infernotracter/NXP_2025/src_参考/RT1021-MENU-master1/README.en.md

# RT1021的CCD代码  +++  标志位菜单支持NXP，STC，英飞凌

#### Description
1.原创标志位菜单[支持NXP，STC，英飞凌]
2.NXP 的 ccd 图像处理 代码， 提供思路
3.无控制代码

#### Software Architecture
Software architecture description

#### Installation

1.  xxxx
2.  xxxx
3.  xxxx

#### Instructions

1.  xxxx
2.  xxxx
3.  xxxx

#### Contribution

1.  Fork the repository
2.  Create Feat_xxx branch
3.  Commit your code
4.  Create Pull Request

#### Gitee Feature

1.  You can use Readme\_XXX.md to support different languages, such as Readme\_en.md, Readme\_zh.md
2.  Gitee blog [blog.gitee.com](https://blog.gitee.com)
3.  Explore open source project [https://gitee.com/explore](https://gitee.com/explore)
4.  The most valuable open source project [GVP](https://gitee.com/gvp)
5.  The manual of Gitee [https://gitee.com/help](https://gitee.com/help)
6.  The most popular members  [https://gitee.com/gitee-stars/](https://gitee.com/gitee-stars/)
