infernotracter/NXP_2025/src_主要/NXP-master/README.md

# 第十九届智能车NXP组可达鸭开源

#### 介绍
第十九届智能车竞赛，国二NXP镜头组开源资料。包含车模、技术报告、代码、硬件电路。

#### 安装教程

1.  车模检测报告
2.  技术报告
3.  鼠鼠车机械结构
4.  历史软件

#### 参与贡献

在此特别感谢（排名不分先后）：
宿迁学院自由之翼佬、湘潭大学篮球佬、赣南科技学院菜狗佬、安徽理工大学搬砖佬、重庆交通大学马戏团佬、潍坊学院王佬、安徽师范大学Ca佬、山东师范大学青山佬、北方民族大学小明佬等等，还有其他没提到但是同样给予我偌大帮助的佬们。
从刚入学对电子产生浓厚的兴趣到取得国二成绩的这段路，没有TWU群里大佬的交流与帮助，就没有今天的可达鸭！
再次感谢所有帮助我的佬们！
