infernotracter/NXP_2025/src_参考/RT1021_Library-master#3/Example/例程使用说明.txt

例程的主要作用只是告诉大家如何使用各种库函数
因此例程内的库文件不一定是最新的，当通过库例程学习完之后
请使用Seekfree_RT1021_Opensource_Library开源库进行开发。
