infernotracter/NXP_2025/src_参考/RT1021_Library-master#3/【文档】说明书 芯片手册等/RT1021入门指南/入门指南中需要的其他文档/JLINK转接板教程.pdf

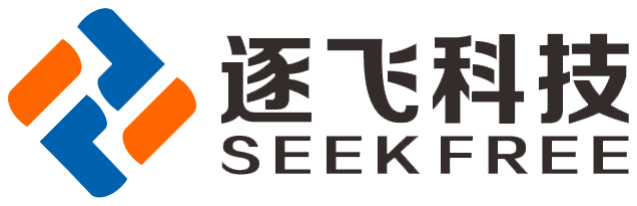
[picture p57: figure]

2019

# JLINK 转接板使用说明


JLINK 转接板使用说明 | 逐飞科技

目录

# 转接板与下载器如何连接

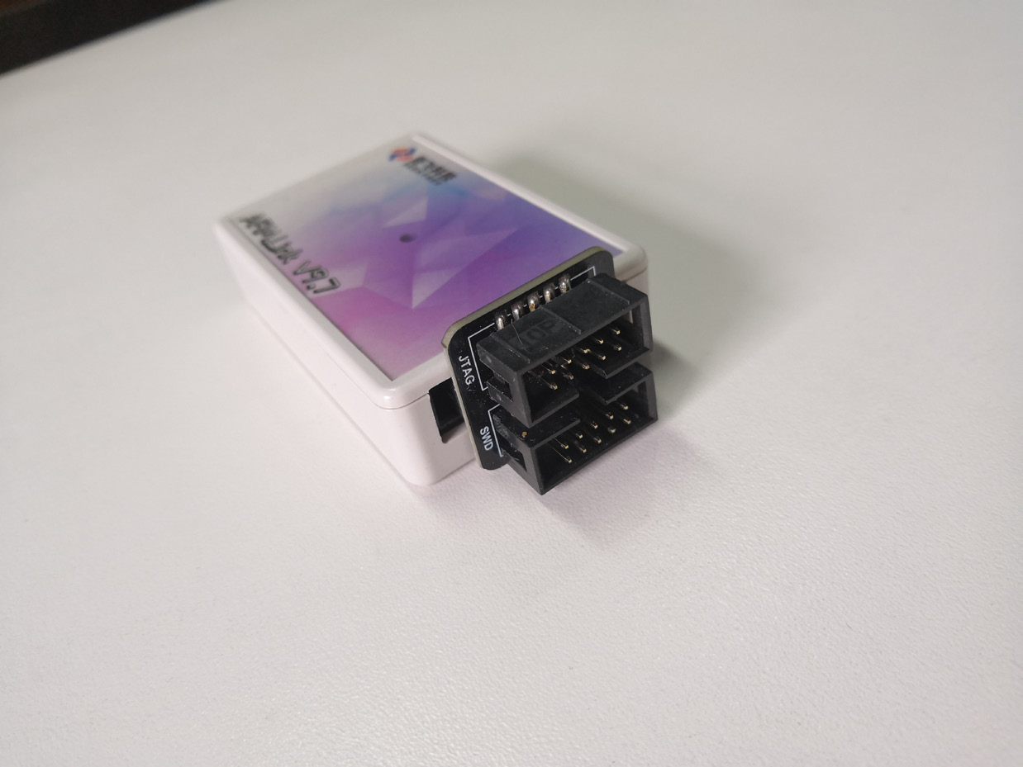
[picture p58: figure]

# 转接板与单片机如何连接

RT1021 核心板与转接板的链接如下图

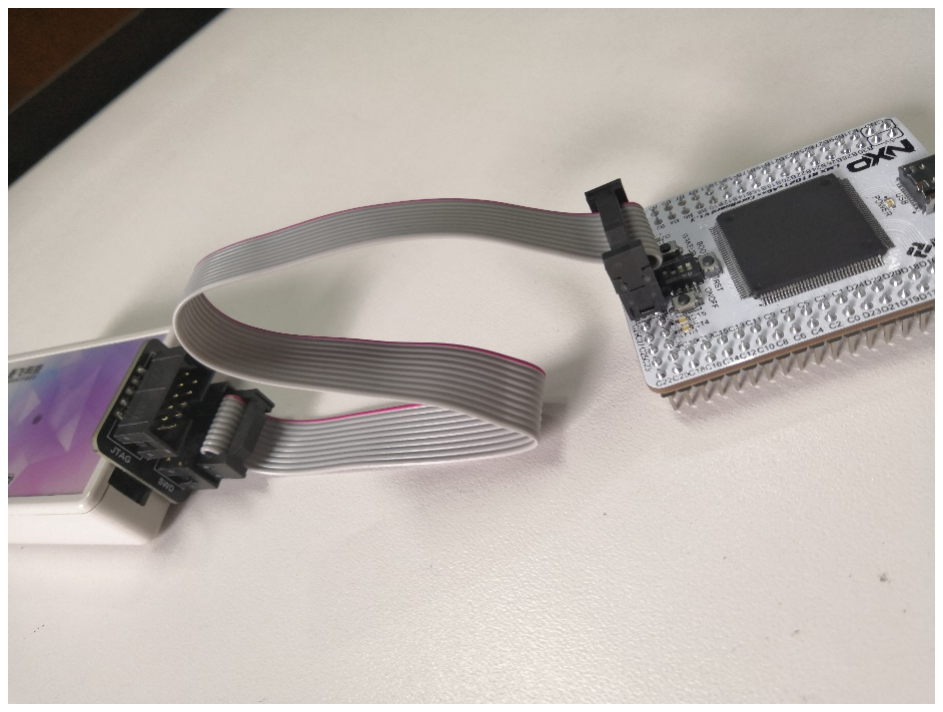
[picture p59: figure]

LPC54606 核心板与转接板的链接如下图

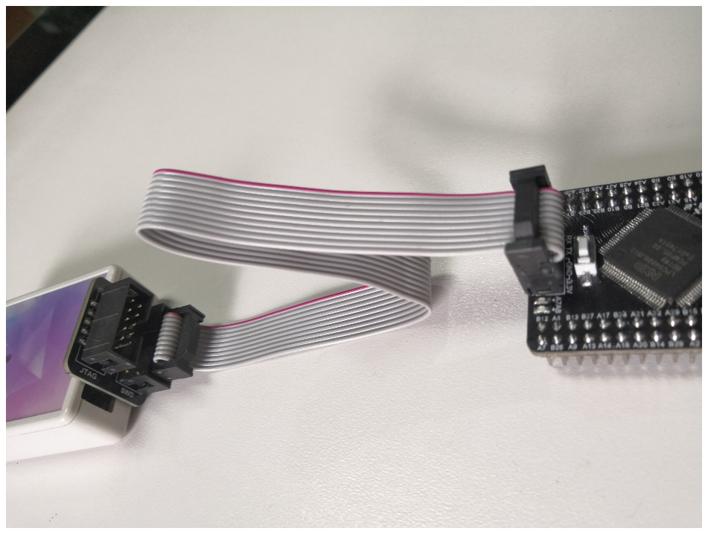
[picture p60: figure]

KEA 核心板与转接板的链接如下图

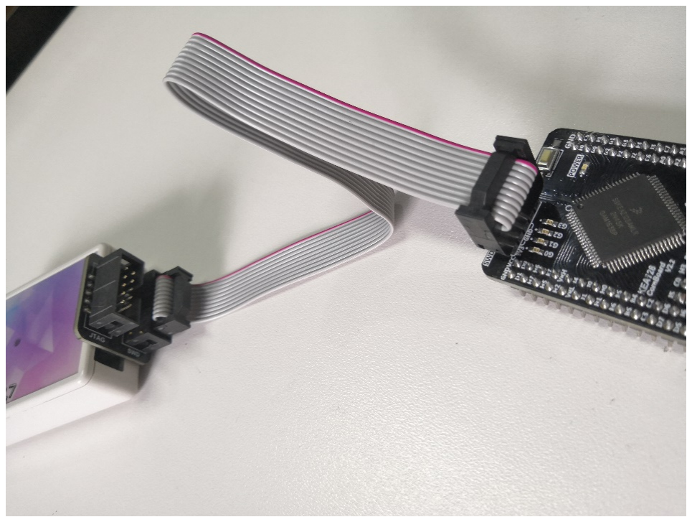
[picture p61: figure]

K60 144 引脚核心板与转接板的链接如下图

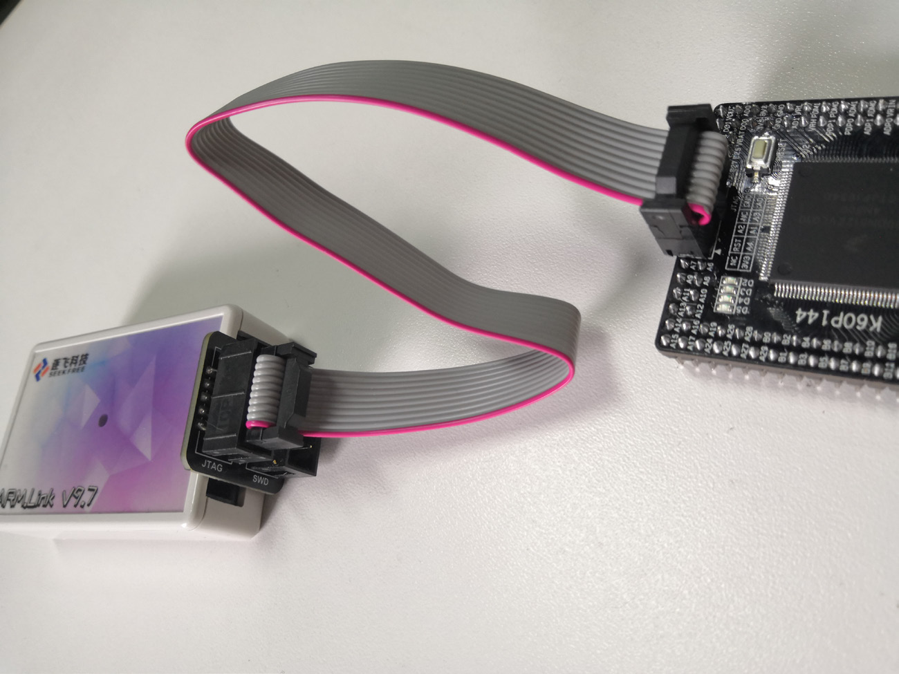
[picture p62: figure]

K60 100 引脚核心板与转接板的链接如下图

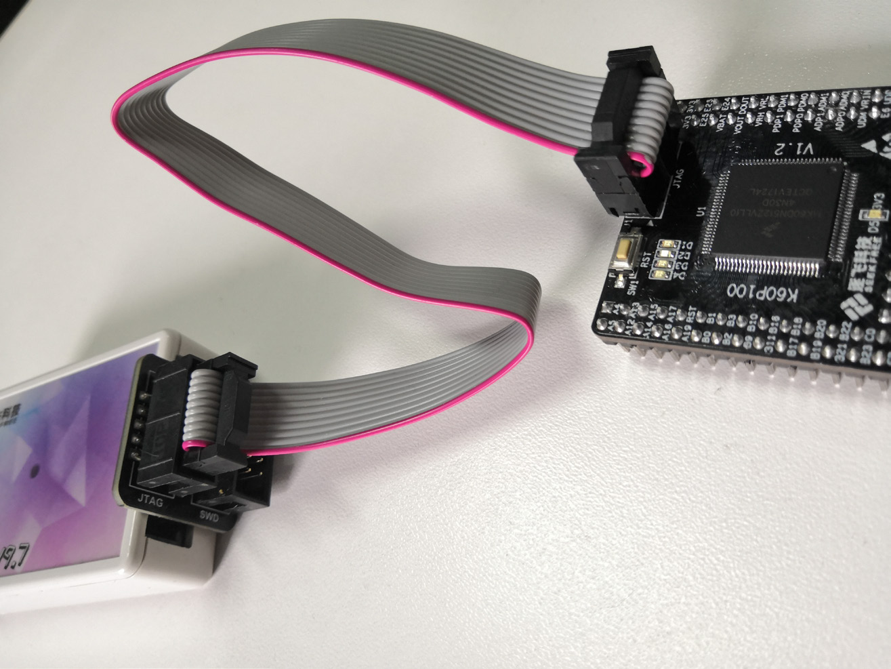
[picture p63: figure]

# 文档版本

版本号 | 日期 | 内容变更
V1.0 | 2019-03-15 | 初始版本。
