infernotracter/NXP_2025/src_主要/NXP-master/车模检测报告/前视图.jpg

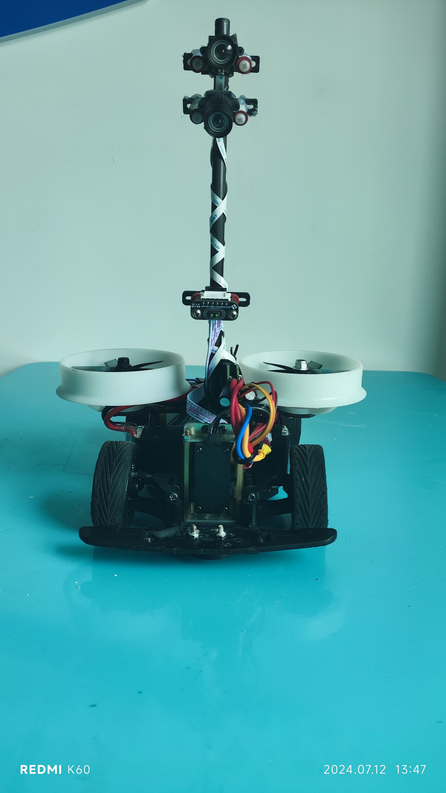
src_主要/NXP-master/车模检测报告/前视图.jpg
