infernotracter/NXP_2025/src_主要/RT1021 MicroPython核心板/【原理图】核心板原理图/【原理图】核心板原理图/RT1021 MicroPython 100P 引脚分配推荐表.png

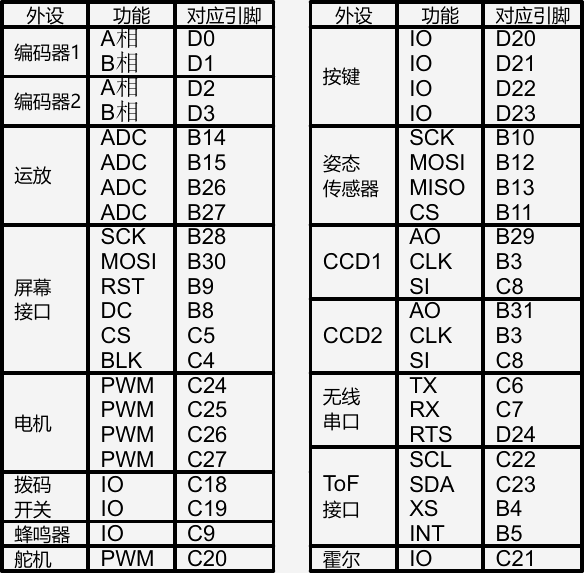
src_主要/RT1021 MicroPython核心板/【原理图】核心板原理图/【原理图】核心板原理图/RT1021 MicroPython 100P 引脚分配推荐表.png
