infernotracter/NXP_2025/src_主要/RT1021 MicroPython核心板/【文档】说明书 芯片手册等/1021MicroPython摄像头采集测试.png

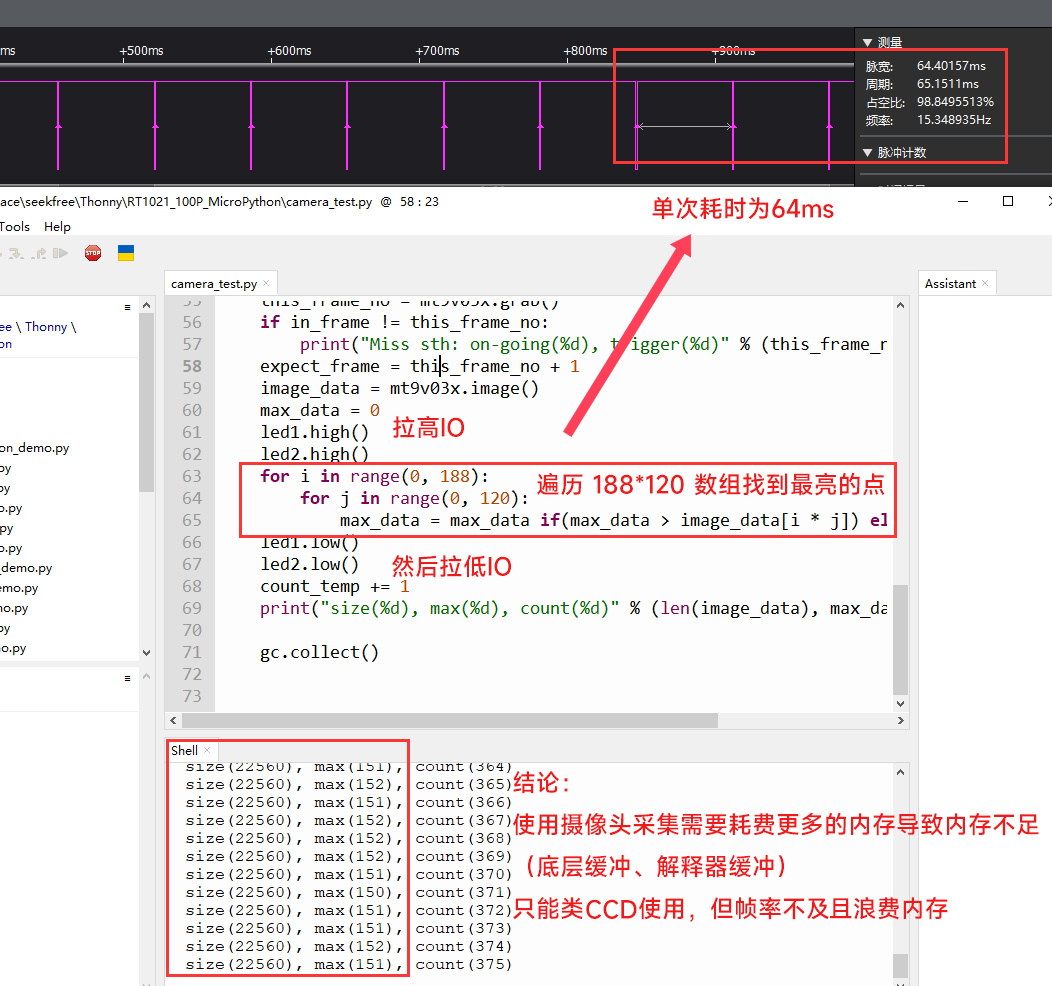
src_主要/RT1021 MicroPython核心板/【文档】说明书 芯片手册等/1021MicroPython摄像头采集测试.png
