infernotracter/NXP_2025/src_参考/2019-nxp-intelligent-car-master#3/matlab/1.bmp

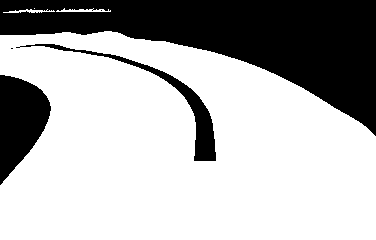
src_参考/2019-nxp-intelligent-car-master#3/matlab/1.bmp
