infernotracter/NXP_2025/src_参考/2019-nxp-intelligent-car-master#3/matlab/7.12赛道元素采集/出大环4.jpg

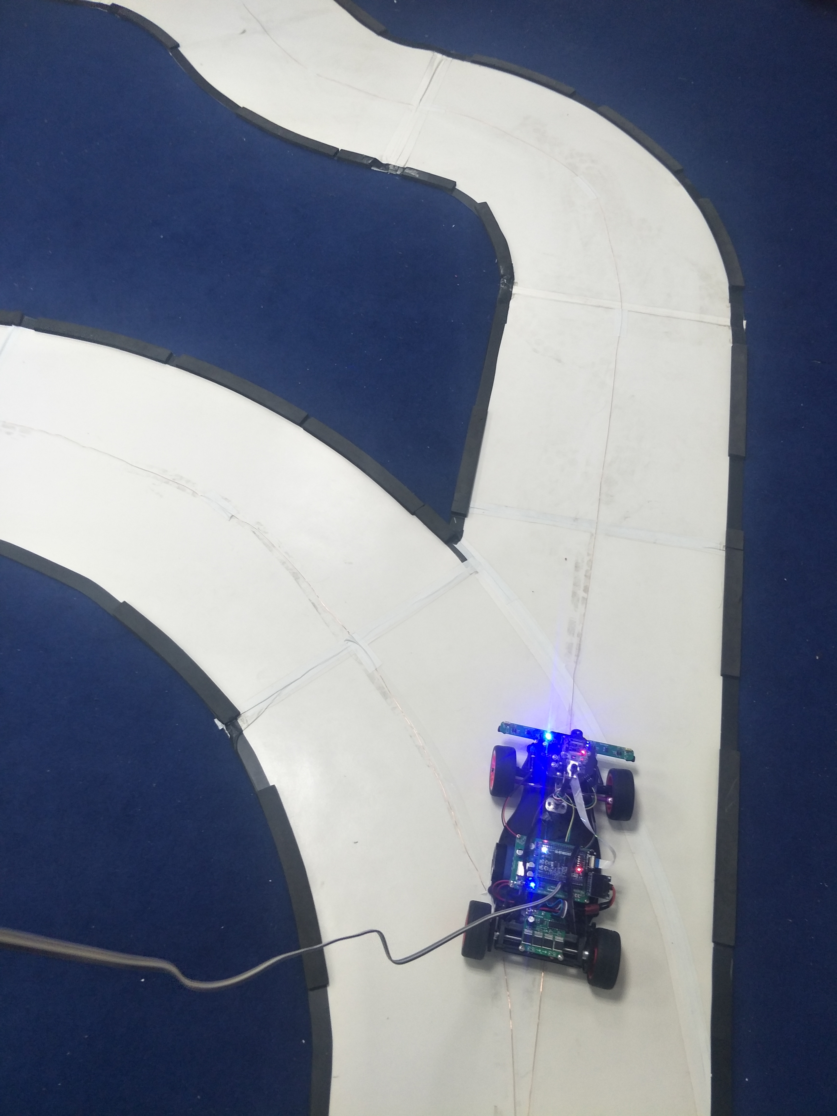
src_参考/2019-nxp-intelligent-car-master#3/matlab/7.12赛道元素采集/出大环4.jpg
