infernotracter/NXP_2025/src_参考/2019-nxp-intelligent-car-master#3/matlab/IMGtest.bmp

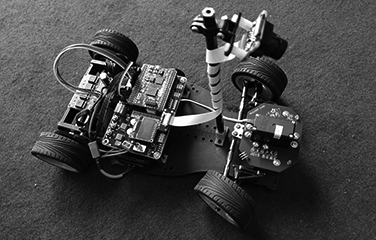
src_参考/2019-nxp-intelligent-car-master#3/matlab/IMGtest.bmp
