infernotracter/NXP_2025/src_参考/2019-nxp-intelligent-car-master#3/matlab/图像特征/十字.jpg

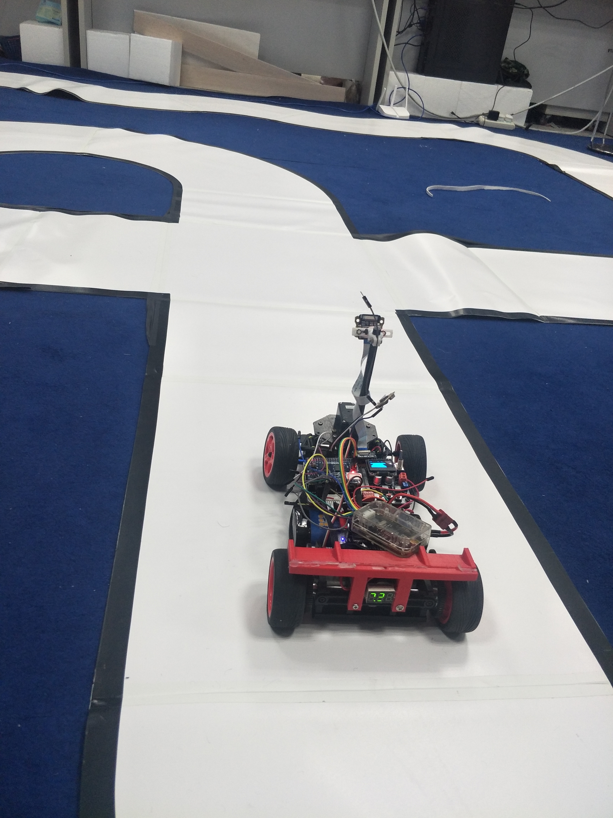
src_参考/2019-nxp-intelligent-car-master#3/matlab/图像特征/十字.jpg
