infernotracter/NXP_2025/src_参考/2019-nxp-intelligent-car-master#3/matlab/电机测试/0.2-0.1（肉眼可见不错）.txt.jpg

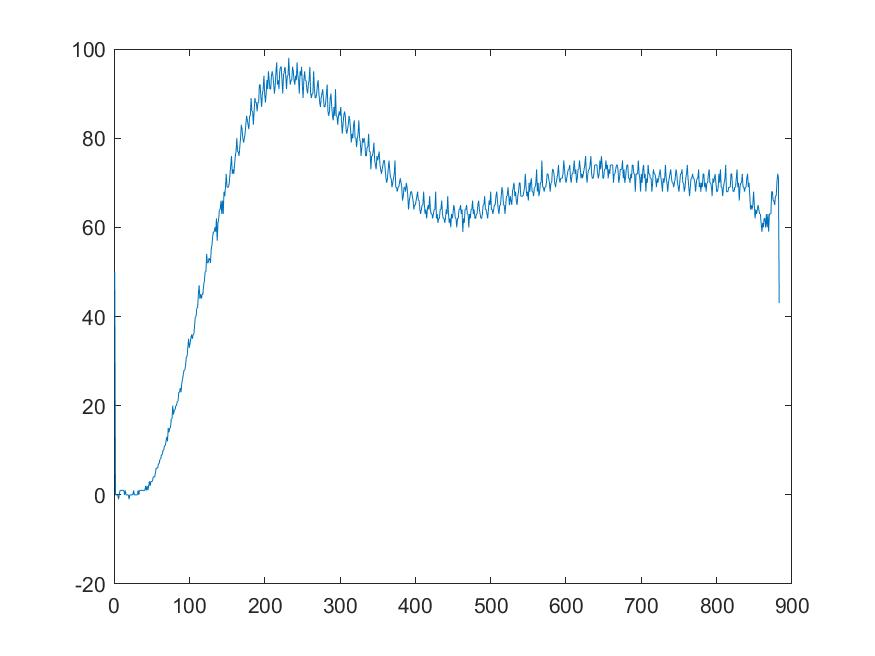
src_参考/2019-nxp-intelligent-car-master#3/matlab/电机测试/0.2-0.1（肉眼可见不错）.txt.jpg
