infernotracter/NXP_2025/src_参考/2019-nxp-intelligent-car-master#3/matlab/电机测试/0.5-0.1.txt.jpg

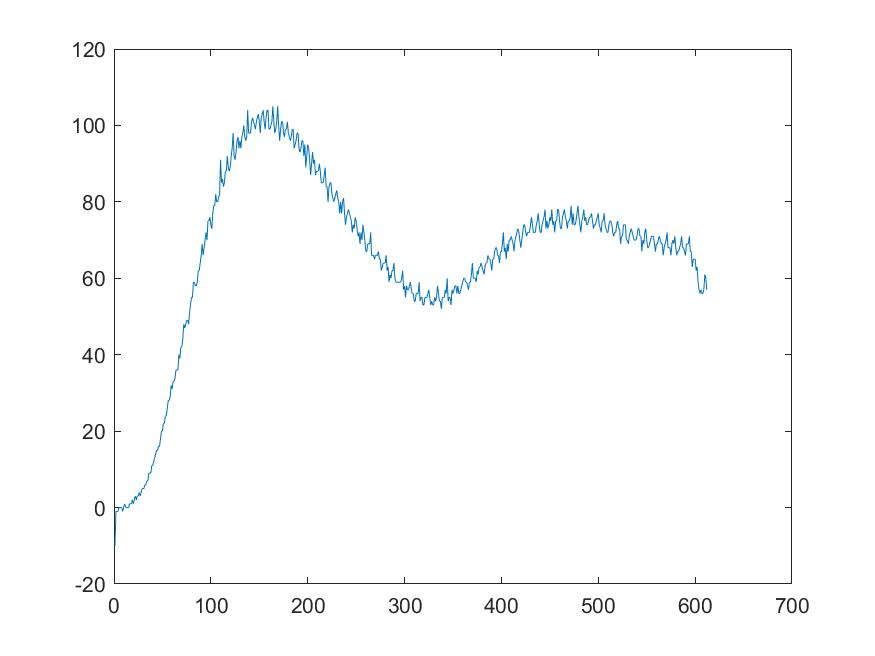
src_参考/2019-nxp-intelligent-car-master#3/matlab/电机测试/0.5-0.1.txt.jpg
