infernotracter/NXP_2025/src_参考/2019-nxp-intelligent-car-master#3/matlab/电机测试/1.0-0.2.txt.jpg

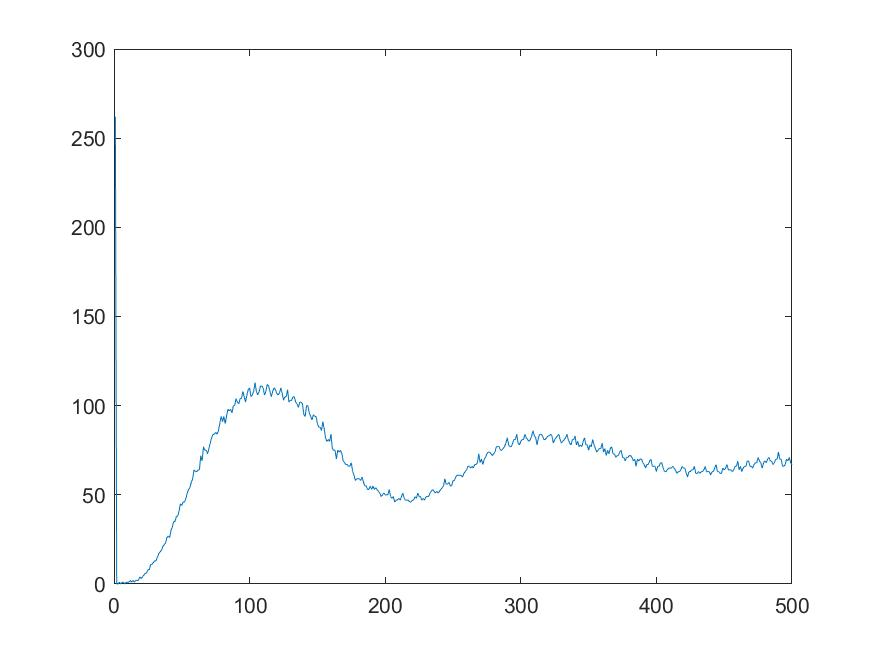
src_参考/2019-nxp-intelligent-car-master#3/matlab/电机测试/1.0-0.2.txt.jpg
