infernotracter/NXP_2025/src_参考/2019-nxp-intelligent-car-master#3/matlab/道路类型判断/2.bmp

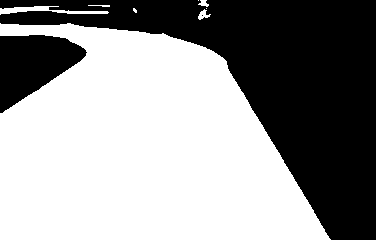
src_参考/2019-nxp-intelligent-car-master#3/matlab/道路类型判断/2.bmp
