infernotracter/NXP_2025/src_参考/2019-nxp-intelligent-car-master#3/matlab/道路类型判断/7.12.BMP

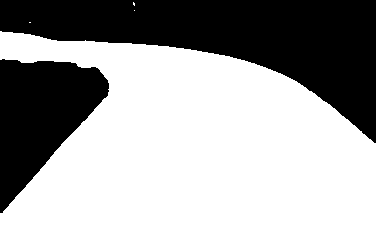
src_参考/2019-nxp-intelligent-car-master#3/matlab/道路类型判断/7.12.BMP
