infernotracter/NXP_2025/src_参考/CCD_Smart_Car-main/FullCircle.gif

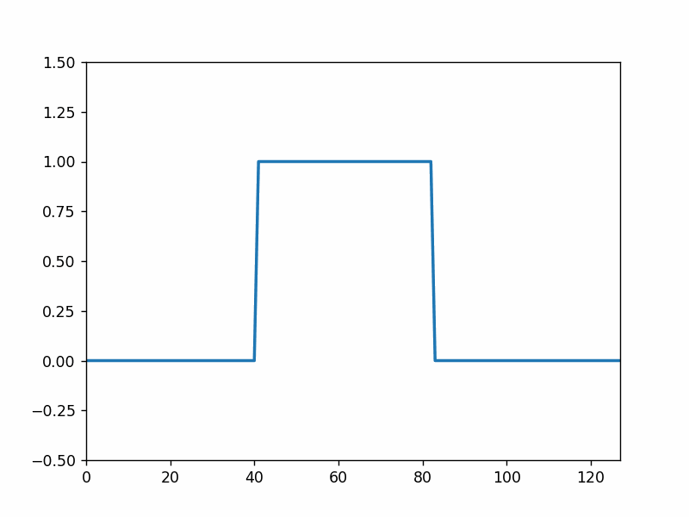
src_参考/CCD_Smart_Car-main/FullCircle.gif
