infernotracter/NXP_2025/src_参考/RT1021-MENU-master1/菜单形式.png

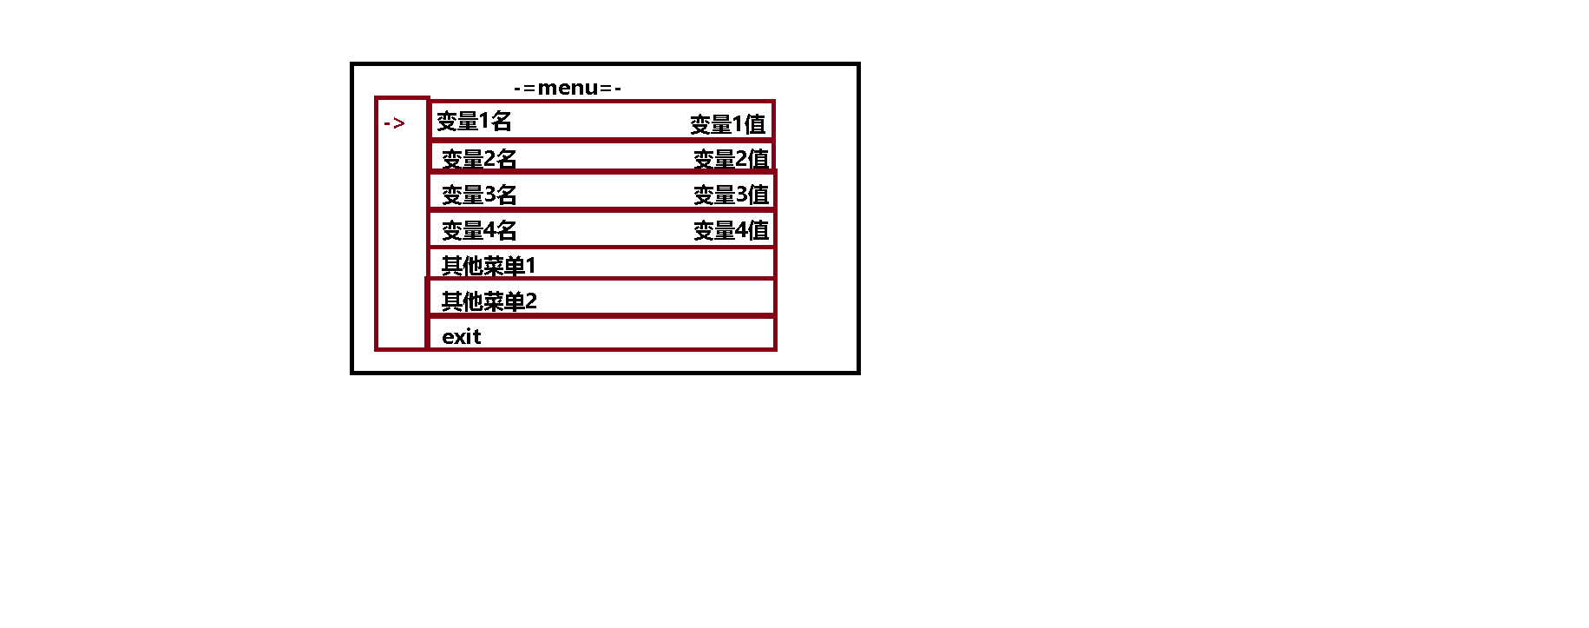
src_参考/RT1021-MENU-master1/菜单形式.png
