infernotracter/NXP_2025/src_参考/smart-car-main1/PCB/SCH_openart显示屏转接板_1-Sheet_1_2023-07-10.png

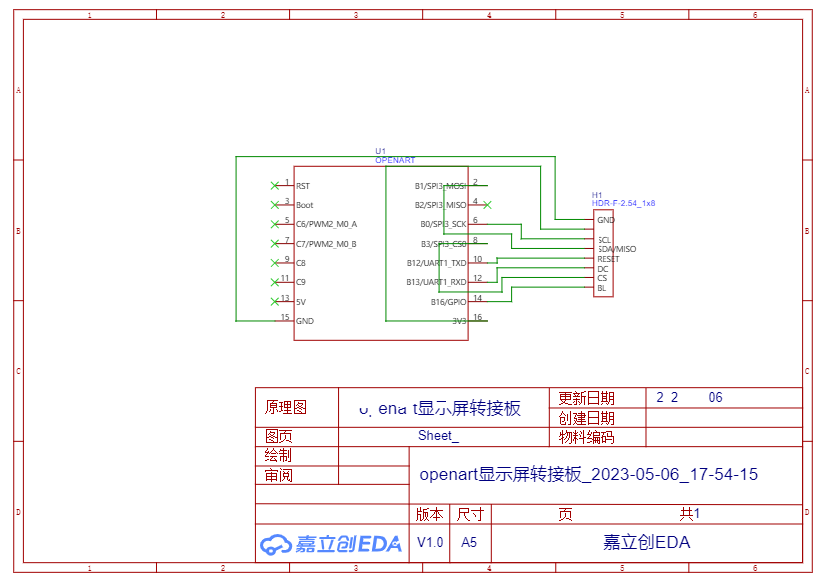
src_参考/smart-car-main1/PCB/SCH_openart显示屏转接板_1-Sheet_1_2023-07-10.png
