infernotracter/NXP_2025/src_参考/smart-car-main1/PCB/SCH_主板_1_1-rt0164主板原理图_2023-07-10.png

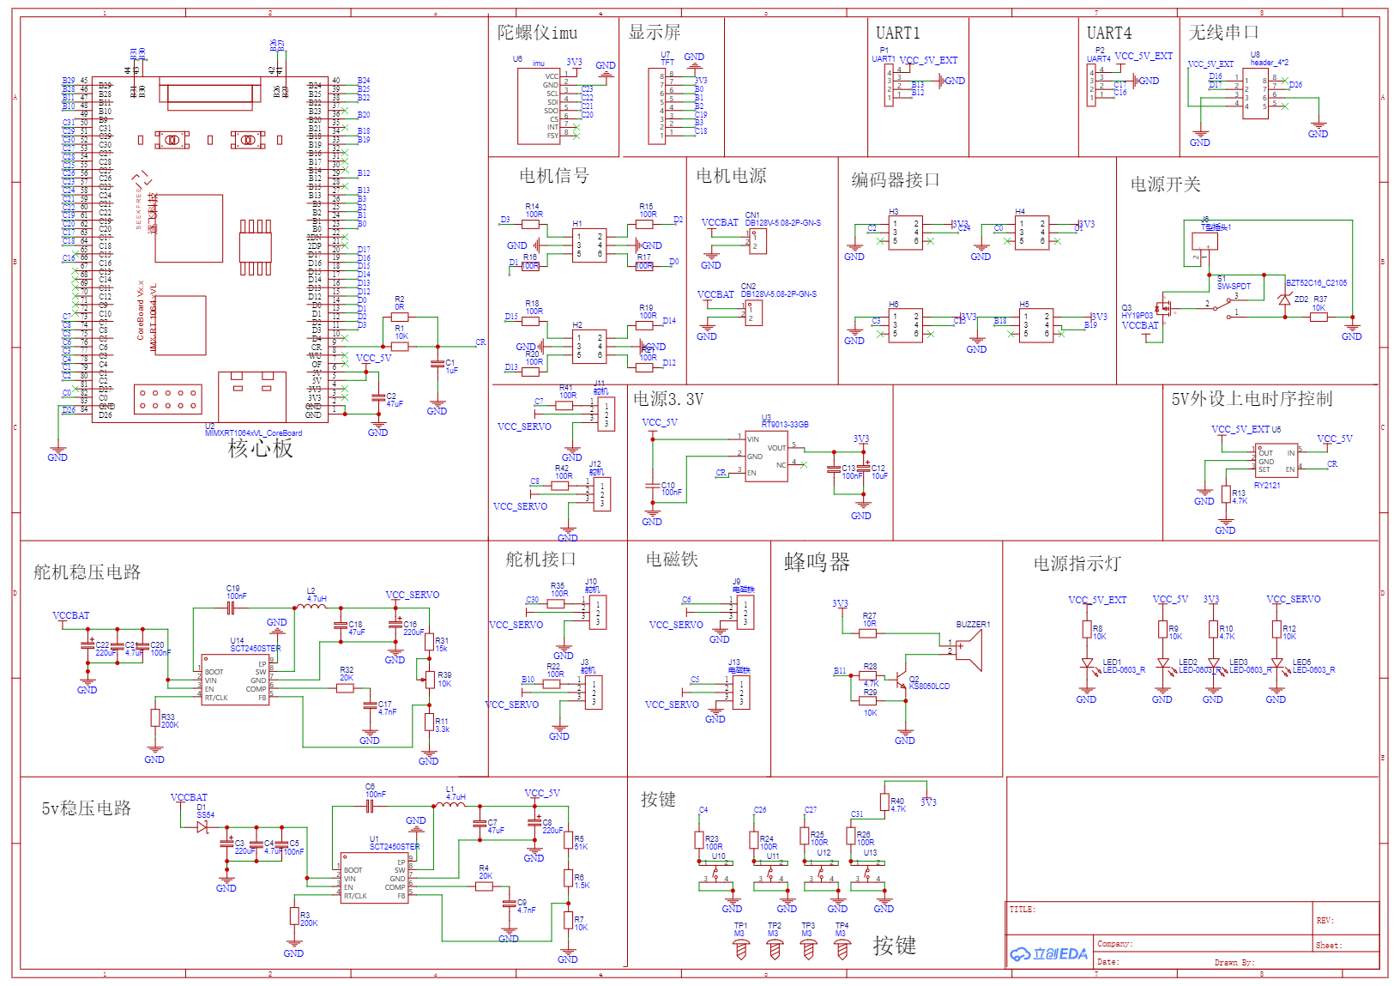
src_参考/smart-car-main1/PCB/SCH_主板_1_1-rt0164主板原理图_2023-07-10.png
