infernotracter/NXP_2025/src_参考/smart-car-main1/PCB/SCH_主板_2_2-rt0164主板原理图_2023-08-16.png

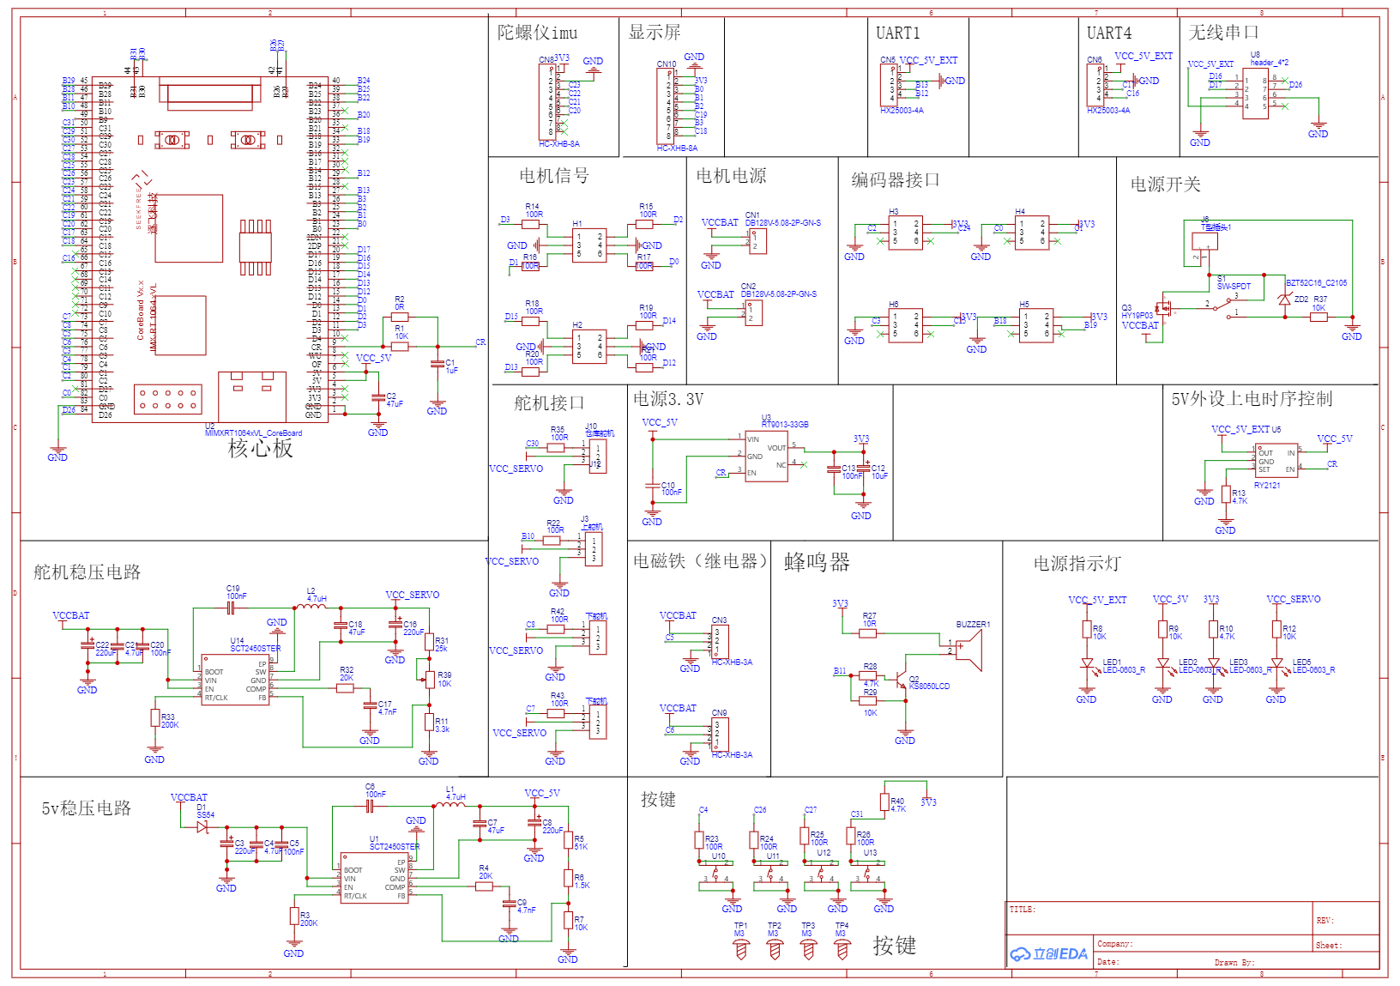
src_参考/smart-car-main1/PCB/SCH_主板_2_2-rt0164主板原理图_2023-08-16.png
