infernotracter/NXP_2025/src_参考/smart-car-main1/PCB/SCH_驱动板_1-DRV8701_2023-07-10.png

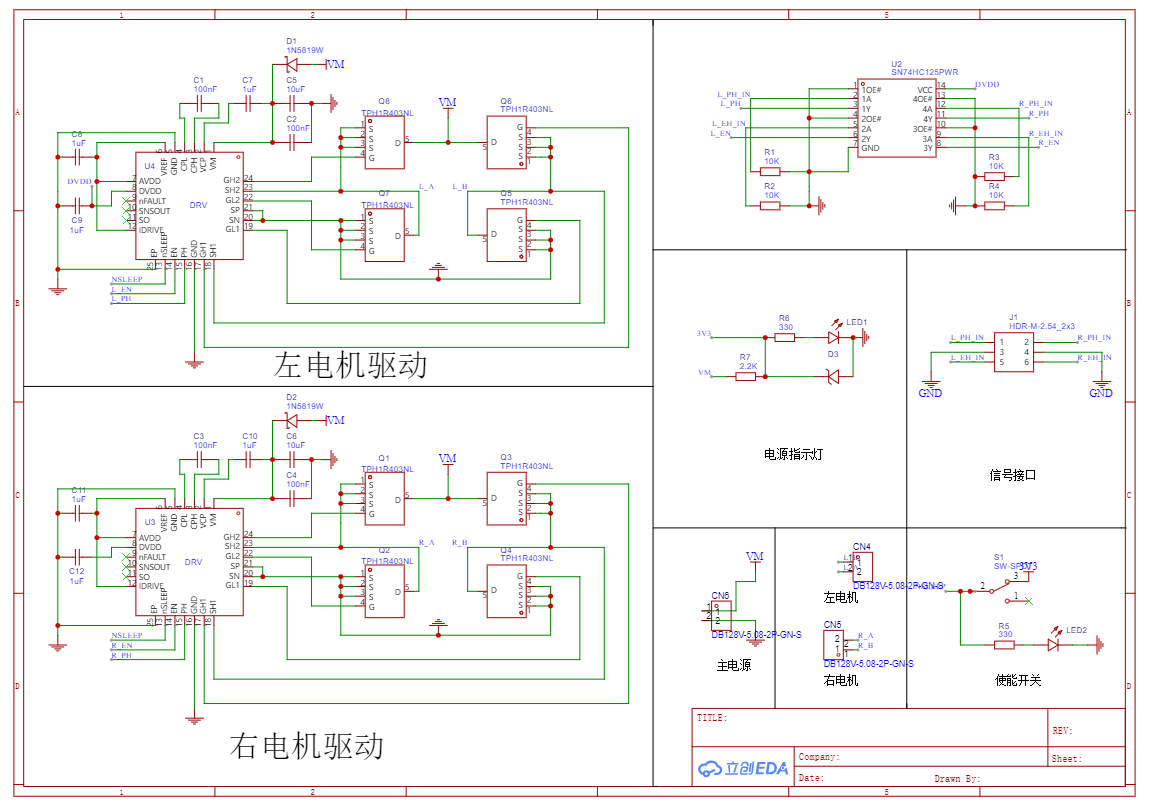
src_参考/smart-car-main1/PCB/SCH_驱动板_1-DRV8701_2023-07-10.png
