infernotracter/NXP_2025/src_参考/smart-car-main1/PCB/继电器原理图.png

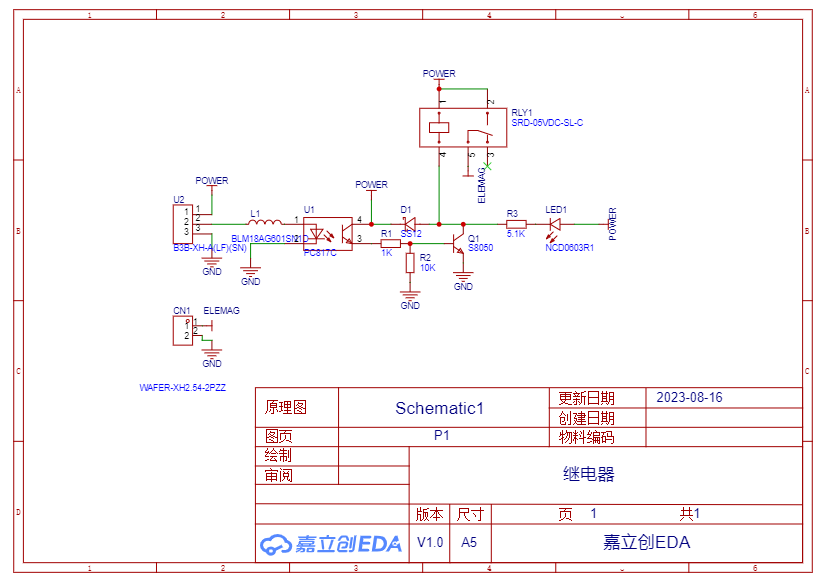
src_参考/smart-car-main1/PCB/继电器原理图.png
