infernotracter/NXP_2025/src_参考/RT1021_Library-master#3/Example/12-Specify Variable Position Demo/RT1021端口对应表格.xlsx

GPIO编号 | PAD名称
RT1021 没有端口A 端口E
B0 | GPIO_AD_B0_00
B1 | GPIO_AD_B0_01
B2 | GPIO_AD_B0_02
B3 | GPIO_AD_B0_03
B4 | GPIO_AD_B0_04
B5 | GPIO_AD_B0_05
B6 | GPIO_AD_B0_06
B7 | GPIO_AD_B0_07
B8 | GPIO_AD_B0_08
B9 | GPIO_AD_B0_09
B10 | GPIO_AD_B0_10
B11 | GPIO_AD_B0_11
B12 | GPIO_AD_B0_12
B13 | GPIO_AD_B0_13
B14 | GPIO_AD_B0_14
B15 | GPIO_AD_B0_15
B16 | GPIO_AD_B1_00
B17 | GPIO_AD_B1_01
B18 | GPIO_AD_B1_02
B19 | GPIO_AD_B1_03
B20 | GPIO_AD_B1_04
B21 | GPIO_AD_B1_05
B22 | GPIO_AD_B1_06
B23 | GPIO_AD_B1_07
B24 | GPIO_AD_B1_08
B25 | GPIO_AD_B1_09
B26 | GPIO_AD_B1_10
B27 | GPIO_AD_B1_11
B28 | GPIO_AD_B1_12
B29 | GPIO_AD_B1_13
B30 | GPIO_AD_B1_14
B31 | GPIO_AD_B1_15
C0 | GPIO_EMC_00
C1 | GPIO_EMC_01
C2 | GPIO_EMC_02
C3 | GPIO_EMC_03
C4 | GPIO_EMC_04
C5 | GPIO_EMC_05
C6 | GPIO_EMC_06
C7 | GPIO_EMC_07
C8 | GPIO_EMC_08
C9 | GPIO_EMC_09
C10 | GPIO_EMC_10
C11 | GPIO_EMC_11
C12 | GPIO_EMC_12
C13 | GPIO_EMC_13
C14 | GPIO_EMC_14
C15 | GPIO_EMC_15
C16 | GPIO_EMC_16
C17 | GPIO_EMC_17
C18 | GPIO_EMC_18
C19 | GPIO_EMC_19
C20 | GPIO_EMC_20
C21 | GPIO_EMC_21
C22 | GPIO_EMC_22
C23 | GPIO_EMC_23
C24 | GPIO_EMC_24
C25 | GPIO_EMC_25
C26 | GPIO_EMC_26
C27 | GPIO_EMC_27
C28 | GPIO_EMC_28
C29 | GPIO_EMC_29
C30 | GPIO_EMC_30
C31 | GPIO_EMC_31
D0 | GPIO_EMC_32
D1 | GPIO_EMC_33
D2 | GPIO_EMC_34
D3 | GPIO_EMC_35
D4 | GPIO_EMC_36
D5 | GPIO_EMC_37
D6 | GPIO_EMC_38
D7 | GPIO_EMC_39
D8 | GPIO_EMC_40
D9 | GPIO_EMC_41
D10 | 没有此引脚
D11 | 没有此引脚
D12 | 没有此引脚
D13 | GPIO_SD_B0_00
D14 | GPIO_SD_B0_01
D15 | GPIO_SD_B0_02
D16 | GPIO_SD_B0_03
D17 | GPIO_SD_B0_04
D18 | GPIO_SD_B0_05
D19 | GPIO_SD_B0_06
D20 | GPIO_SD_B1_00
D21 | GPIO_SD_B1_01
D22 | GPIO_SD_B1_02
D23 | GPIO_SD_B1_03
D24 | GPIO_SD_B1_04
D25 | GPIO_SD_B1_05
D26 | GPIO_SD_B1_06
D27 | GPIO_SD_B1_07
D28 | GPIO_SD_B1_08
D29 | GPIO_SD_B1_09
D30 | GPIO_SD_B1_10
D31 | GPIO_SD_B1_11
