infernotracter/NXP_2025/src_主要/NXP-master/鼠鼠车机械结构/轮胎/一体模具.SLDASM

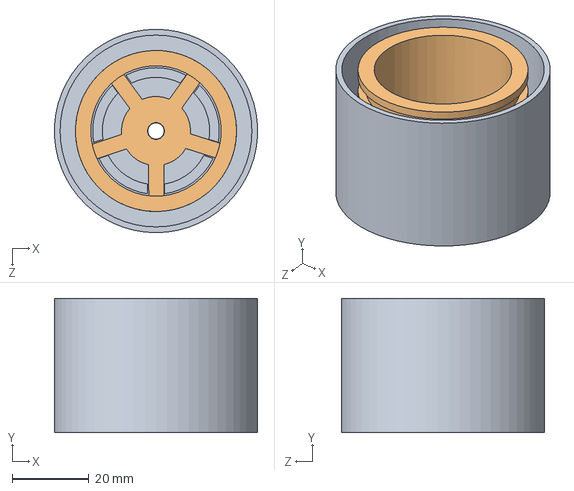
[picture p141: CAD file, 2025-02-13]
src_主要/NXP-master/鼠鼠车机械结构/轮胎/一体模具.SLDASM
52.9 x 35.0 x 53.0 mm
模具外壁
模具车轮
