infernotracter/NXP_2025/src_参考/smart-car-main1/model/智能视觉车四分类/智能视觉车1.SLDASM

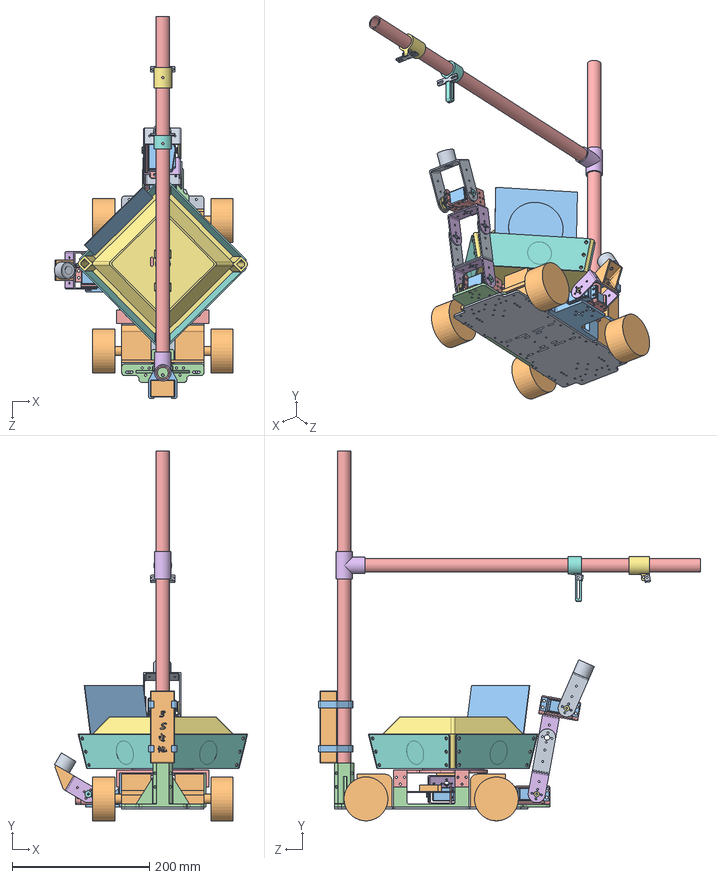
[picture p142: CAD file, 2025-02-19]
src_参考/smart-car-main1/model/智能视觉车四分类/智能视觉车1.SLDASM
282.1 x 539.5 x 557.5 mm
M车底盘
电机替代 x 2
舵机1 x 4
前机械臂支架
万能支架 x 3
短U支架 x 3
舵盘 x 4
杯式轴承 x 3
长U支架 x 2
电路板底板
左侧支架
右侧支架
储物仓支架
推力轴承
储物仓
仓门 x 4
电磁铁 x 2
电磁铁支架
卡片
摄像头支架底pvc
pvc管 x 2
pvc三通
摄像头支架1pvc
摄像头支架2pvc
逐飞摄像头支架连接件 x 2
电池
电池扣 x 2
