infernotracter/NXP_2025/src_主要/NXP-master/鼠鼠车机械结构/侧壁/电老鼠.SLDPRT

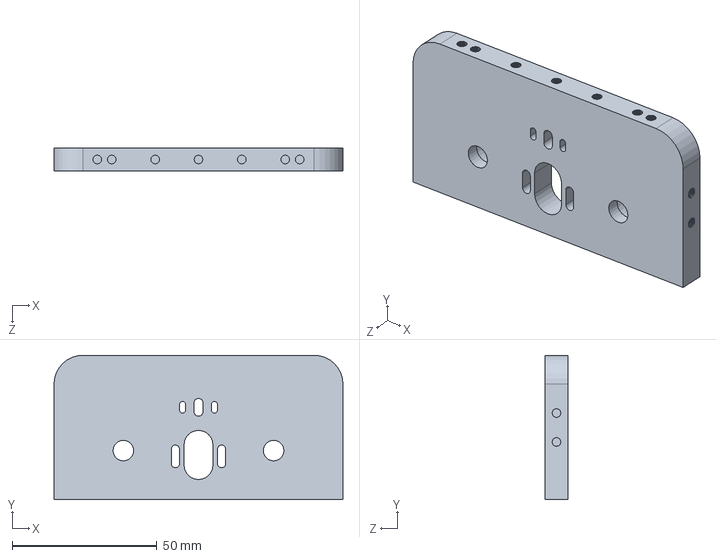
[picture p143: CAD file, 2025-02-13]
src_主要/NXP-master/鼠鼠车机械结构/侧壁/电老鼠.SLDPRT
100.0 x 50.0 x 8.00 mm
