infernotracter/NXP_2025/src_主要/NXP-master/鼠鼠车机械结构/底盘/底板.SLDPRT

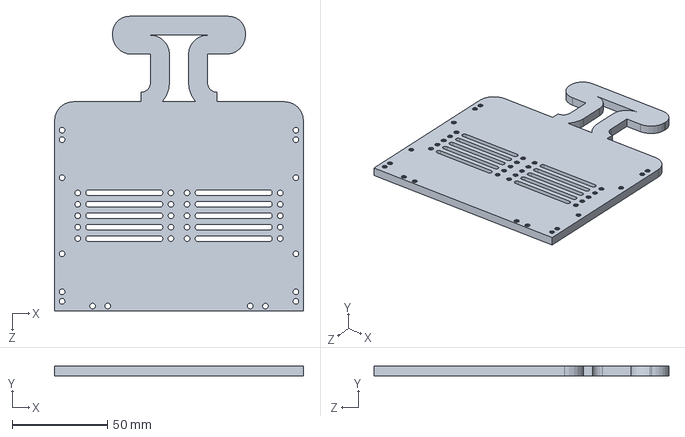
[picture p144: CAD file, 2025-02-13]
src_主要/NXP-master/鼠鼠车机械结构/底盘/底板.SLDPRT
131.0 x 5.00 x 155.0 mm
