infernotracter/NXP_2025/src_主要/NXP-master/鼠鼠车机械结构/桨叶/桨叶.SLDPRT

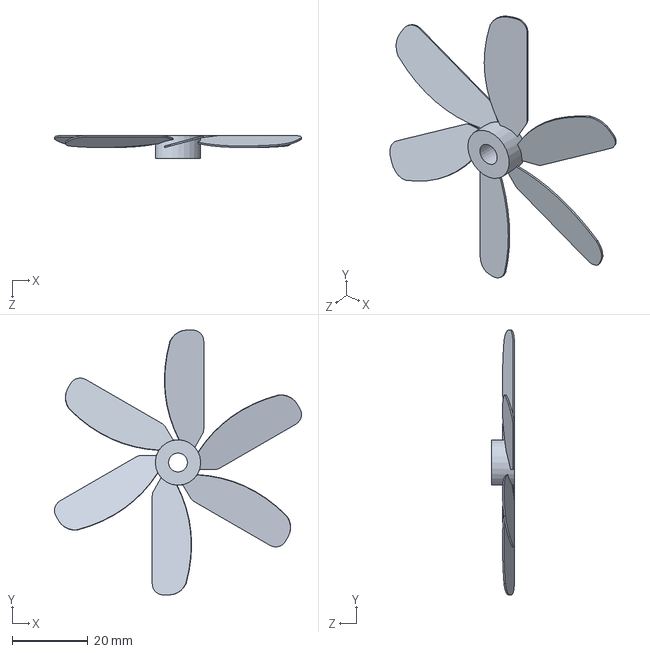
[picture p145: CAD file, 2025-02-13]
src_主要/NXP-master/鼠鼠车机械结构/桨叶/桨叶.SLDPRT
65.3 x 70.0 x 6.00 mm
