infernotracter/NXP_2025/src_主要/NXP-master/鼠鼠车机械结构/电机/rs380 motor.SLDPRT

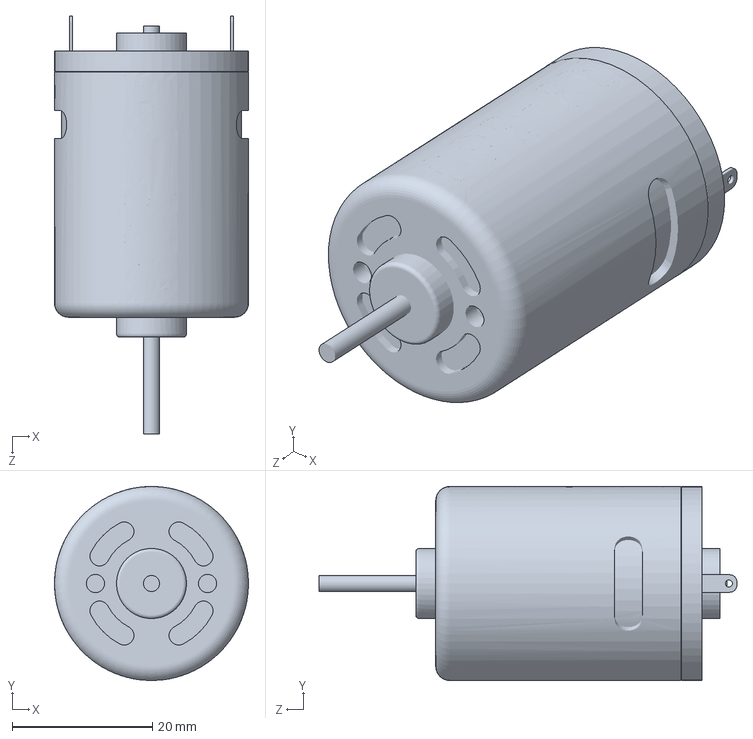
[picture p146: CAD file, 2025-02-13]
src_主要/NXP-master/鼠鼠车机械结构/电机/rs380 motor.SLDPRT
27.7 x 27.7 x 59.7 mm
