infernotracter/NXP_2025/src_主要/NXP-master/鼠鼠车机械结构/齿轮/齿轮.SLDPRT

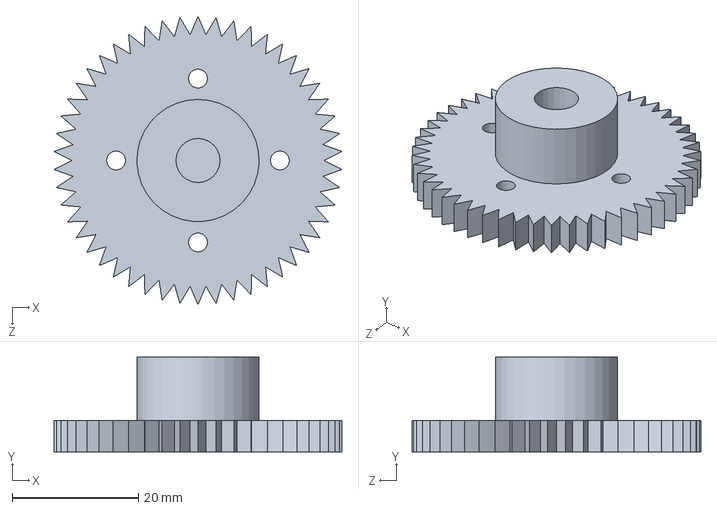
[picture p147: CAD file, 2025-02-13]
src_主要/NXP-master/鼠鼠车机械结构/齿轮/齿轮.SLDPRT
45.7 x 15.0 x 45.8 mm
