infernotracter/NXP_2025/src_参考/smart-car-main1/model/智能视觉车四分类/电磁铁支架.SLDPRT

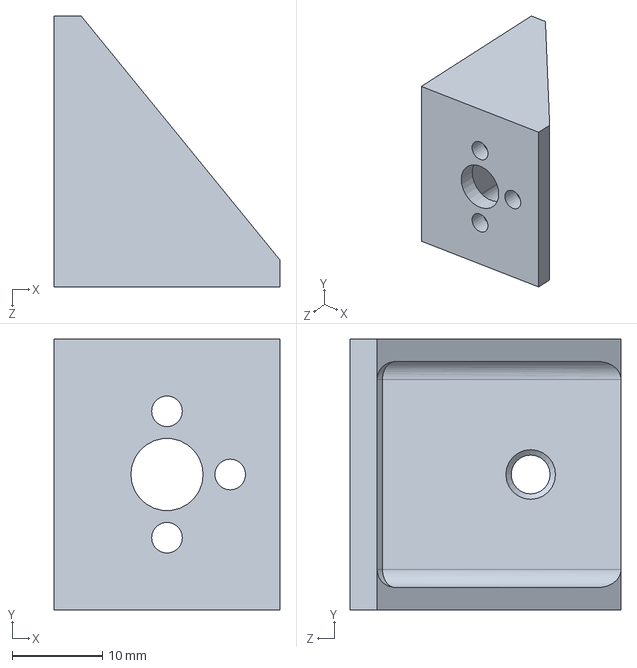
[picture p148: CAD file, 2025-02-19]
src_参考/smart-car-main1/model/智能视觉车四分类/电磁铁支架.SLDPRT
25.0 x 30.0 x 30.0 mm
