infernotracter/NXP_2025/src_主要/NXP-master/鼠鼠车机械结构/侧壁/侧壁.SLDPRT

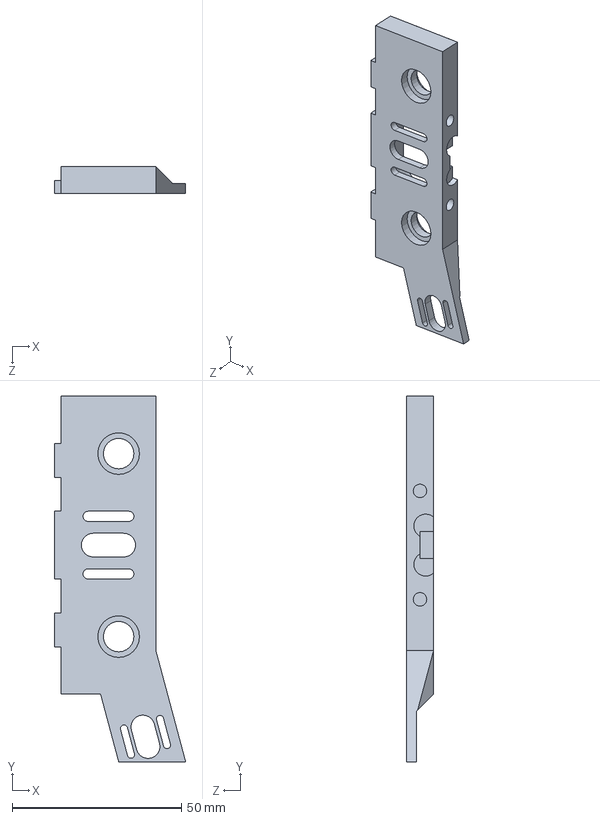
[picture p149: CAD file, 2025-02-13]
src_主要/NXP-master/鼠鼠车机械结构/侧壁/侧壁.SLDPRT
38.8 x 108.0 x 8.00 mm
