infernotracter/NXP_2025/src_主要/NXP-master/鼠鼠车机械结构/底盘/底盘.SLDPRT

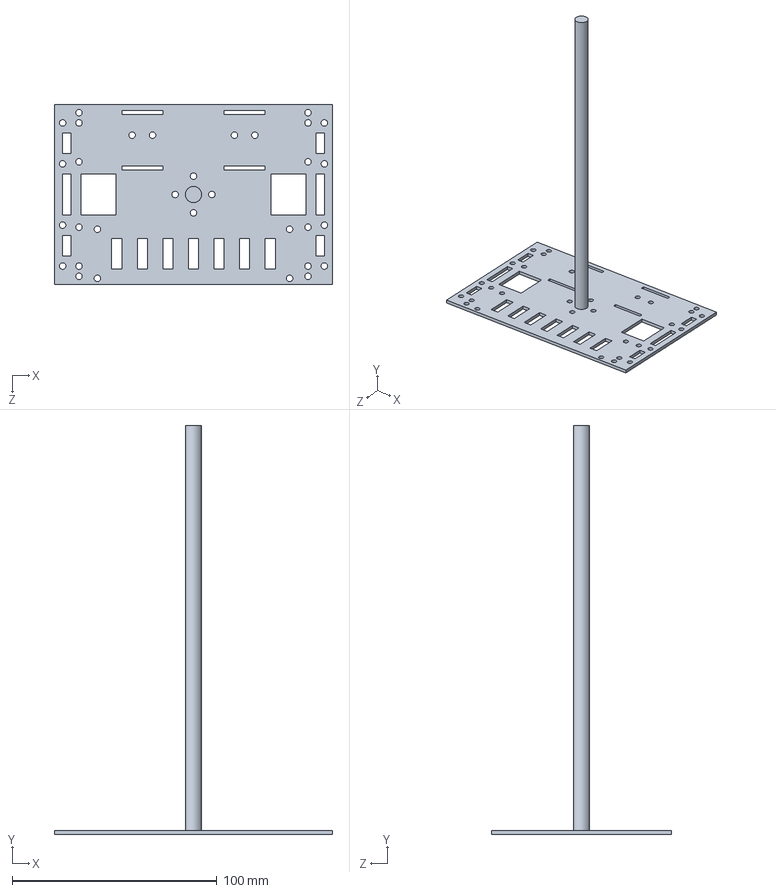
[picture p150: CAD file, 2025-02-13]
src_主要/NXP-master/鼠鼠车机械结构/底盘/底盘.SLDPRT
136.0 x 200.0 x 88.0 mm
