infernotracter/NXP_2025/src_主要/NXP-master/鼠鼠车机械结构/桨叶/保护罩子.SLDPRT

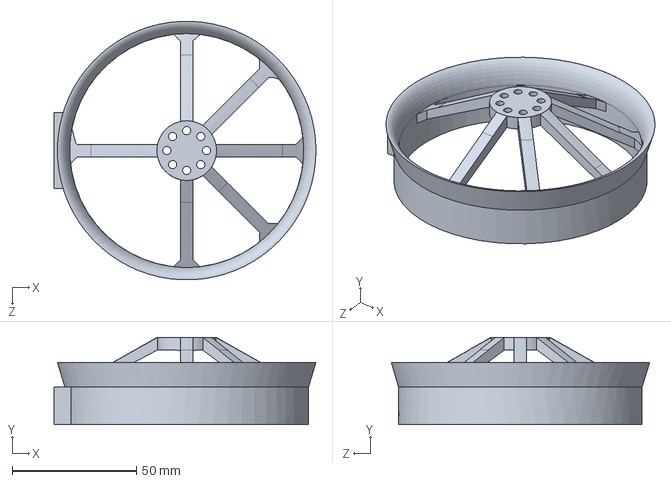
[picture p151: CAD file, 2025-02-13]
src_主要/NXP-master/鼠鼠车机械结构/桨叶/保护罩子.SLDPRT
105.4 x 35.0 x 104.0 mm
