infernotracter/NXP_2025/src_主要/NXP-master/鼠鼠车机械结构/电机/电机.SLDPRT

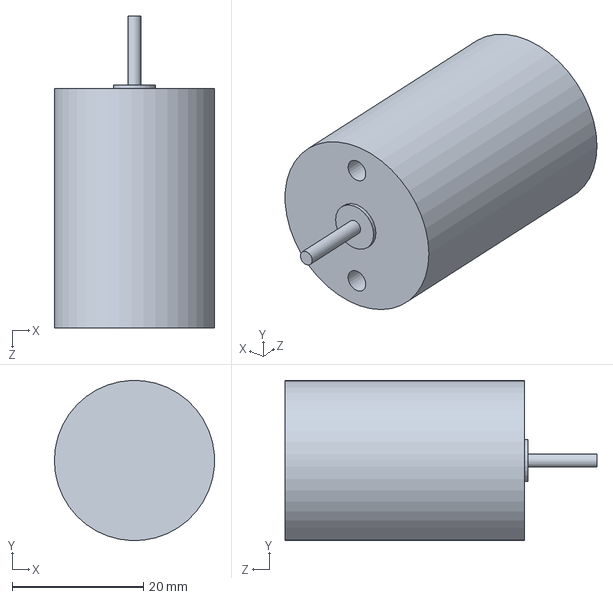
[picture p152: CAD file, 2025-02-13]
src_主要/NXP-master/鼠鼠车机械结构/电机/电机.SLDPRT
24.4 x 24.4 x 47.5 mm
