infernotracter/NXP_2025/src_主要/NXP-master/鼠鼠车机械结构/轮胎/模具外壁.SLDPRT

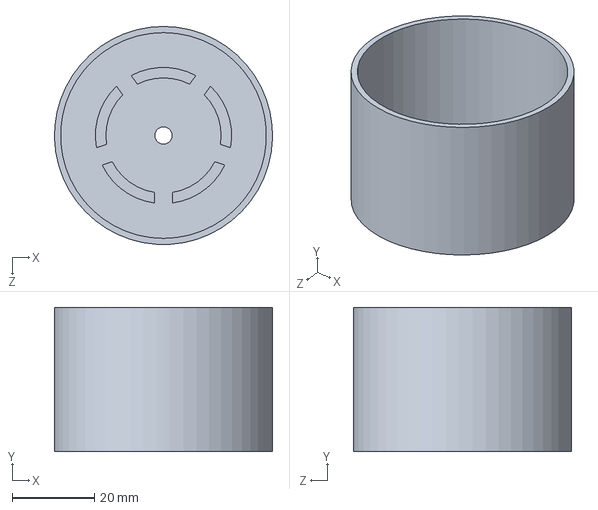
[picture p153: CAD file, 2025-02-13]
src_主要/NXP-master/鼠鼠车机械结构/轮胎/模具外壁.SLDPRT
53.0 x 35.0 x 53.0 mm
