infernotracter/NXP_2025/src_主要/NXP-master/鼠鼠车机械结构/齿轮/齿轮v2.STL

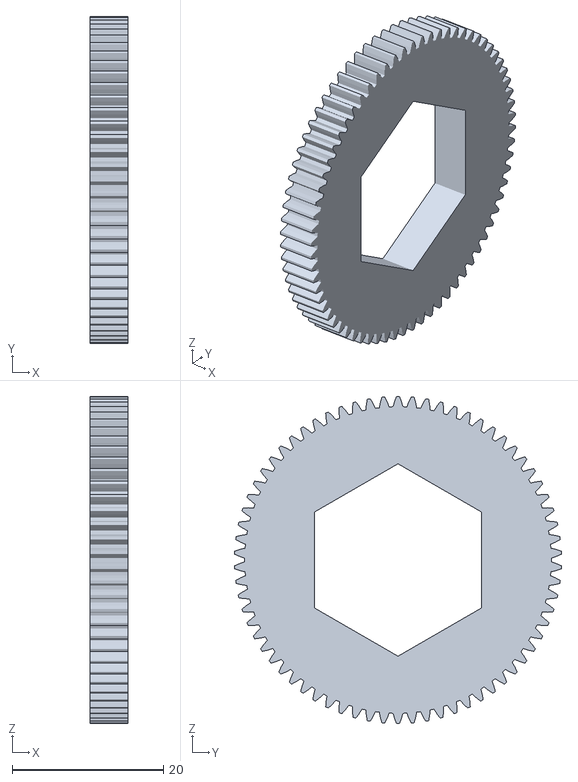
[picture p154: CAD file, 2025-02-13]
src_主要/NXP-master/鼠鼠车机械结构/齿轮/齿轮v2.STL
5.00 x 43.2 x 43.2
