infernotracter/NXP_2025/src_参考/smart-car-main1/model/智能视觉车四分类/逐飞摄像头支架连接件.SLDPRT

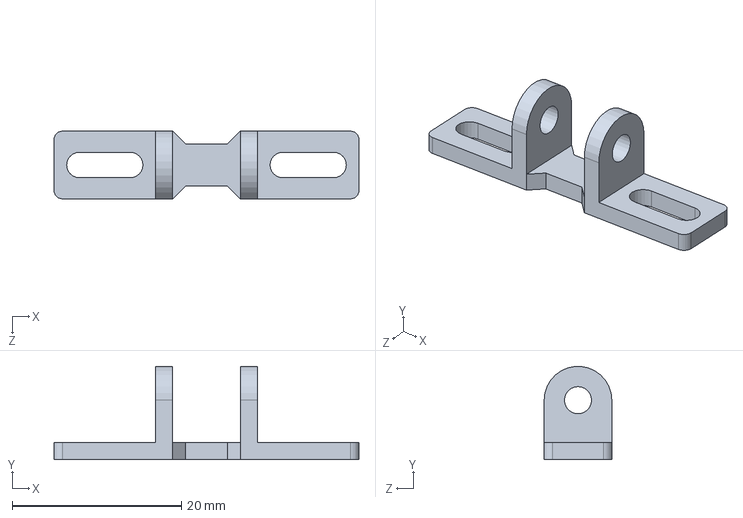
[picture p155: CAD file, 2025-02-19]
src_参考/smart-car-main1/model/智能视觉车四分类/逐飞摄像头支架连接件.SLDPRT
36.0 x 11.0 x 8.00 mm
