infernotracter/NXP_2025/src_主要/NXP-master/鼠鼠车机械结构/桨叶/三寸桨保护罩.STL

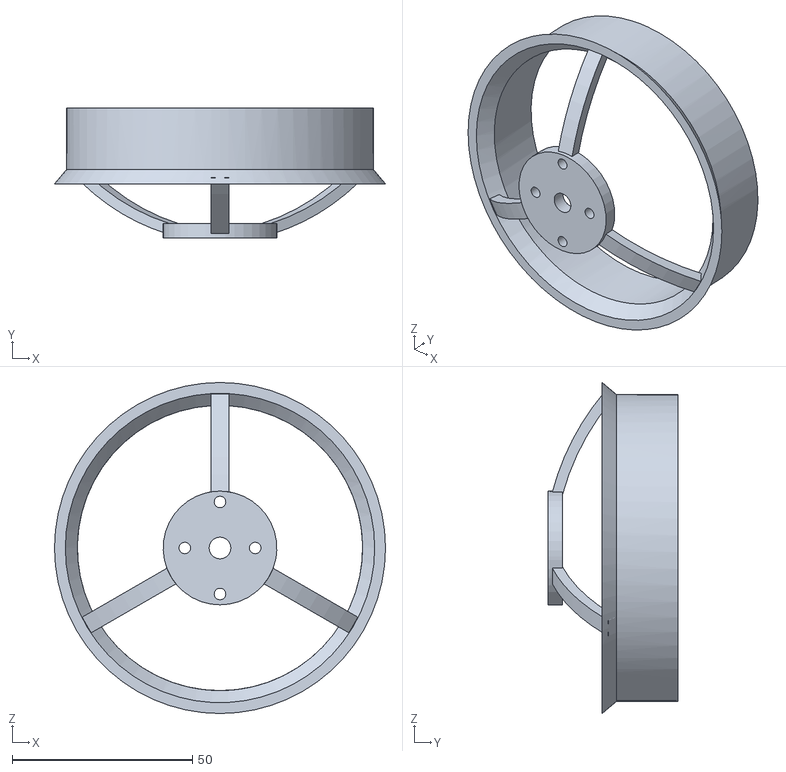
[picture p156: CAD file, 2025-02-13]
src_主要/NXP-master/鼠鼠车机械结构/桨叶/三寸桨保护罩.STL
91.7 x 36.0 x 91.7
