infernotracter/NXP_2025/src_主要/NXP-master/鼠鼠车机械结构/轮胎/车轮.SLDPRT

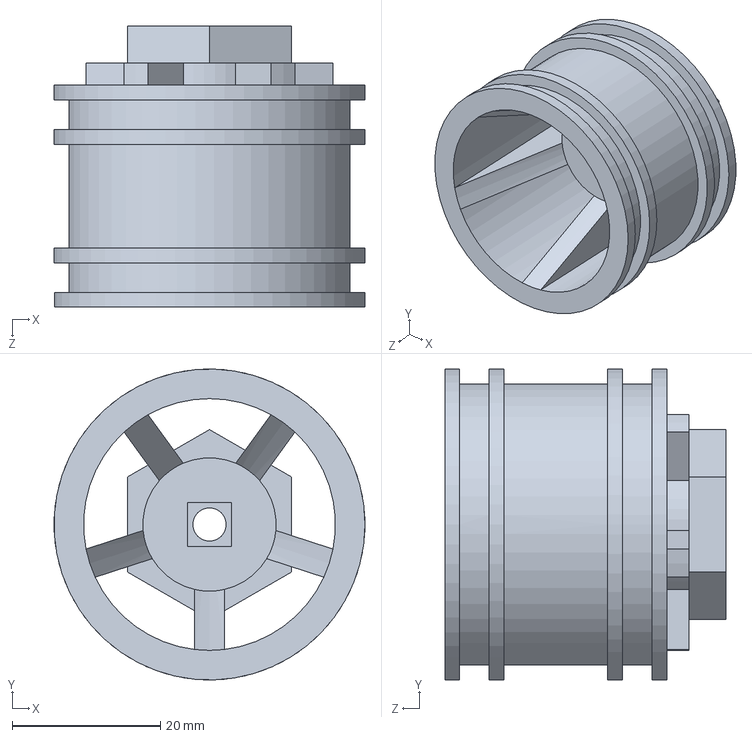
[picture p157: CAD file, 2025-02-13]
src_主要/NXP-master/鼠鼠车机械结构/轮胎/车轮.SLDPRT
42.0 x 42.0 x 38.0 mm
