infernotracter/NXP_2025/src_参考/smart-car-main1/model/智能视觉车四分类/短U支架.SLDPRT

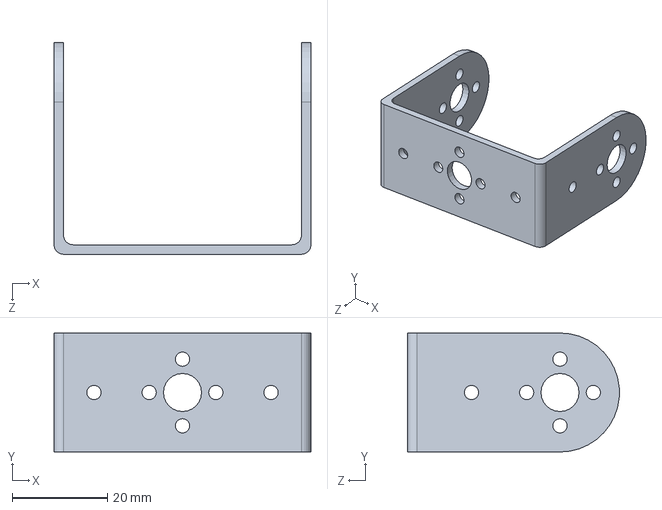
[picture p158: CAD file, 2025-02-19]
src_参考/smart-car-main1/model/智能视觉车四分类/短U支架.SLDPRT
54.0 x 25.0 x 44.5 mm
