infernotracter/NXP_2025/src_参考/smart-car-main1/model/智能视觉车四分类/电路板底板.SLDPRT

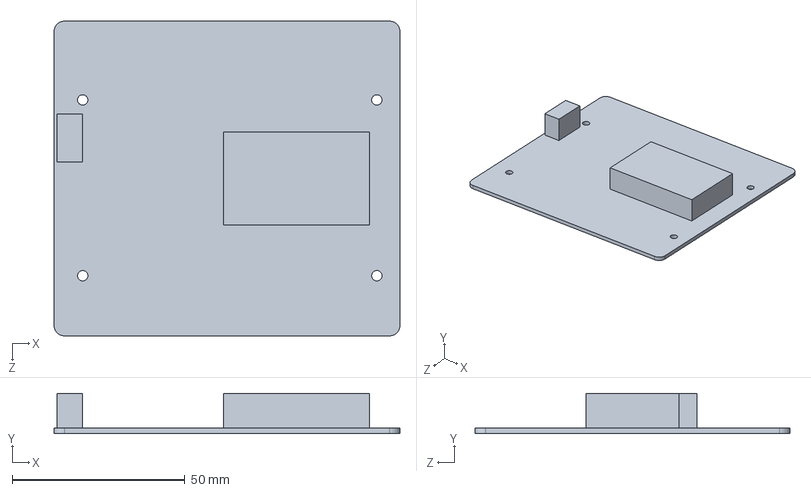
[picture p159: CAD file, 2025-02-19]
src_参考/smart-car-main1/model/智能视觉车四分类/电路板底板.SLDPRT
100.0 x 11.6 x 91.0 mm
