infernotracter/NXP_2025/src_参考/smart-car-main1/model/智能视觉车四分类/仓门.SLDPRT

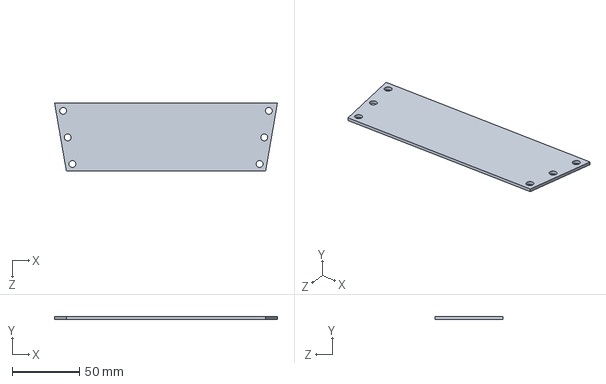
[picture p160: CAD file, 2025-02-19]
src_参考/smart-car-main1/model/智能视觉车四分类/仓门.SLDPRT
165.5 x 2.00 x 50.8 mm
