infernotracter/NXP_2025/src_参考/smart-car-main1/model/智能视觉车四分类/电机替代.SLDPRT

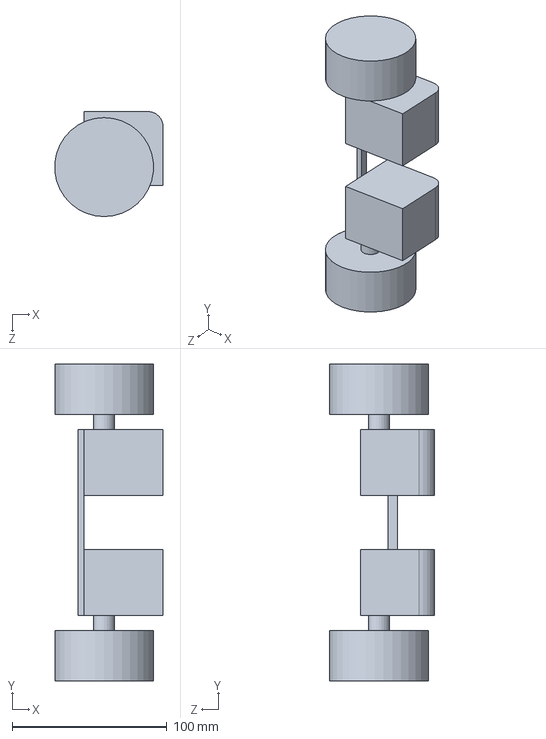
[picture p161: CAD file, 2025-02-19]
src_参考/smart-car-main1/model/智能视觉车四分类/电机替代.SLDPRT
70.1 x 205.0 x 68.0 mm
