infernotracter/NXP_2025/src_参考/smart-car-main1/model/智能视觉车四分类/M车底盘.SLDPRT

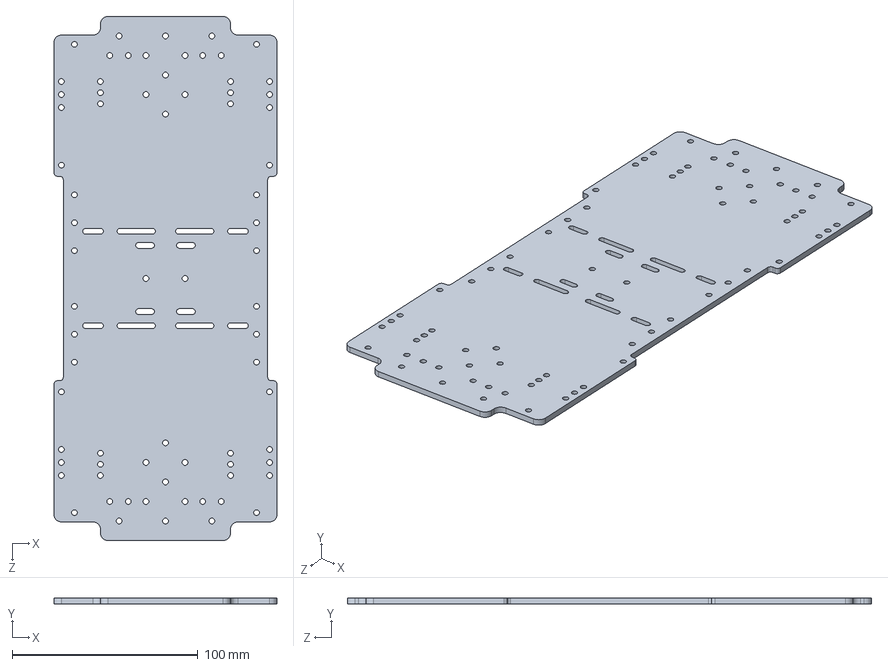
[picture p162: CAD file, 2025-02-19]
src_参考/smart-car-main1/model/智能视觉车四分类/M车底盘.SLDPRT
120.0 x 3.00 x 282.0 mm
