infernotracter/NXP_2025/src_参考/smart-car-main1/model/智能视觉车四分类/电磁铁.SLDPRT

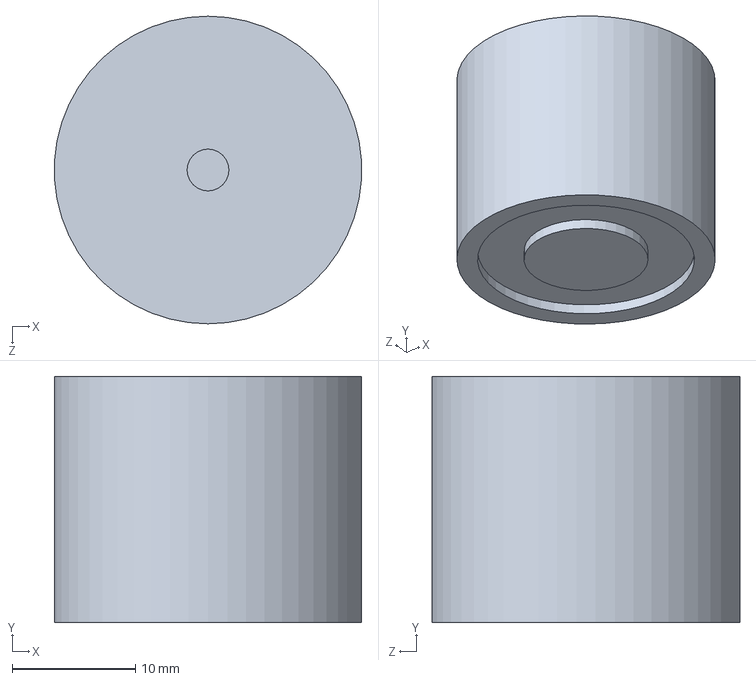
[picture p164: CAD file, 2025-02-19]
src_参考/smart-car-main1/model/智能视觉车四分类/电磁铁.SLDPRT
25.0 x 20.0 x 25.0 mm
