infernotracter/NXP_2025/src_参考/smart-car-main1/model/智能视觉车四分类/舵盘.SLDPRT

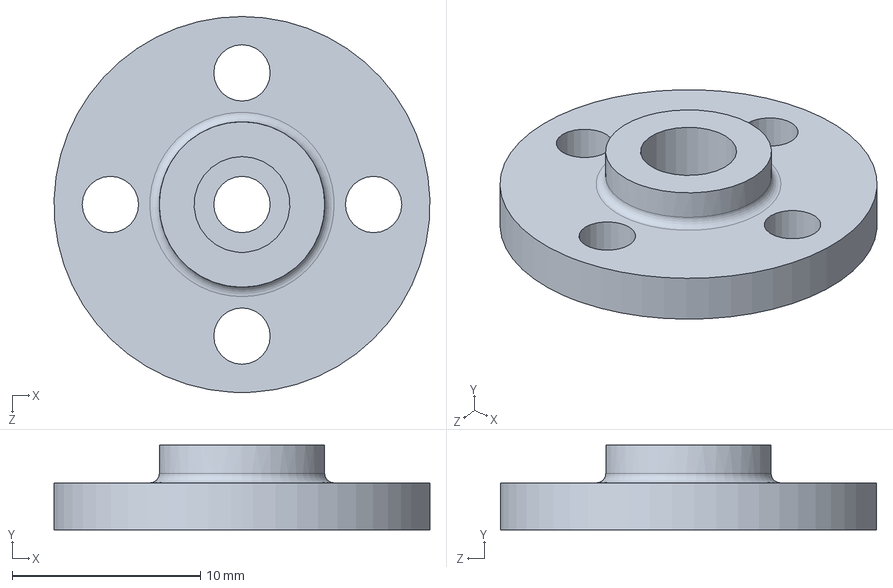
[picture p165: CAD file, 2025-02-19]
src_参考/smart-car-main1/model/智能视觉车四分类/舵盘.SLDPRT
20.0 x 4.50 x 20.0 mm
