infernotracter/NXP_2025/src_参考/smart-car-main1/model/智能视觉车四分类/pvc三通.SLDPRT

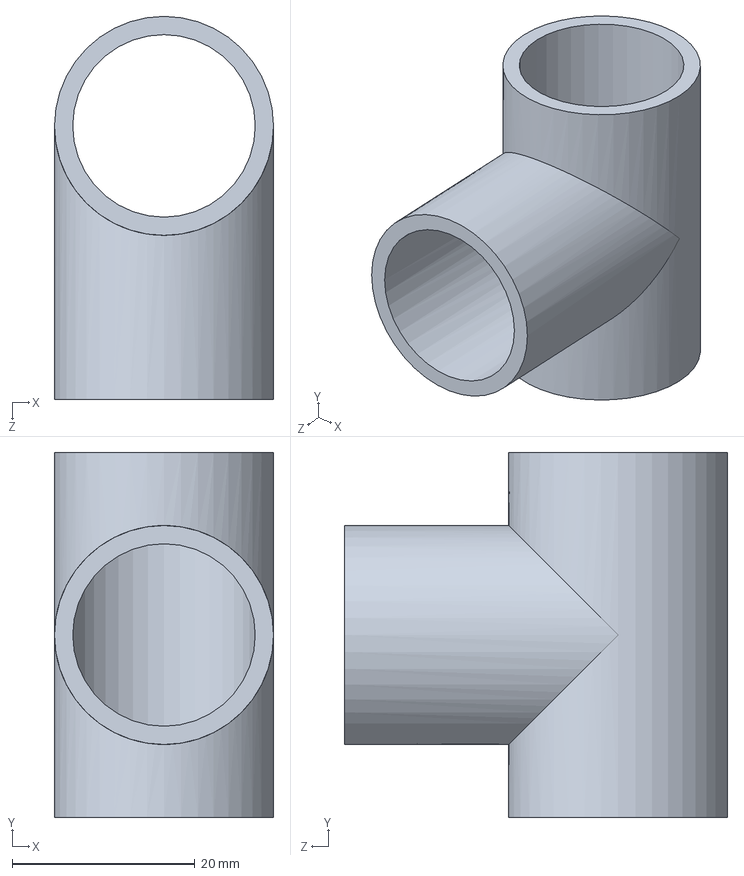
[picture p166: CAD file, 2025-02-19]
src_参考/smart-car-main1/model/智能视觉车四分类/pvc三通.SLDPRT
24.0 x 40.0 x 42.0 mm
