infernotracter/NXP_2025/src_参考/smart-car-main1/model/智能视觉车四分类/储物仓支架.SLDPRT

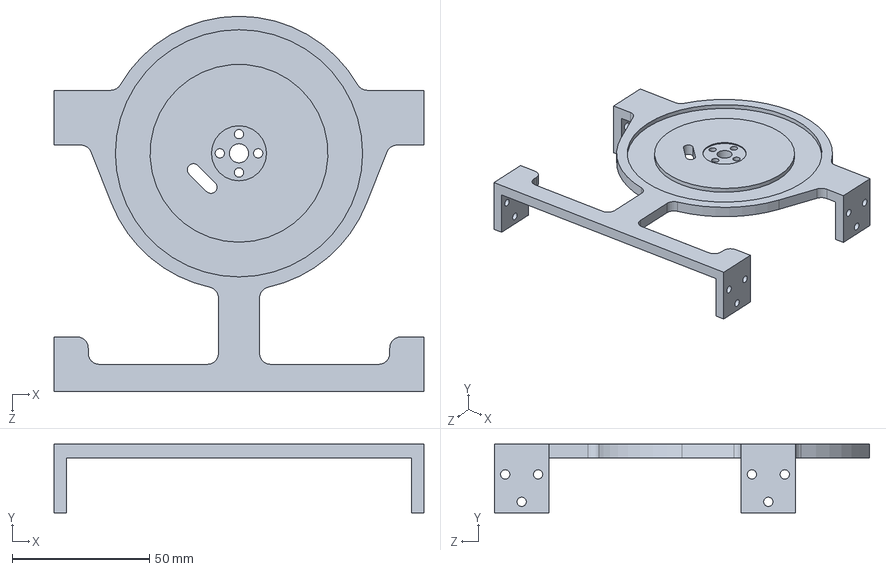
[picture p167: CAD file, 2025-02-19]
src_参考/smart-car-main1/model/智能视觉车四分类/储物仓支架.SLDPRT
135.0 x 25.0 x 137.0 mm
