infernotracter/NXP_2025/src_参考/smart-car-main1/model/智能视觉车四分类/储物仓.SLDPRT

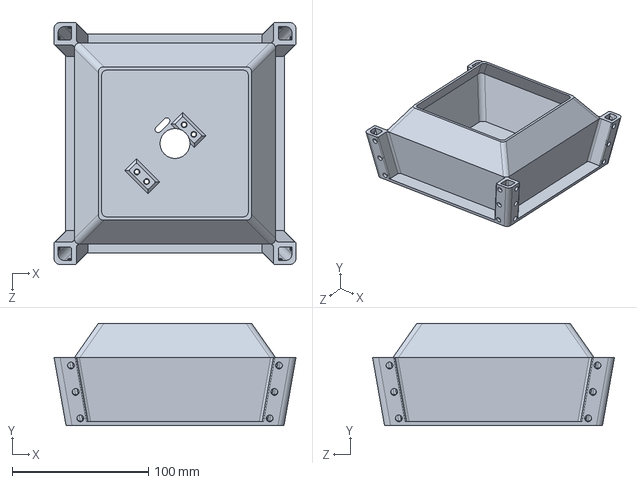
[picture p168: CAD file, 2025-02-19]
src_参考/smart-car-main1/model/智能视觉车四分类/储物仓.SLDPRT
177.6 x 75.0 x 177.6 mm
