infernotracter/NXP_2025/src_参考/smart-car-main1/model/智能视觉车四分类/万能支架.SLDPRT

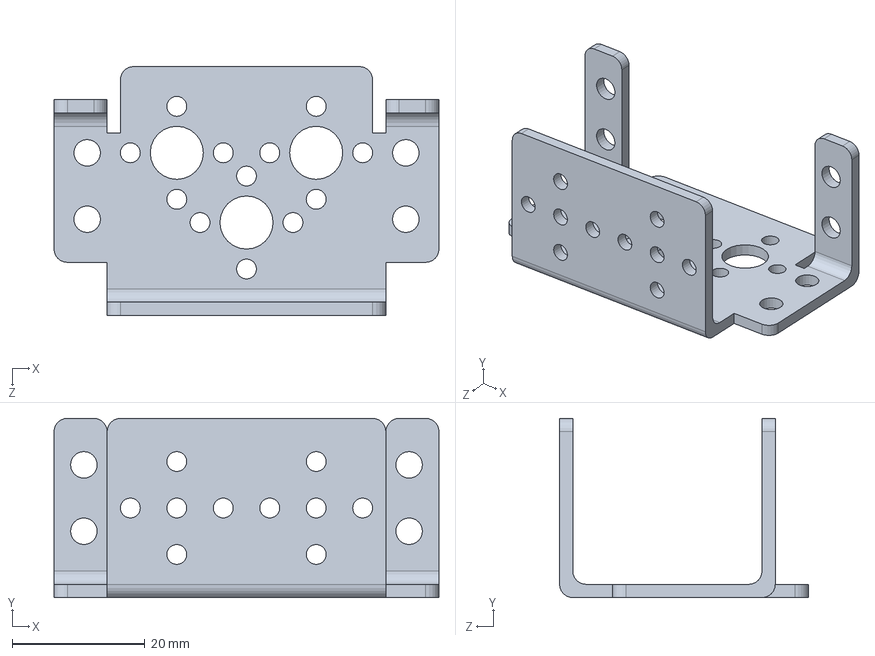
[picture p169: CAD file, 2025-02-19]
src_参考/smart-car-main1/model/智能视觉车四分类/万能支架.SLDPRT
58.0 x 27.0 x 37.5 mm
