infernotracter/NXP_2025/src_参考/smart-car-main1/model/智能视觉车四分类/长U支架.SLDPRT

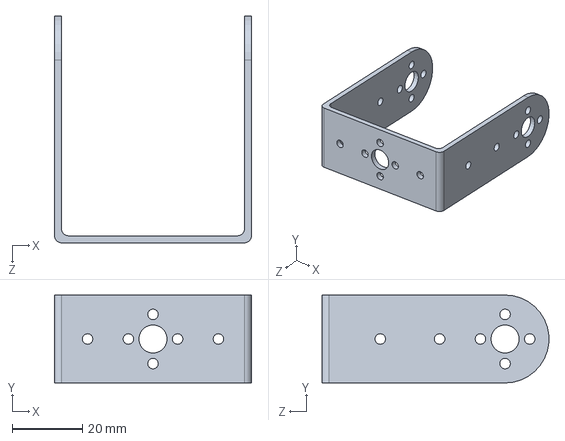
[picture p171: CAD file, 2025-02-19]
src_参考/smart-car-main1/model/智能视觉车四分类/长U支架.SLDPRT
56.0 x 25.0 x 64.4 mm
