infernotracter/NXP_2025/src_参考/smart-car-main1/model/智能视觉车四分类/杯式轴承.SLDPRT

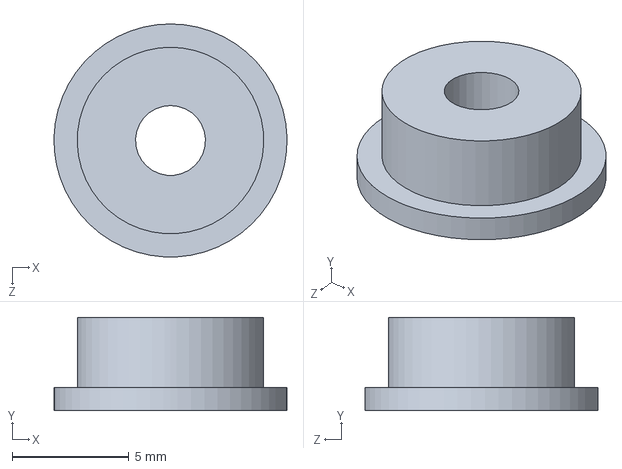
[picture p172: CAD file, 2025-02-19]
src_参考/smart-car-main1/model/智能视觉车四分类/杯式轴承.SLDPRT
10.00 x 4.00 x 10.0 mm
