infernotracter/NXP_2025/src_参考/smart-car-main1/model/智能视觉车四分类/舵机1.SLDPRT

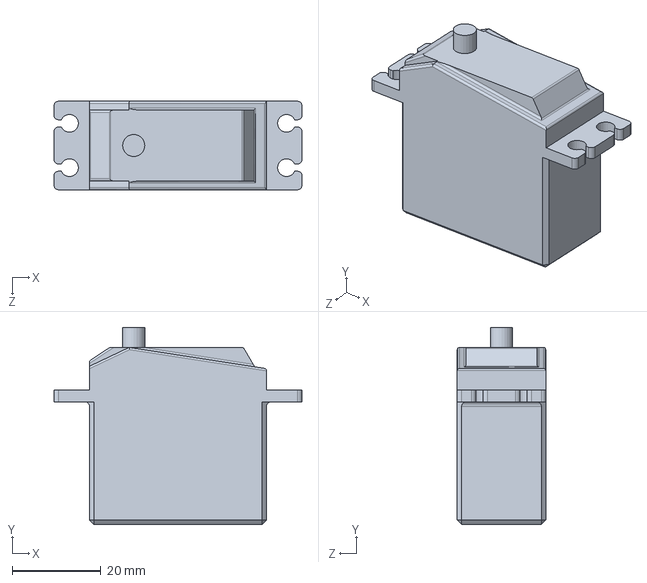
[picture p173: CAD file, 2025-02-19]
src_参考/smart-car-main1/model/智能视觉车四分类/舵机1.SLDPRT
56.0 x 44.5 x 20.0 mm
