infernotracter/NXP_2025/src_参考/smart-car-main1/model/智能视觉车四分类/推力轴承.SLDPRT

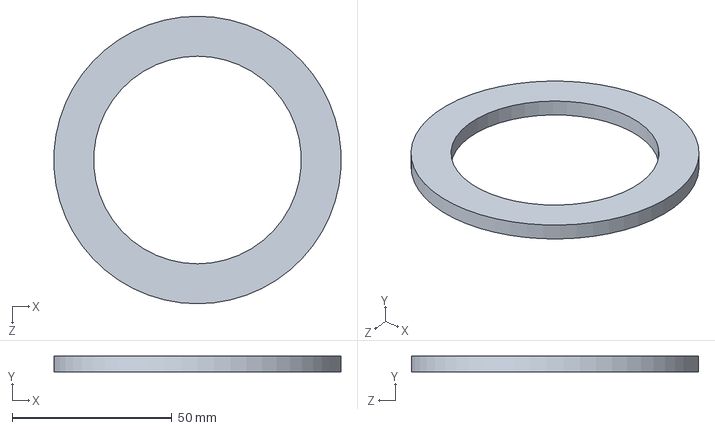
[picture p174: CAD file, 2025-02-19]
src_参考/smart-car-main1/model/智能视觉车四分类/推力轴承.SLDPRT
89.8 x 5.00 x 90.0 mm
