infernotracter/NXP_2025/src_参考/smart-car-main1/model/智能视觉车四分类/摄像头支架1pvc.SLDPRT

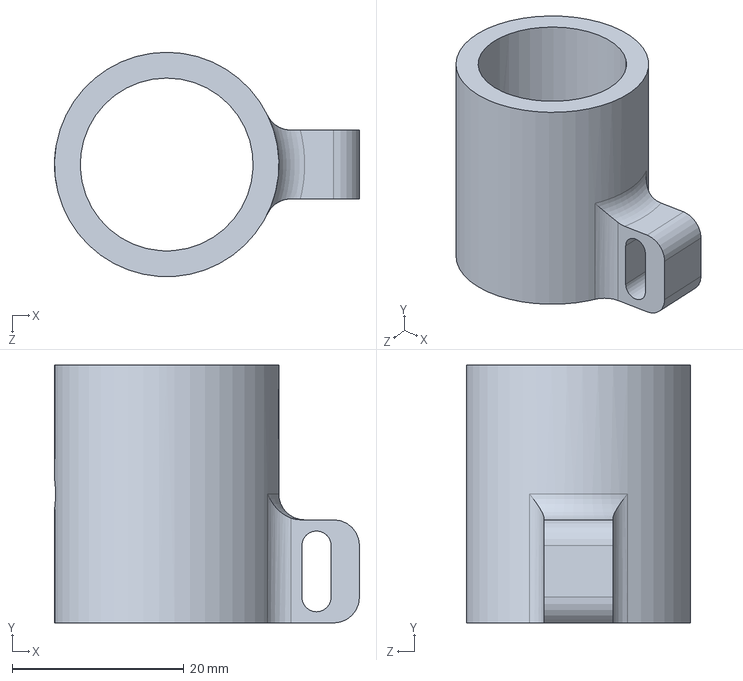
[picture p175: CAD file, 2025-02-19]
src_参考/smart-car-main1/model/智能视觉车四分类/摄像头支架1pvc.SLDPRT
35.5 x 30.0 x 26.1 mm
