infernotracter/NXP_2025/src_参考/smart-car-main1/model/智能视觉车四分类/摄像头支架底pvc.SLDPRT

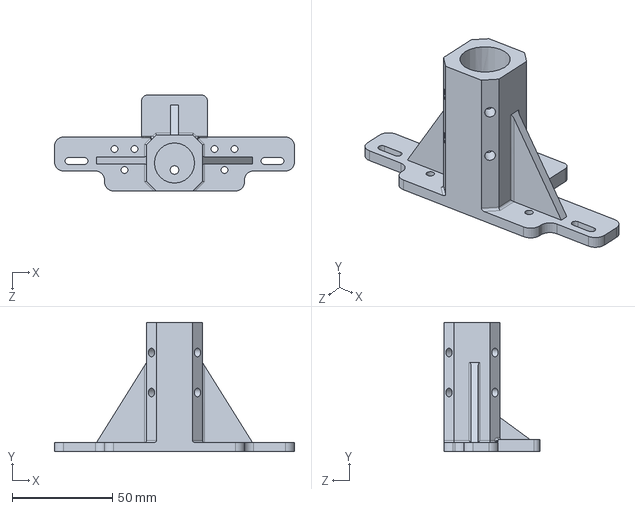
[picture p176: CAD file, 2025-02-19]
src_参考/smart-car-main1/model/智能视觉车四分类/摄像头支架底pvc.SLDPRT
120.0 x 64.5 x 48.0 mm
