infernotracter/NXP_2025/src_参考/smart-car-main1/model/智能视觉车四分类/摄像头支架2pvc.SLDPRT

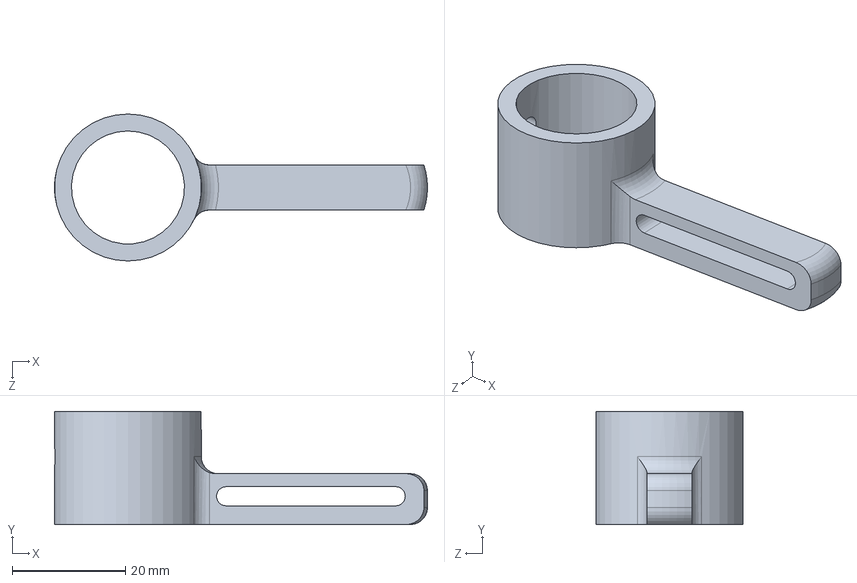
[picture p177: CAD file, 2025-02-19]
src_参考/smart-car-main1/model/智能视觉车四分类/摄像头支架2pvc.SLDPRT
66.0 x 20.0 x 26.0 mm
