infernotracter/NXP_2025/src_参考/smart-car-main1/model/智能视觉车四分类/右侧支架.SLDPRT

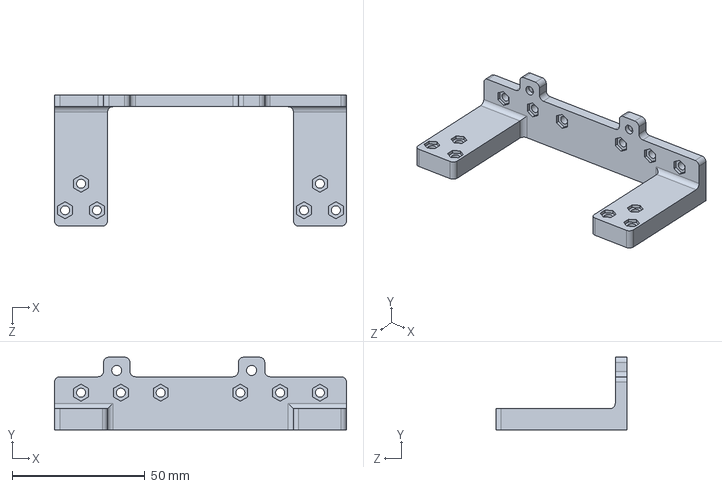
[picture p178: CAD file, 2025-02-19]
src_参考/smart-car-main1/model/智能视觉车四分类/右侧支架.SLDPRT
110.0 x 27.4 x 49.5 mm
