infernotracter/NXP_2025/src_参考/smart-car-main1/model/智能视觉车四分类/前机械臂支架.SLDPRT

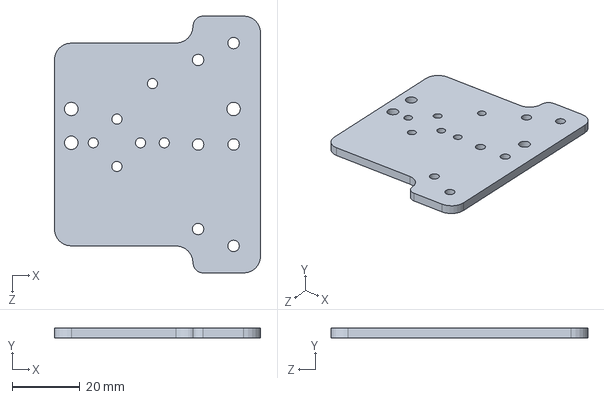
[picture p179: CAD file, 2025-02-19]
src_参考/smart-car-main1/model/智能视觉车四分类/前机械臂支架.SLDPRT
61.0 x 3.00 x 76.0 mm
