infernotracter/NXP_2025/src_参考/smart-car-main1/model/智能视觉车四分类/卡片.SLDPRT

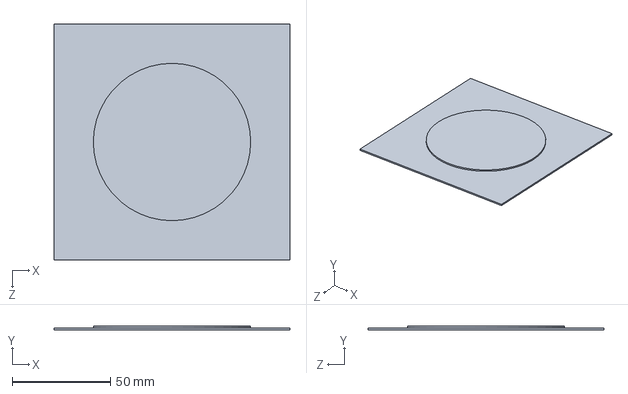
[picture p180: CAD file, 2025-02-19]
src_参考/smart-car-main1/model/智能视觉车四分类/卡片.SLDPRT
120.0 x 2.00 x 120.0 mm
