infernotracter/NXP_2025/src_参考/smart-car-main1/model/智能视觉车四分类/电池.SLDPRT

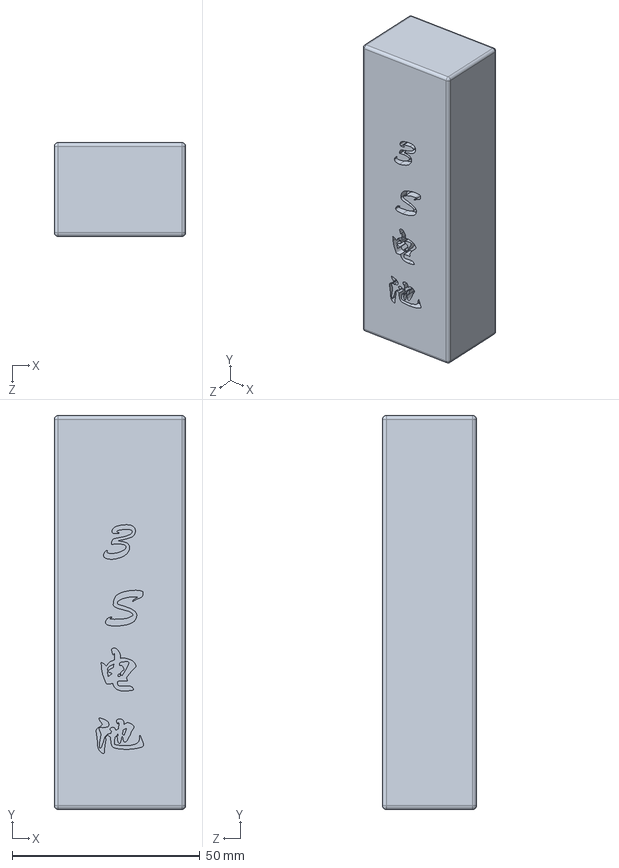
[picture p181: CAD file, 2025-02-19]
src_参考/smart-car-main1/model/智能视觉车四分类/电池.SLDPRT
35.0 x 105.0 x 25.0 mm
