infernotracter/NXP_2025/src_参考/smart-car-main1/model/智能视觉车四分类/电池扣.SLDPRT

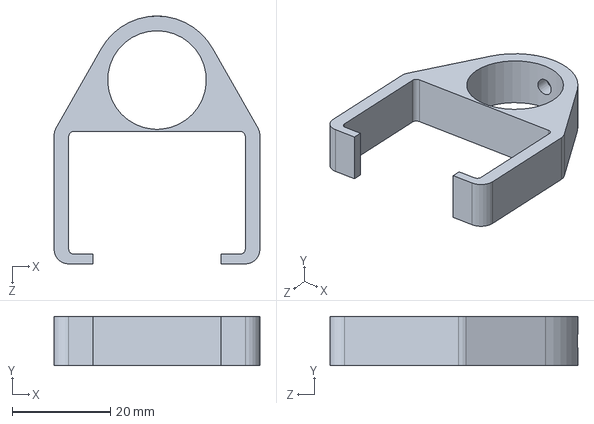
[picture p182: CAD file, 2025-02-19]
src_参考/smart-car-main1/model/智能视觉车四分类/电池扣.SLDPRT
42.0 x 10.0 x 50.6 mm
