infernotracter/NXP_2025/(list of files, cad)

Other CAD files:
src_参考/国之重器/Objects/main.obj
src_参考/国之重器/Objects/LQ_dianci.obj
src_参考/国之重器/Objects/LQ_MotorServo.obj
src_主要/NXP-master/鼠鼠车机械结构/侧壁/侧壁2.SLDPRT
src_参考/国之重器/Objects/LQ_I2C.obj
src_主要/NXP-master/鼠鼠车机械结构/桨叶/三英寸桨保护罩.SLDPRT
src_参考/国之重器/Objects/LQ_PID.obj
src_参考/国之重器/Objects/LQ_GPIO_EXIT.obj
src_参考/国之重器/Objects/LQ_SOFTI2C.obj
src_参考/国之重器/Objects/LQ_SPI.obj
src_参考/国之重器/Objects/LQ_ADC.obj
src_参考/国之重器/Objects/LQ_OLED096.obj
src_参考/国之重器/Objects/LQ_Encoder.obj
src_参考/国之重器/Objects/LQ_GPIO_LED.obj
src_参考/国之重器/Objects/LQ_TIMER.obj
src_参考/国之重器/Objects/LQ_UART.obj
src_参考/国之重器/Objects/LQ_ICM20689.obj
src_参考/国之重器/Objects/ANO_DT.obj
src_参考/国之重器/Objects/LQ_GPIO_KEY.obj
src_主要/NXP-master/鼠鼠车机械结构/侧壁/侧壁.STL
src_主要/NXP-master/鼠鼠车机械结构/侧壁/侧壁2.STL
