infernotracter/NXP_2025/history_历史代码/7.5.12.19_坡道完美检测，右圆环没调/IMG_1728.JPG

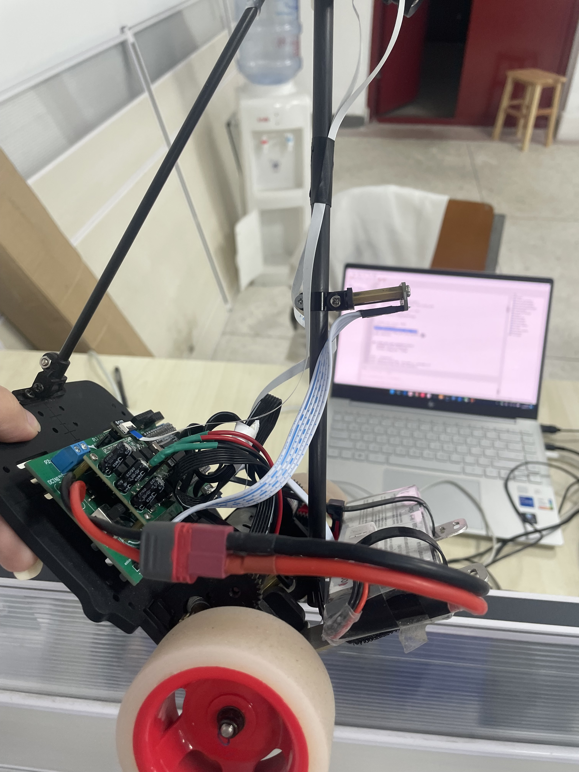
history_历史代码/7.5.12.19_坡道完美检测，右圆环没调/IMG_1728.JPG
