infernotracter/NXP_2025/src_主要/RT1021 MicroPython核心板/【原理图】核心板原理图/【原理图】核心板原理图/MIMXRT1021xAFxx核心板V1.1原理图.pdf

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
MIMXRT1021xAFxx_CoreBoard | 猫肆管

V1.1.0.0
2024/2/22 | 18:40:51
Title: | Author:

Date:

Revision:
Size: A4 | Time: | Sheet: | of:

### Subtitle: Revision

V1.0 | 初始版本，测试未生产
版本号 | 修订日期 | 修订记录

2018-11-27

在此文件中，仅以版本号前两位(发行版)，划分版本之间的区别。

版权所有，保留一切权利。
本公司致力于产品的不断改善和功能升级，内容如有改动，恕不另行通知。
V1.1.0.0 | 2023-11-27 | 重绘，更改板型 SEEKFREE

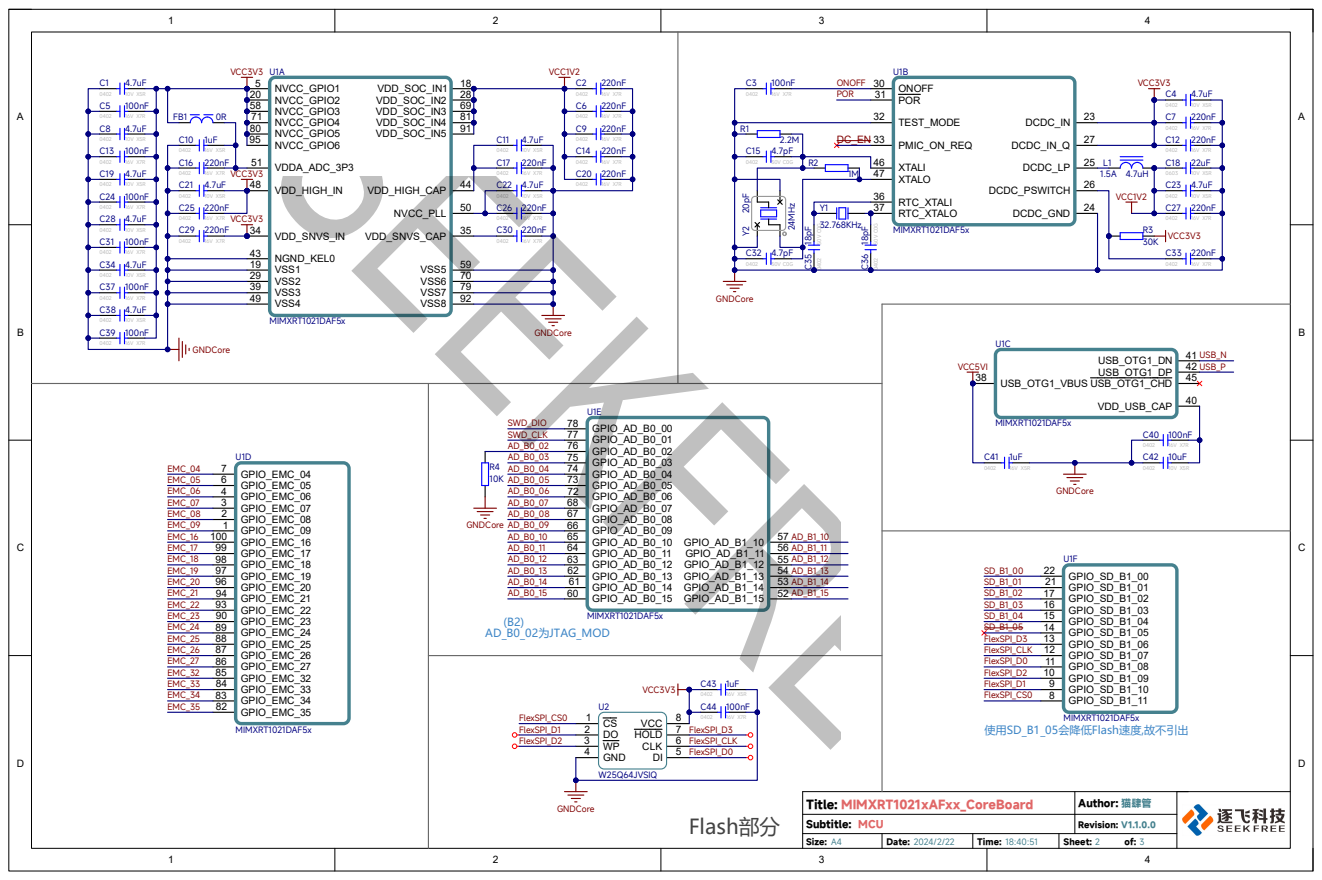
[picture p186: page 2]

USB接口 | 3.3V稳压

B27

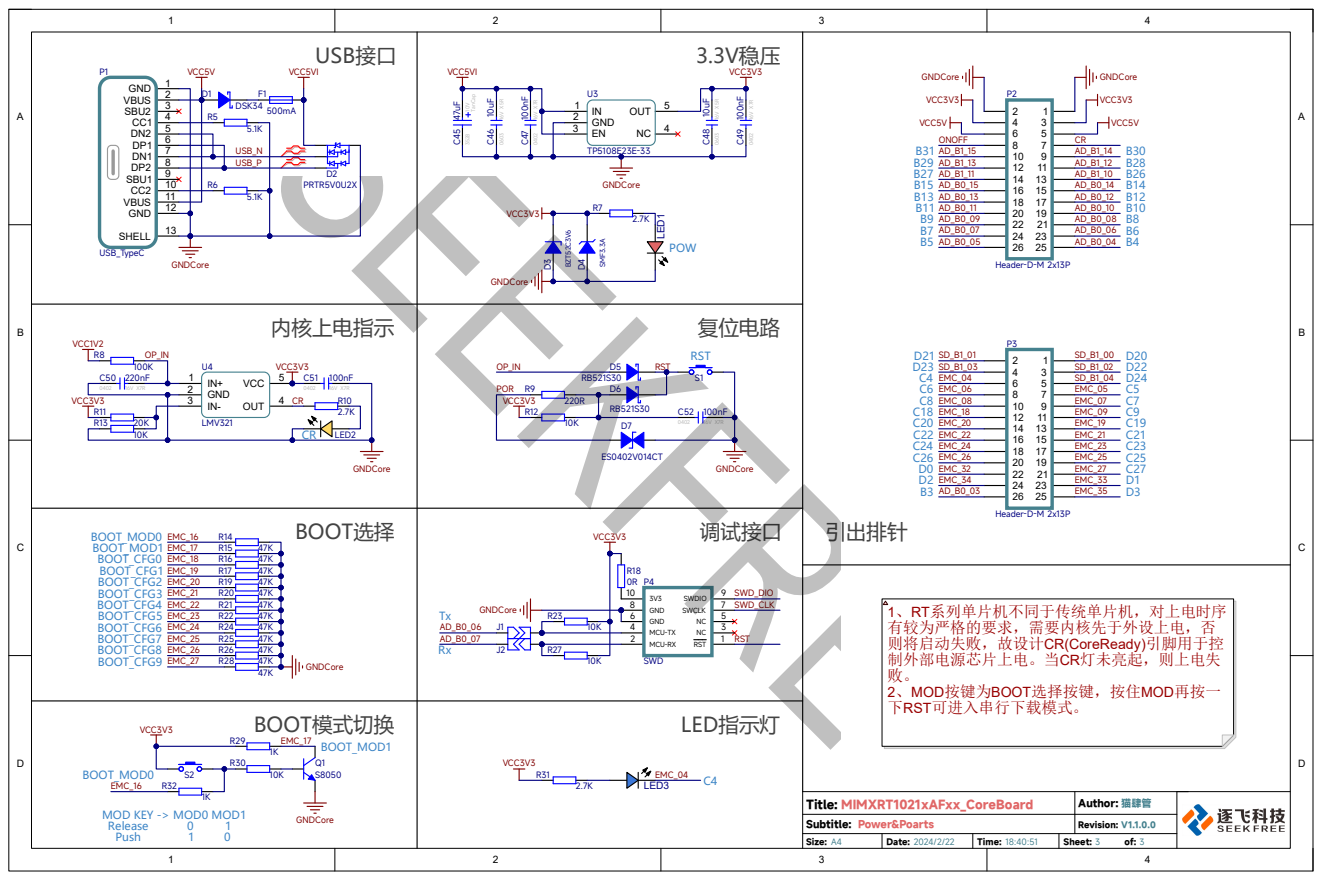
[picture p187: page 3]

GNDCore ³⁵²⁸ ¹⁰V TanCap 4⁷uF C⁴⁵

1、RT系列单片机不同于传统单片机，对上电时序
有较为严格的要求，需要内核先于外设上电，否
则将启动失败，故设计CR(CoreReady)引脚用于控
制外部电源芯片上电。当CR灯未亮起，则上电失
2、MOD按键为BOOT选择按键，按住MOD再按一
下RST可进入串行下载模式。
