infernotracter/NXP_2025/(list of files, drawings)

Other design files:
src_主要/RT1021 MicroPython核心板/【封装】核心板整体原理图+PCB封装/【封装】核心板整体原理图+PCB封装/MIMXRT1021xAFxx核心板V1.1原理库.SchLib
src_主要/RT1021 MicroPython核心板/【封装】核心板整体原理图+PCB封装/【封装】核心板整体原理图+PCB封装/MIMXRT1021xAFxx核心板V1.1封装库.PcbLib
src_参考/RT1021_Library-master#3/【封装】核心板整体原理图封装+PCB封装/单片机原理库.SchLib
src_参考/RT1021_Library-master#3/【封装】核心板整体原理图封装+PCB封装/单片机封装库.PcbLib
src_参考/RT1021_Library-master#3/【封装】核心板整体原理图封装+PCB封装/核心板原理库.SchLib
src_参考/RT1021_Library-master#3/【封装】核心板整体原理图封装+PCB封装/核心板封装库.PcbLib
