infernotracter/NXP_2025/src_主要/Seekfree_TC377_Opensource_Library/code/motor.c

/*
 * motor.c
 *
 *  Created on: 2024年8月28日
 *      Author: FZY_YQH
 */

#include "zf_common_headfile.h"

int32 up_flag;
int32 duty_l;            // 左电机pwm
int32 duty_r;            // 右电机pwm
int32 duty_dir;
int32 expect_speed;
struct pid angle;        // 直立角度环
struct pid gyro;         // 直立角速度环
struct pid speed;        // 速度环
struct pid dir_camera;
struct pid dir_gyro;

//-------------------------------------------------------------------------------------------------------------------
//  函数简介      电机初始化
//  参数说明      void
//  返回参数      void
//  使用示例      motor_init();
//  备注信息
//-------------------------------------------------------------------------------------------------------------------
void motor_init(void)
{
    gpio_init(DIR_L, GPO, GPIO_HIGH, GPO_PUSH_PULL);                           // GPIO 初始化为输出 默认上拉输出高
    pwm_init(PWM_L, 17000, 0);                                                 // PWM 通道初始化频率 17KHz 占空比初始为 0

    gpio_init(DIR_R, GPO, GPIO_HIGH, GPO_PUSH_PULL);                           // GPIO 初始化为输出 默认上拉输出高
    pwm_init(PWM_R, 17000, 0);                                                 // PWM 通道初始化频率 17KHz 占空比初始为 0
}

//-------------------------------------------------------------------------------------------------------------------
//  函数简介      电机驱动
//  参数说明      void
//  返回参数      void
//  使用示例      motor_drive();
//  备注信息
//-------------------------------------------------------------------------------------------------------------------
void motor_drive(void)
{
    if (duty_l >= 0)
    {
        gpio_set_level(DIR_L, GPIO_HIGH);                                  // DIR输出高电平
        pwm_set_duty(PWM_L, duty_l);                                       // 计算占空比
    }
    else
    {
        gpio_set_level(DIR_L, GPIO_LOW);                                   // DIR输出低电平
        pwm_set_duty(PWM_L, -duty_l);                                      // 计算占空比
    }

    if (duty_r >= 0)
    {
        gpio_set_level(DIR_R, GPIO_HIGH);                                  // DIR输出高电平
        pwm_set_duty(PWM_R, duty_r);                                       // 计算占空比
    }
    else
    {
        gpio_set_level(DIR_R, GPIO_LOW);                                   // DIR输出低电平
        pwm_set_duty(PWM_R, -duty_r);                                      // 计算占空比
    }
}

//-------------------------------------------------------------------------------------------------------------------
//  函数简介      直立角度环
//  参数说明      expect    速度环的输出值作为期望角度
//  参数说明      input     实际角度值
//  返回参数      angle.out 直立角度环的输出值作为期望角速度
//  使用示例
//  备注信息
//-------------------------------------------------------------------------------------------------------------------
int32 angle_ring(int32 expect, int32 input)
{
    angle.target = expect;
    angle.actual = input;

    angle.error = angle.target - angle.actual;
    angle.out = (int32)(angle.kp * angle.error + angle.kd * (angle.error - angle.last_error));

    angle.last_error = angle.error;

//  限制输出

    return angle.out;
}

//-------------------------------------------------------------------------------------------------------------------
//  函数简介      直立角速度环
//  参数说明      expect    角度环的输出值作为期望角速度
//  参数说明      input     实际角速度
//  返回参数      gyro.out  直立角速度环的输出值直接给到电机
//  使用示例
//  备注信息
//-------------------------------------------------------------------------------------------------------------------
int32 gyro_ring(int32 expect, int32 input)
{
    gyro.target = expect;
    gyro.actual = input;

    gyro.error = gyro.actual - gyro.target;
    gyro.increment += gyro.error * gyro.ki;

//  对积分项限幅
    gyro.increment = my_limit(gyro.increment, -3000, 3000);

    gyro.out = (int32)(gyro.kp * gyro.error + gyro.increment);

//  限制输出

    gyro.last_error = gyro.error;

    return gyro.out;
}

//-------------------------------------------------------------------------------------------------------------------
//  函数简介      速度环
//  参数说明      expect    期望速度
//  参数说明      input     实际速度(左右编码器平均值)
//  返回参数      speed.out 速度环的输出值作为角度环的输入
//  使用示例
//  备注信息
//-------------------------------------------------------------------------------------------------------------------
int32 speed_ring(int32 expect, int32 input)
{
    speed.target = expect;
    speed.actual = input;

    speed.error = speed.actual - speed.target;
    speed.increment += speed.error * speed.ki;

    speed.increment = my_limit(speed.increment, -2000, 2000);

    speed.out = (int32)(speed.kp * speed.error + speed.increment);

    speed.last_error = speed.error;

    return speed.out;
}

//-------------------------------------------------------------------------------------------------------------------
//  函数简介
//  参数说明
//  参数说明
//  返回参数
//  使用示例
//  备注信息
//-------------------------------------------------------------------------------------------------------------------
int32 dir_in_ring(int32 except, int32 input)
{
    dir_gyro.target = except;
    dir_gyro.actual = input;

    dir_gyro.error = dir_gyro.target - dir_gyro.actual;
    dir_gyro.increment += dir_gyro.error * dir_gyro.ki;

    dir_gyro.increment = my_limit(dir_gyro.increment, -1500, 1500);

    dir_gyro.out = (int32)(dir_gyro.kp * dir_gyro.error + dir_gyro.increment);

    dir_gyro.last_error = dir_gyro.error;

    return dir_gyro.out;
}

//-------------------------------------------------------------------------------------------------------------------
//  函数简介
//  参数说明
//  参数说明
//  返回参数
//  使用示例
//  备注信息
//-------------------------------------------------------------------------------------------------------------------
int32 dir_out_ring(int32 except, int32 input)
{
    dir_camera.target = except;
    dir_camera.actual = input;

    dir_camera.error = dir_camera.actual - dir_camera.target;
    dir_camera.out = (int32)(dir_camera.kp * dir_camera.error + dir_camera.kd * (dir_camera.error - dir_camera.last_error));

    dir_camera.last_error = dir_camera.error;

    return dir_camera.out;
}

//-------------------------------------------------------------------------------------------------------------------
//  函数简介
//  参数说明
//  参数说明
//  返回参数
//  使用示例
//  备注信息
//-------------------------------------------------------------------------------------------------------------------
void dir_control(float turn_error, float gyro)
{
    static int32 flag_dir = 0;

    static int32 duty_camera = 0;
    static int32 duty_gyro   = 0;

    flag_dir++;

    if (flag_dir >= 2)
    {
        turn_error = get_turn_error();
        duty_camera = dir_out_ring(0, turn_error);
        flag_dir = 0;
    }

    duty_gyro = dir_in_ring(duty_camera, gyro);
    duty_dir  = duty_gyro;
}

//-------------------------------------------------------------------------------------------------------------------
//  函数简介      电机控制
//  参数说明      angle     实际角度
//  参数说明      gyro      角速度
//  返回参数      void
//  使用示例
//  备注信息
//-------------------------------------------------------------------------------------------------------------------
void motor_control(float angle, float gyro)
{
    static int32 flag_speed = 0;
    static int32 flag_angle = 0;

    static int32 duty_speed = 0;
    static int32 duty_angle = 0;
    static int32 duty_gyro  = 0;

    flag_speed++;
    flag_angle++;

    encoder_data_get();

    if (flag_speed == 50)
    {
        duty_speed = speed_ring(expect_speed, encoder_data_temp);
        flag_speed = 0;
        test = !test;
    }

    if (flag_angle == 5)
    {
        duty_angle = angle_ring(duty_speed + BALANCE, (int32)angle);
        flag_angle = 0;
    }

    duty_gyro = gyro_ring(duty_angle, (int32)gyro);

    if (duty_gyro >= 0)
    {
        duty_gyro += 100;
    }
    else
    {
        duty_gyro -= 100;
    }

    duty_l = duty_gyro - duty_dir;
    duty_r = duty_gyro + duty_dir;

    duty_l = my_limit(duty_l, -3000, 3000);
    duty_r = my_limit(duty_r, -3000, 3000);

    motor_drive();
}
