infernotracter/NXP_2025/history_历史代码/main_3_5 #pid.py

# 基础库、NXP库、第三方库
from machine import *
from display import *
from smartcar import *
from seekfree import *
from math import *
import gc
import time
import math
import os
import io

# 单位换算用
ACC_SPL = 4096.0
GYRO_SPL = 16.4

# 屏幕实例化
cs = Pin('C5', Pin.OUT, pull=Pin.PULL_UP_47K, value=1)
cs.high()
cs.low()
rst = Pin('B9', Pin.OUT, pull=Pin.PULL_UP_47K, value=1)
dc = Pin('B8', Pin.OUT, pull=Pin.PULL_UP_47K, value=1)
blk = Pin('C4', Pin.OUT, pull=Pin.PULL_UP_47K, value=1)
drv = LCD_Drv(SPI_INDEX=1, BAUDRATE=60000000, DC_PIN=dc,
              RST_PIN=rst, LCD_TYPE=LCD_Drv.LCD200_TYPE)
lcd = LCD(drv)
lcd.color(0xFFFF, 0x0000)
lcd.mode(2)
lcd.clear(0x0000)

# 发车初始化
Go = Pin('C21', Pin.IN, pull=Pin.PULL_UP_47K, value=0)

# 实例化 MOTOR_CONTROLLER 电机驱动模块
motor_l = MOTOR_CONTROLLER(
    MOTOR_CONTROLLER.PWM_C25_DIR_C27, 13000, duty=0, invert=True)
motor_r = MOTOR_CONTROLLER(
    MOTOR_CONTROLLER.PWM_C24_DIR_C26, 13000, duty=0, invert=True)

# 实例化 encoder 模块
encoder_l = encoder("D0", "D1", True)
encoder_r = encoder("D2", "D3")

# # 实例化 bldc 模块
# bldc1 = BLDC_CONTROLLER(BLDC_CONTROLLER.PWM_B26, freq = 300, highlevel_us = 1100)
# bldc2 = BLDC_CONTROLLER(BLDC_CONTROLLER.PWM_B27, freq = 300, highlevel_us = 1100)
# high_level_us = 1300
# dir = 1

# 实例化 lcd 模块

# 实例化 IMU963RA 模块
imu = IMU963RA()

# 核心板上的LED
led1 = Pin('C4', Pin.OUT, pull=Pin.PULL_UP_47K, value=True)

# 拨码开关2
end_switch = Pin('C19', Pin.IN, pull=Pin.PULL_UP_47K, value=True)
# 拨码开关4
switch_3 = Pin('B14', Pin.IN, pull=Pin.PULL_UP_47K, value=True)
# 拨码开关3
switch_4 = Pin('B15', Pin.IN, pull=Pin.PULL_UP_47K, value=True)

# 调用 TSL1401 模块获取 CCD 实例
ccd = TSL1401(3)

# 实例化 KEY_HANDLER 模块
key = KEY_HANDLER(10)
# 零号ticker记数，用于三个pid
pit_cont0 = 0

# 定义一个回调函数
ticker_flag_2ms = False
ticker_flag_1ms = False
ticker_flag_4ms = False
ticker_flag_5ms = False
ticker_flag_8ms = False
ticker_flag_10ms = False
ticker_flag_50ms = False


def time_pit_pid_handler(time):
    global ticker_flag_2ms, ticker_flag_10ms, ticker_flag_50ms, pit_cont0
    pit_cont0 += 1
    if (pit_cont0 == 2):
        ticker_flag_2ms = True
    if (pit_cont0 == 10):
        ticker_flag_10ms = True
    if (pit_cont0 == 50):
        ticker_flag_50ms = True
    if (pit_cont0 > 50):
        pit_cont0 = 1


# 实例化 PIT ticker 模块
pit0 = ticker(0)
pit0.capture_list(ccd, imu, key, encoder_l, encoder_r)
pit0.callback(time_pit_pid_handler)
pit0.start(1)


def time_pit_1ms_handler(time):
    global ticker_flag_1ms
    ticker_flag_1ms = True


pit1 = ticker(1)
pit1.capture_list(imu, key)
pit1.callback(time_pit_1ms_handler)
pit1.start(1)  # 之前为3，现在改为1


def time_pit_5ms_handler(time):
    global ticker_flag_5ms
    ticker_flag_5ms = True


# 实例化 PIT ticker 模块
pit2 = ticker(2)
pit2.capture_list(ccd, key, encoder_l, encoder_r)
pit2.callback(time_pit_5ms_handler)
pit2.start(5)

pit_cont3 = 0


def time_pit_turnpid_handler(time):
    global ticker_flag_4ms, ticker_flag_8ms, pit_cont3
    pit_cont3 += 1
    if (pit_cont3 == 4):
        ticker_flag_4ms = True
    if (pit_cont3 == 8):
        ticker_flag_8ms = True


pit3 = ticker(3)
pit3.capture_list(ccd, imu)
pit3.callback(time_pit_turnpid_handler)
pit3.start(1)

# 初始化变量
ccd_data1 = [0] * 128  # ccd1原始数组
ccd_data2 = [0] * 128  # ccd2原始数组
encl_data = 0  # 左编码器数据
encr_data = 0  # 右数据编码器
# out = 0  # 舵机输出值
aim_speed = 100  # 之后要可以使用KEY手动修改
aim_speed_l = 0  # 左轮期望速度
aim_speed_r = 0  # 右轮期望速度
out_l = 0  # 左轮输出值
out_r = 0  # 右轮输出值
MedAngle = 0
n = 0  # 元素判断用
m = 0
error_k = 1  # 直接传error2后的比例


# 限幅函数
def my_limit(value, min_val, max_val):
    return max(min_val, min(value, max_val))


class PID:
    def __init__(self, kp, ki=0, kd=0,
                 integral_limits=None, output_limits=None,
                 output_adjustment=None):
        self.kp = kp
        self.ki = ki
        self.kd = kd
        self.integral = 0
        self.prev_error = 0
        self.integral_limits = integral_limits
        self.output_limits = output_limits
        self.output_adjustment = output_adjustment

    def calculate(self, target, current):
        error = target - current

        # 积分项处理
        self.integral += error * self.ki
        if self.integral_limits:
            self.integral = my_limit(self.integral, *self.integral_limits)

        # 微分项计算
        derivative = error - self.prev_error

        # PID输出计算
        output = (self.kp * error) + self.integral + (self.kd * derivative)

        # 输出限幅
        if self.output_limits:
            output = my_limit(output, *self.output_limits)

        # 特殊输出调整
        if self.output_adjustment:
            output = self.output_adjustment(output)

        self.prev_error = error
        return output


# 特殊输出调整函数
def gyro_adjustment(output):
    return output + 100 if output >= 0 else output - 100


# PID实例化
speed_pid = PID(kp=10.0, ki=0.6,
                integral_limits=(-2000, 2000),
                output_limits=(-500, 500))

angle_pid = PID(kp=10.0, kd=0.6,
                integral_limits=(-2000, 2000))

gyro_pid = PID(kp=10.0, kd=0.0,
               integral_limits=(-2000, 2000),
               output_adjustment=gyro_adjustment)

dir_in = PID(kp=10.0, ki=0.6,
             integral_limits=(-2000, 2000))

dir_out = PID(kp=10.0, kd=0.6)

# 串级PID相关变量
speed_pid_out = 0
angle_pid_out = 0
gyro_pid_out = 0
dir_in_out = 0
dir_out_out = 0

# 四元数姿态解算相关变量
q0 = 1.0
q1 = q2 = q3 = 0.0
I_ex = I_ey = I_ez = 0.0
imu_kp = 1.5  # 比例增益（调整滤波响应速度）
imu_ki = 0.0005  # 积分增益（调整积分速度）
delta_T = 0.001  # 采样周期（与1ms中断对应）
current_pitch = 0  # 当前俯仰角
current_roll = 0  # 当前横滚角
current_yaw = 0  # 当前偏航角


# 姿态角度计算函数
def quaternion_update(ax, ay, az, gx, gy, gz):
    global q0, q1, q2, q3, I_ex, I_ey, I_ez, current_pitch, current_roll, current_yaw

    # 归一化加速度计数据
    norm = math.sqrt(ax ** 2 + ay ** 2 + az ** 2)
    if norm == 0:
        return
    ax /= norm
    ay /= norm
    az /= norm

    # 计算预测的重力方向
    vx = 2 * (q1 * q3 - q0 * q2)
    vy = 2 * (q0 * q1 + q2 * q3)
    vz = q0 * q0 - q1 * q1 - q2 * q2 + q3 * q3

    # 计算误差（叉积）
    ex = (ay * vz - az * vy)
    ey = (az * vx - ax * vz)
    ez = (ax * vy - ay * vx)

    # 误差积分
    I_ex += ex * imu_ki
    I_ey += ey * imu_ki
    I_ez += ez * imu_ki

    # 调整陀螺仪数据（弧度制）
    gx = math.radians(gx) + imu_kp * ex + I_ex
    gy = math.radians(gy) + imu_kp * ey + I_ey
    gz = math.radians(gz) + imu_kp * ez + I_ez

    # 四元数积分（一阶龙格库塔法）
    half_T = 0.5 * delta_T
    q0_temp = (-q1 * gx - q2 * gy - q3 * gz) * half_T
    q1_temp = (q0 * gx + q2 * gz - q3 * gy) * half_T
    q2_temp = (q0 * gy - q1 * gz + q3 * gx) * half_T
    q3_temp = (q0 * gz + q1 * gy - q2 * gx) * half_T

    # 更新四元数
    q0 += q0_temp
    q1 += q1_temp
    q2 += q2_temp
    q3 += q3_temp

    # 四元数归一化
    norm = math.sqrt(q0 ** 2 + q1 ** 2 + q2 ** 2 + q3 ** 2)
    q0 /= norm
    q1 /= norm
    q2 /= norm
    q3 /= norm

    # 计算欧拉角
    current_pitch = math.degrees(math.asin(2 * (q0 * q2 - q1 * q3)))
    current_roll = math.degrees(math.atan2(
        2 * (q0 * q1 + q2 * q3), 1 - 2 * (q1 ** 2 + q2 ** 2)))
    current_yaw = math.degrees(math.atan2(
        2 * (q0 * q3 + q1 * q2), 1 - 2 * (q2 ** 2 + q3 ** 2)))


# 零飘定义
gyrooffsetx = 0
gyrooffsety = 0
gyrooffsetz = 0
accoffsetx = 0
accoffsety = 0
accoffsetz = 0
OFFSETNUM = 1000


def imuoffsetinit():
    global accoffsetx, accoffsety, accoffsetz, gyrooffsetx, gyrooffsety, gyrooffsetz, OFFSETNUM
    for _ in range(OFFSETNUM):
        imu_data = imu.get()
        accoffsetx += imu_data[0]
        accoffsety += imu_data[1]
        accoffsetz += imu_data[2]
        gyrooffsetx += imu_data[3]
        gyrooffsety += imu_data[4]
        gyrooffsetz += imu_data[5]
    gyrooffsetx /= OFFSETNUM
    gyrooffsety /= OFFSETNUM
    gyrooffsetz /= OFFSETNUM
    accoffsetx /= OFFSETNUM
    accoffsety /= OFFSETNUM
    accoffsetz /= OFFSETNUM
    return gyrooffsetx, gyrooffsety, gyrooffsetz, accoffsetx, accoffsety, accoffsetz


main_point_item = 30
main_menu_flag = 1
car_go_flag = 0
speed_flag = 0
element_flag = 0
angle_pd_flag = 0
speed_pi_flag = 0
gyro_pi_flag = 0
ccd_image_flag = 0
parameter_flag = 0
screen_off_flag = 0
save_para_flag = 0


def menu(key_data):
    global main_menu_flag, car_go_flag, speed_flag, element_flag, angle_pd_flag, speed_pi_flag, gyro_pi_flag, ccd_image_flag, screen_off_flag, save_para_flag
    if (main_menu_flag == 1):
        main_menu()
    if (car_go_flag == 1):
        sec_menu_01()
    if (speed_flag == 1):
        sec_menu_02()
    if (element_flag == 1):
        sec_menu_03()
    if (angle_pd_flag == 1):
        sec_menu_04()
    if (speed_pi_flag == 1):
        sec_menu_05()
    if (gyro_pi_flag == 1):
        sec_menu_06()
    if (ccd_image_flag == 1):
        sec_menu_07()
    if (parameter_flag == 1):
        sec_menu_08()
    if (screen_off_flag == 1):
        sec_menu_09()
    if (save_para_flag == 1):
        sec_menu_10()

    gc.collect()


def main_menu():  # 一级菜单
    global main_point_item, main_menu_flag, car_go_flag, speed_flag, element_flag, angle_pd_flag, speed_pi_flag, gyro_pi_flag, ccd_image_flag, screen_off_flag, save_para_flag
    lcd.str24(60, 0, "main_menu", 0x07E0)
    lcd.str16(16, 30, "car_go", 0xFFFF)
    lcd.str16(16, 46, "speed", 0xFFFF)
    lcd.str16(16, 62, "element", 0xFFFF)
    lcd.str16(16, 78, "turn_pd", 0xFFFF)
    lcd.str16(16, 94, "vertical_pd", 0xFFFF)
    lcd.str16(16, 110, "motor_pi", 0xFFFF)
    lcd.str16(16, 126, "ccd_image", 0xFFFF)
    lcd.str16(16, 142, "parameter", 0xFFFF)
    lcd.str16(16, 158, "screen_off", 0xFFFF)
    lcd.str16(16, 174, "save_para", 0xFFFF)

    lcd.str12(0, main_point_item, ">", 0xF800)
    if key_data[0]:
        main_point_item += 16
        key.clear(1)
        if main_point_item == 190:
            main_point_item = 30

    if key_data[1]:
        main_point_item -= 16
        key.clear(2)
        if main_point_item == 14:
            main_point_item = 174

    if main_point_item == 30 and key_data[2]:
        main_menu_flag = 0
        car_go_flag = 1
        main_point_item = 30
        key.clear(3)
    if main_point_item == 46 and key_data[2]:
        main_menu_flag = 0
        speed_flag = 1
        main_point_item = 30
        key.clear(3)
    if main_point_item == 62 and key_data[2]:
        main_menu_flag = 0
        element_flag = 1
        main_point_item = 30
        key.clear(3)
    if main_point_item == 78 and key_data[2]:
        main_menu_flag = 0
        angle_pd_flag = 1
        main_point_item = 30
        key.clear(3)
    if main_point_item == 94 and key_data[2]:
        main_menu_flag = 0
        speed_pi_flag = 1
        main_point_item = 30
        key.clear(3)
    if main_point_item == 110 and key_data[2]:
        main_menu_flag = 0
        gyro_pi_flag = 1
        main_point_item = 30
        key.clear(3)
    if main_point_item == 126 and key_data[2]:
        main_menu_flag = 0
        ccd_image_flag = 1
        main_point_item = 30
        key.clear(3)
    if main_point_item == 142 and key_data[2]:
        main_menu_flag = 0
        parameter_flag = 1
        main_point_item = 30
        key.clear(3)
    if main_point_item == 158 and key_data[2]:
        main_menu_flag = 0
        screen_off_flag = 1
        main_point_item = 30
        key.clear(3)
    if main_point_item == 174 and key_data[2]:
        main_menu_flag = 0
        save_para_flag = 1
        main_point_item = 30
        key.clear(3)

    gc.collect()


def sec_menu_01():
    global aim_speed, speed_flag, main_menu_flag, main_point_item
    lcd.str24(60, 0, "car_go", 0x07E0)
    lcd.str16(16, 30, "return", 0xFFFF)
    lcd.str16(16, 46, "It's mygo", 0xFFFF)

    lcd.str12(0, main_point_item, ">", 0xF800)
    if key_data[0]:
        main_point_item += 16
        key.clear(1)
        if main_point_item == 62:
            main_point_item = 30
    if key_data[1]:
        main_point_item -= 16
        key.clear(2)
        if main_point_item == 14:
            main_point_item = 46
    if key_data[2] and main_point_item == 30:
        car_go_flag = 0
        main_menu_flag = 1
        key.clear(3)
        main_point_item = 30
    if key_data[2] and main_point_item == 46:
        aim_speed = 100
        key.clear(3)

    gc.collect()


def sec_menu_02():
    global speed_flag, main_menu_flag, aim_speed_l, aim_speed_r, main_point_item
    lcd.str24(60, 0, "speed", 0x07E0)
    lcd.str16(16, 62, "return", 0xFFFF)
    lcd.str16(16, 30, "aim_speed_l={}".format(aim_speed_l), 0xFFFF)
    lcd.str16(16, 46, "aim_speed_r={}".format(aim_speed_r), 0xFFFF)

    if key_data[0]:
        main_point_item += 16
        key.clear(1)
        if main_point_item == 78:
            main_point_item = 30

    if key_data[1]:
        main_point_item -= 16
        key.clear(2)
        if main_point_item == 14:
            main_point_item = 62

    if main_point_item == 30:
        if key_data[2]:
            aim_speed_l += 5
            key.clear(3)
        if key_data[3]:
            aim_speed_l -= 5
            key.clear(4)

    if main_point_item == 46:
        if key_data[2]:
            aim_speed_r += 5
            key.clear(3)
        if key_data[3]:
            aim_speed_r -= 5
            key.clear(4)
    if main_point_item == 62 and key_data[2]:
        main_menu_flag = 1
        speed_flag = 0
        main_point_item = 30
        key.clear(3)

    gc.collect()


# def sec_menu_03():  # 目前没用
#     lcd.str24(60, 0, "element", 0x07E0)  # 二级菜单标题
#     lcd.str16(16, 30, "return", 0xFFFF)  # 返回主菜单
#
#     if (flag is '左圆环1'):
#         lcd.str16(16, 110, 'left_round1', 0xFFFF)  # 左圆环1
#     elif (flag is '左圆环2'):
#         lcd.str16(16, 110, 'left_round1', 0xFFFF)  # 左圆环2
#     elif (flag is '右圆环1'):
#         lcd.str16(16, 110, 'right_round1', 0xFFFF)  # 右圆环1
#     elif (flag is '右圆环2'):
#         lcd.str16(16, 126, 'right_round2', 0xFFFF)  # 右圆环2
#     elif (flag is '斑马线'):
#         lcd.str16(16, 142, 'zebra', 0xFFFF)  # 斑马线
#
#     gc.collect()


def sec_menu_04():
    global main_point_item, main_menu_flag, angle_pd_flag
    lcd.str24(60, 0, "angle_pd", 0x07E0)
    lcd.str16(16, 30, "angle_KP={}".format(angle_pid.kp), 0xFFFF)
    lcd.str16(16, 46, "angle_Kp+/- 0.01", 0xFFFF)
    lcd.str16(16, 62, "angle_Kp+/- 0.1", 0xFFFF)
    lcd.str16(16, 78, "angle_KD={}".format(angle_pid.kd), 0xFFFF)
    lcd.str16(16, 94, "angle_KD+/- 0.01", 0xFFFF)
    lcd.str16(16, 110, "angle_KD+/- 0.1", 0xFFFF)

    lcd.str16(16, 126, "return", 0xFFFF)

    if key_data[0]:
        main_point_item += 16
        key.clear(1)
        if main_point_item == 142:
            main_point_item = 30

    if key_data[1]:
        main_point_item -= 16
        key.clear(2)
        if main_point_item == 14:
            main_point_item = 126

    if main_point_item == 46:
        if key_data[2]:
            angle_pid.kp += 0.01
            key.clear(3)
        if key_data[3]:
            angle_pid.kp -= 0.01
            key.clear(4)
    if main_point_item == 62:
        if key_data[2]:
            angle_pid.kp += 0.1
            key.clear(3)
        if key_data[3]:
            angle_pid.kp -= 0.1
            key.clear(4)
    if main_point_item == 94:
        if key_data[2]:
            angle_pid.kd += 0.01
            key.clear(3)
        if key_data[3]:
            angle_pid.kd -= 0.01
            key.clear(4)
    if main_point_item == 110:
        if key_data[2]:
            angle_pid.kd += 0.1
            key.clear(3)
        if key_data[3]:
            angle_pid.kd -= 0.1
            key.clear(4)
    if main_point_item == 126:
        if key_data[2]:
            key.clear(3)
            angle_pd_flag = 0
            main_menu_flag = 1
            main_point_item = 30

    gc.collect()


def sec_menu_05():
    global speed_pi_flag, main_menu_flag, main_point_item
    lcd.str24(60, 0, "speed_pi", 0x07E0)
    lcd.str16(16, 30, "speed_kp={}".format(speed_pid.kp), 0xFFFF)
    lcd.str16(16, 46, "speed_kp +/- 0.01", 0xFFFF)
    lcd.str16(16, 62, "speed_kp +/- 0.1", 0xFFFF)
    lcd.str16(16, 78, "speed_kd={}".format(speed_pid.ki), 0xFFFF)
    lcd.str16(16, 94, "speed_kd +/- 0.01", 0xFFFF)
    lcd.str16(16, 110, "speed_kd +/- 0.1", 0xFFFF)

    lcd.str16(16, 126, "return", 0xFFFF)
    if key_data[0]:
        main_point_item += 16
        key.clear(1)
        if main_point_item == 142:
            main_point_item = 30
    if key_data[1]:
        main_point_item -= 16
        key.clear(2)
        if main_point_item == 14:
            main_point_item = 126
    if main_point_item == 46:
        if key_data[2]:
            speed_pid.kp += 0.01
            key.clear(3)
        if key_data[3]:
            speed_pid.kp -= 0.01
            key.clear(4)
    if main_point_item == 62:
        if key_data[2]:
            speed_pid.kp += 0.1
            key.clear(3)
        if key_data[3]:
            speed_pid.kp -= 0.1
            key.clear(4)
    if main_point_item == 94:
        if key_data[2]:
            speed_pid.ki += 0.01
            key.clear(3)
        if key_data[3]:
            speed_pid.ki -= 0.01
            key.clear(4)
    if main_point_item == 110:
        if key_data[2]:
            speed_pid.ki += 0.1
            key.clear(3)
        if key_data[3]:
            speed_pid.ki -= 0.1
            key.clear(4)
    if main_point_item == 126:
        if key_data[2]:
            speed_pi_flag = 0
            main_menu_flag = 1
            main_point_item = 30
            key.clear(3)

    gc.collect()


def sec_menu_06():
    global main_point_item, main_menu_flag, gyro_pi_flag
    lcd.str24(60, 0, "gyro_pi", 0x07E0)
    lcd.str16(16, 30, "gyro_kp={}".format(gyro_pid.kp), 0xFFFF)
    lcd.str16(16, 46, "gyro_kp+/- 0.01", 0xFFFF)
    lcd.str16(16, 62, "gyro_kp+/- 0.1", 0xFFFF)
    lcd.str16(16, 78, "gyro_ki={}".format(gyro_pid.ki), 0xFFFF)
    lcd.str16(16, 94, "gyro_ki+/- 0.01", 0xFFFF)
    lcd.str16(16, 110, "gyro_ki+/- 0.1", 0xFFFF)

    lcd.str16(16, 126, "return", 0xFFFF)
    if key_data[0]:
        main_point_item += 16
        key.clear(1)
        if main_point_item == 142:
            main_point_item = 30
    if key_data[1]:
        main_point_item -= 16
        key.clear(2)
        if main_point_item == 14:
            main_point_item = 126
    if main_point_item == 46:
        if key_data[2]:
            gyro_pid.kp += 0.01
            key.clear(3)
        if key_data[3]:
            gyro_pid.kp -= 0.01
            key.clear(4)
    if main_point_item == 62:
        if key_data[2]:
            gyro_pid.kp += 0.1
            key.clear(3)
        if key_data[3]:
            gyro_pid.kp -= 0.1
            key.clear(4)
    if main_point_item == 94:
        if key_data[2]:
            gyro_pid.ki += 0.01
            key.clear(3)
        if key_data[3]:
            gyro_pid.ki -= 0.01
            key.clear(4)
    if main_point_item == 110:
        if key_data[2]:
            gyro_pid.ki += 0.1
            key.clear(3)
        if key_data[3]:
            gyro_pid.ki -= 0.1
            key.clear(4)
    if main_point_item == 126:
        if key_data[2]:
            gyro_pi_flag = 0
            main_menu_flag = 1
            main_point_item = 30
            key.clear(3)

    gc.collect()


def sec_menu_07():
    global main_point_item, main_menu_flag, ccd_image_flag, ccd_data1, ccd_data2
    lcd.str24(60, 0, "ccd,image", 0x07E0)
    lcd.str16(16, 30, "return", 0xFFFF)
    lcd.wave(0, 64, 128, 64, ccd_data1)
    lcd.wave(0, 64, 128, 64, ccd_data2)
    lcd.line(64, 64, 64, 192, color=0x001F, thick=1)
    if key_data[2]:
        ccd_image_flag = 0
        main_menu_flag = 1
        key.clear(3)

    gc.collect()


def sec_menu_08():
    global main_point_item, parameter_flag, error1, error2
    global Mid_point1, Mid_point2, tof_data, out_l, out_r, encl_data, encr_data
    global left_point_1, right_point_1, left_point_2, right_point_2
    lcd.str24(60, 0, "parameter", 0x07E0)  # 二级菜单标题
    lcd.str16(16, 30, "return", 0xFFFF)  # 返回主菜单

    lcd.str16(16, 46, "tof = {:<4d}".format(tof_data), 0xFFFF)  # TOF数据
    lcd.str16(16, 62, "out_l = {:<4d}".format(out_l), 0xFFFF)  # 左环pid输出
    lcd.str16(16, 78, "out_r = {:<4d}".format(out_r), 0xFFFF)  # 右环pid输出
    lcd.str16(16, 94, "encl = {:<4d}".format(encl_data), 0xFFFF)  # 左编码器值
    lcd.str16(16, 110, "encr = {:<4d}".format(encr_data), 0xFFFF)  # 右编码器值
    lcd.str16(16, 126, "Mid_point1 = {:<.2f}".format(
        Mid_point1), 0xFFFF)  # ccd1中点
    lcd.str16(16, 142, "Mid_point2 = {:<.2f}".format(
        Mid_point2), 0xFFFF)  # ccd2中点
    lcd.str16(16, 158, "error1 = {:<.2f}".format(error1), 0xFFFF)  # ccd1误差
    lcd.str16(16, 174, "error2 = {:<.2f}".format(error2), 0xFFFF)  # ccd2误差
    lcd.str16(16, 190, "left_point_1 = {:<3d}".format(
        left_point_1), 0xFFFF)  # 上摄像头左边点
    lcd.str16(16, 206, "right_point_1 = {:<3d}".format(
        right_point_1), 0xFFFF)  # 上摄像头右边点
    lcd.str16(16, 222, "left_point_2 = {:<3d}".format(
        left_point_2), 0xFFFF)  # 下摄像头左边点
    lcd.str16(16, 238, "right_point_2 = {:<3d}".format(
        right_point_2), 0xFFFF)  # 下摄像头右边点
    lcd.str16(16, 254, "width_1 = {:<3d}".format(
        right_point_1 - left_point_1), 0xFFFF)  # ccd1计算赛道宽度
    lcd.str16(16, 270, "width_2 = {:<3d}".format(
        right_point_2 - left_point_2), 0xFFFF)  # ccd2计算赛道宽度

    if main_point_item == 30:
        if key_data[2]:
            parameter_flag = 0
            main_menu_flag = 1
            key.clear(3)

    gc.collect()


def sec_menu_09():
    lcd.clear(0x0000)
    return


def sec_menu_10():
    #     write_flash()  # 写入缓冲区

    buzzer.value(1)  # 蜂鸣器开
    lcd.clear(0xF800)  # 清屏
    time.sleep_ms(100)  # 延时
    main_menu_item = 1  # 返回一级菜单
    buzzer.value(0)  # 蜂鸣器关


# 写入缓冲区
# def write_flash():
#     global angle_pid.kp, angle_pid.kd, speed_pid.kp, speed_pid.ki, aim_speed_l, aim_speed_r
#     os.chdir("/flash")  # 切换到 /flash 目录
#     try:
#         # 通过 try 尝试打开文件 因为 r+ 读写模式不会新建文件
#         user_file = io.open("user_data.txt", "r+")
#     except:
#         # 如果打开失败证明没有这个文件 所以使用 w+ 读写模式新建文件
#         user_file = io.open("user_data.txt", "w+")
#
#     # 将指针移动到文件头 0 偏移的位置
#     user_file.seek(0, 0)
#     # 使用 write 方法写入数据到缓冲区
#
#     user_file.write("%.4f\n" % (angle_pid.kp))
#     user_file.write("%.4f\n" % (angle_pid.kd))
#     user_file.write("%.4f\n" % (speed_pid.kp))
#     user_file.write("%.4f\n" % (speed_pid.ki))
#     user_file.write("%d\n" % (aim_speed_l))
#     user_file.write("%d\n" % (aim_speed_r))
#
#     # 将缓冲区数据写入到文件 清空缓冲区 相当于保存指令
#     user_file.flush()
#
#     # 将指针重新移动到文件头
#     user_file.seek(0, 0)
#     # 读取三行数据 到临时变量 分别强制转换回各自类型
#     data1 = float(user_file.readline())
#     data2 = float(user_file.readline())
#     data3 = float(user_file.readline())
#     data4 = float(user_file.readline())
#     data5 = int(user_file.readline())
#     data6 = int(user_file.readline())
#
#     # 最后将文件关闭即可
#     user_file.close()
# \\\\\\\\\\\\\\\\\\\\\\\\\\\\\\\\\\\\\\\\\\\\\\\\\\\\\\\\\\\\\\\\\\\\\\\\\\\\\\\\
imuoffsetinit()  # 零飘校准
last_imu_data = [0.0, 0.0, 0.0, 0.0, 0.0, 0.0, 0, 0, 0.0, 0.0]
while True:
    print("1")
    motor_l.duty(gyro_pid_out - dir_in_out)
    motor_r.duty(gyro_pid_out + dir_in_out)

    # 拨码开关关中断
    #     if end_switch.value() == 0:
    #         pit1.stop()  # pit1关闭
    #         pit2.stop()  # pit2关闭
    #         pit3.stop()  # pit3关闭
    #         break  # 跳出判断

    # 1ms中断标志位
    if (ticker_flag_1ms):
        imu_data = [float(x) for x in imu.get()]

        # 低通滤波处理（加速度计）
        alpha = 0.5
        for i in range(3):
            # 先进行零偏校正和单位转换
            current_processed = (
                                        imu_data[i] - [accoffsetx, accoffsety, accoffsetz][i]) / ACC_SPL
            # 再应用滤波，使用上一次的滤波结果
            imu_data[i] = alpha * current_processed + \
                          (1 - alpha) * last_imu_data[i]
            # 更新历史值为当前滤波结果
            last_imu_data[i] = imu_data[i]

        # 陀螺仪单位转换（减去偏移后除以灵敏度）
        for i in range(3, 6):
            imu_data[i] = math.radians(
                (imu_data[i] - [gyrooffsetx, gyrooffsety, gyrooffsetz][i - 3]) / GYRO_SPL)
        # 四元数更新（使用解包后的变量）
        ax, ay, az = imu_data[0], imu_data[1], imu_data[2]
        gx, gy, gz = imu_data[3], imu_data[4], imu_data[5]
        quaternion_update(ax, ay, az, gx, gy, gz)
        gc.collect()
        ticker_flag_1ms = False

    if (ticker_flag_5ms):
        print("中断")
        encl_data = encoder_l.get()  # 读取左编码器的数据
        encr_data = encoder_r.get()  # 读取右编码器的数据
        key_data = key.get()  # 读取按键的数据
        # 原函数此时为圆环处理
        menu(key_data)
        ticker_flag_5ms = False

    if (ticker_flag_2ms):
        gyro_pid_out = gyro_pid.calculate(
            0, imu_data[3] + imu_data[4] + imu_data[5])
        # gyro_pid.pid_standard_integral(0, imu_data[3] + imu_data[4] + imu_data[5])
        ticker_flag_2ms = False

    if (ticker_flag_10ms):
        # angle_pid_out = angle_pid.calculate(speed_pid_out + MedAngle, current_pitch)
        # !!!!!!!!!!!!!!!!!    pitch    记得改     !!!!!!!!!!!!!!!!!
        # angle_pid.pid_standard_integral(speed_pid.out + MedAngle, current_pitch)
        ticker_flag_10ms = False

    if (ticker_flag_50ms):
        # speed_pid_out = speed_pid.calculate(aim_speed, (encl_data + encr_data) / 2)
        # speed_pid.pid_standard_integral(aim_speed, (encl_data + encr_data) / 2)
        ticker_flag_50ms = False

    if (ticker_flag_4ms):
        # dir_in_out = dir_in.calculate(dir_out_out, imu[4])
        # dir_in.pid_standard_integral(dir_out.out, imu[4])
        ticker_flag_4ms = False

    if (ticker_flag_8ms):
        # dir_out_out = dir_out.calculate(0, (error1 + error2) * error_k)
        # dir_out.pid_standard_integral(0, (error1 + error2) * error_k)
        ticker_flag_8ms = False

    # ----------------------未改动参考代码----------------------
    #  if (ticker_flag_2ms):
    #      gyro_pid.pid_standard_integral(angle_pid.out, imu_data[4])
    #      ticker_flag_2ms = False

    #  if (ticker_flag_10ms):
    #      menu()                           # 菜单显示
    #      speed_pid.pid_standard_integral(aim_speed, (encl_data + encr_data) / 2)
    #      ticker_flag_10ms = False

    #  if (ticker_flag_50ms):
    #      angle_pid.pid_standard_integral(speed_pid.out + MedAngle, current_pitch)
    #      ticker_flag_50ms = False

    # if (ticker_flag_4ms):
    #    # dir_in.pid_standard_integral(dir_out.out, imu[4])
    #     ticker_flag_4ms = False

    # if (ticker_flag_8ms):
    #    # dir_out.pid_standard_integral(0, (error1 + error2) * error_k)
    #     ticker_flag_8ms = False
