infernotracter/NXP_2025/src_参考/RT1021_Library-master#3/Seekfree_RT1021_Opensource_Library/Project/USER/src/main.c

/*********************************************************************************************************************
 * COPYRIGHT NOTICE
 * Copyright (c) 2019,逐飞科技
 * All rights reserved.
 * 技术讨论QQ群：一群：179029047(已满)  二群：244861897
 *
 * 以下所有内容版权均属逐飞科技所有，未经允许不得用于商业用途，
 * 欢迎各位使用并传播本程序，修改内容时必须保留逐飞科技的版权声明。
 *
 * @file       		main
 * @company	   		成都逐飞科技有限公司
 * @author     		逐飞科技(QQ3184284598)
 * @version    		查看doc内version文件 版本说明
 * @Software 		IAR 8.3 or MDK 5.26
 * @Target core		NXP RT1021DAG5A
 * @Taobao   		https://seekfree.taobao.com/
 * @date       		2019-02-18
 ********************************************************************************************************************/


//整套推荐IO查看Projecct文件夹下的TXT文本


//打开新的工程或者工程移动了位置务必执行以下操作
//第一步 关闭上面所有打开的文件
//第二步 project  clean  等待下方进度条走完



#include "headfile.h"



        
        
int main(void)
{
	DisableGlobalIRQ();
    board_init();//务必保留，本函数用于初始化MPU 时钟 调试串口
	
	//此处编写用户代码(例如：外设初始化代码等)
    
	//总中断最后开启
    EnableGlobalIRQ(0);
    while (1)
    {
        //此处编写需要循环执行的代码        
    }
}
