infernotracter/NXP_2025/history_历史代码/7.18.13.50/menutext.py

from basic_data import *
from ccd_handler import *


class MenuText:
    def __init__(self):
        self.main_menu = True
        self.ccd_menu = False
        self.turn_menu = False
        self.speed_meun = False
        self.ring_menu = False
        self.key=[0,0,0,0]
        self.value = 31
        self.string_size = 16
        self.point = 30
        self.start_flag = 0
        self.turn_out_kp_move = 0
    def key_update(self, key_data):
        self.key = key_data
    def show_controll(self):
        if self.main_menu:
            self.show_main_menu()
        if self.ccd_menu:
            self.show_ccd_menu()
        if self.turn_menu:
            self.show_turn_menu()
        if self.speed_meun:
            self.show_speed_menu()
        if self.ring_menu:
            self.show_ring_menu()
    def point_move(self, hight, low,step):
        if self.key[1]:
            lcd.clear(0x0000)
            self.point += step
            key.clear(2)
            if self.point == hight + step:
                self.point = low
        if self.key[0]:
            lcd.clear(0x0000)
            self.point -= step
            key.clear(1)
            if self.point == low - step:
                self.point = hight
    def show_main_menu(self):
        lcd.str24(100, 30, "ccd", 0xFFFF)
        lcd.str24(100, 54, "turn", 0xFFFF)
        lcd.str24(100, 78, "speed", 0xFFFF)
        lcd.str24(100, 102, "ring", 0xFFFF)
        lcd.str24(0, self.point, "Ciallo~", 0xF800)
        self.point_move(102, 30 , 24)
        if self.point == 30 and self.key[2]:
            key.clear(3)
            self.main_menu = False
            self.ccd_menu = True
            self.point = 170
            lcd.clear(0x0000)
        
        if self.point == 54 and self.key[2]:
            lcd.clear(0x0000)
            self.turn_menu = True
            self.main_menu = False
            self.point = 30
            key.clear(3)
        if self.point == 78 and self.key[2]:
            lcd.clear(0x0000)
            self.speed_meun = True
            self.main_menu = False
            self.point = 30
            key.clear(3)
        if self.point == 102 and self.key[2]:
            lcd.clear(0x0000)
            self.ring_menu = True
            self.main_menu = False
            self.point = 30
            key.clear(3)
        
    def show_ccd_menu(self):
        lcd.wave(0,  0, 128, 64, ccd_near.data, max = 255)
        lcd.wave(0,  64, 128, 64, ccd_far.data, max = 255)
        lcd.str16(16 , 170, "value={}".format(ccd_controller.value), 0xFFFF)
        lcd.str16(16, 186,"return" , 0xFFFF)
        lcd.str16(16, 202,"error={:03}".format(ccd_controller.error),0xFFFF)
        lcd.str16(0, self.point, ">", 0xF800)
        self.point_move(186, 170,16)
        if self.point == 170:
            if self.key[2]:
                key.clear(3)
                ccd_controller.value += 1
                lcd.clear(0x0000)
            if self.key[3]:
                key.clear(4)
                ccd_controller.value -= 1
                lcd.clear(0x0000)
        if self.point == 186 and self.key[2]:
            key.clear(3)
            self.ccd_menu = False
            self.main_menu = True
            self.point = 30
            lcd.clear(0x0000)
    def show_turn_menu(self):
        lcd.str16(16, 30, "turn out kp={:.3f}".format(-71.2+self.turn_out_kp_move), 0xFFFF)
        lcd.str16(16, 46, "return", 0xFFFF)
        lcd.str16(0, self.point, ">", 0xF800)
        self.point_move(46, 30,16)
        if self.point == 30:
            if self.key[2]:
                key.clear(3)
                self.turn_out_kp_move += 0.1
                lcd.clear(0x0000)
            if self.key[3]:
                key.clear(4)
                self.turn_out_kp_move -= 0.1
                lcd.clear(0x0000)
        if self.point == 46 and self.key[2]:
            key.clear(3)
            self.turn_menu = False
            self.main_menu = True
            self.point = 30
            lcd.clear(0x0000)
    
    def show_speed_menu(self):
        lcd.str16(16, 30, "tmp_speed={}".format(speed_controller.tmp_speed), 0xFFFF)
        lcd.str16(16, 46, "start",0xFFFF)
        lcd.str16(16, 62, "return", 0xFFFF)
        lcd.str24(16, 100,"start_flag={}".format(self.start_flag),0xFFFF)
        lcd.str16(0, self.point, ">", 0xF800)
        self.point_move(62, 30,16)
        if self.point == 30:
            if self.key[2]:
                key.clear(3)
                speed_controller.tmp_speed += 1
                lcd.clear(0x0000)
            if self.key[3]:
                key.clear(4)
                speed_controller.tmp_speed -= 1
                lcd.clear(0x0000)
        if self.point == 46 and self.key[3]:
            key.clear(4)
            if self.start_flag == 0:
                ccd_controller.fix_error_value = 0
                ccd_controller.follow = 0
                ccd_controller.far = True
                element_gyro.data = 0
                element_distance.data = 0
                turn_in_pid.sum_error= 0.0
                elementdetector = 0
                self.start_flag=1
            else:
                ccd_controller.fix_error_value = 0
                ccd_controller.follow = 0
                ccd_controller.far = True
                element_gyro.data = 0
                element_distance.data = 0
                turn_in_pid.sum_error=0.0
                self.start_flag=0
            lcd.clear(0x0000)
        
        if self.point == 62 and self.key[2]:
            key.clear(3)
            self.speed_meun = False
            self.main_menu = True
            self.point = 30
            lcd.clear(0x0000)
    
    def show_ring_menu(self):
        lcd.str16(16, 30,"DISTANCE_ring3_data={}".format(elementdetector.DISTANCE_ring3_data), 0xFFFF)
        lcd.str16(16, 46, "DISTANCE_ring_in_data={}".format(elementdetector.DISTANCE_ring_in_data), 0xFFFF)
        lcd.str16(16, 62, "DISTANCE_outcoming_data={}".format(elementdetector.DISTANCE_ring_outcoming_data), 0xFFFF)
        lcd.str16(16, 78, "DISTANCE_ring_out_data={}".format(elementdetector.DISTANCE_ring_out_data), 0xFFFF)
        lcd.str16(16, 94, "ERROR_l_out_value={}".format(elementdetector.ERROR_l_out_value), 0xFFFF)
        lcd.str16(16, 110, "ring_speed={}".format(speed_controller.ring_speed), 0xFFFF)
        lcd.str16(16, 126,"state_clear",0xFFFF)
        lcd.str16(16, 142, "return", 0xFFFF)
        lcd.str16(0, self.point, ">", 0xF800)
        lcd.str32(0, 160, "gyro={:.2f}".format(element_gyro.data), 0xFFFF)
        lcd.str32(0, 192, "dis={:.2f}".format(element_distance.data), 0xFFFF)
        lcd.str32(0, 224, "state={}".format(elementdetector.state), 0xFFFF)
        self.point_move(142, 30,16)
        if elementdetector.prev_state != elementdetector.state:
            lcd.clear(0x0000)
        if self.point == 30:
            if self.key[2]:
                key.clear(3)
                elementdetector.DISTANCE_ring3_data += 5
                lcd.clear(0x0000)
            if self.key[3]:
                key.clear(4)
                elementdetector.DISTANCE_ring3_data -= 5
                lcd.clear(0x0000)
        if self.point == 46:
            if self.key[2]:
                key.clear(3)
                elementdetector.DISTANCE_ring_in_data += 5
                lcd.clear(0x0000)
            if self.key[3]:
                key.clear(4)
                elementdetector.DISTANCE_ring_in_data -= 5
                lcd.clear(0x0000)
        if self.point == 62:
            if self.key[2]:
                key.clear(3)
                elementdetector.DISTANCE_ring_outcoming_data += 5
                lcd.clear(0x0000)
            if self.key[3]:
                key.clear(4)
                elementdetector.DISTANCE_ring_outcoming_data -= 5
                lcd.clear(0x0000)
        if self.point == 78:
            if self.key[2]:
                key.clear(3)
                elementdetector.DISTANCE_ring_out_data += 5
                lcd.clear(0x0000)
            if self.key[3]:
                key.clear(4)
                elementdetector.DISTANCE_ring_out_data -= 5
                lcd.clear(0x0000)
        if self.point == 94:
            if self.key[2]:
                key.clear(3)
                elementdetector.ERROR_l_out_value += 1
                lcd.clear(0x0000)
            if self.key[3]:
                key.clear(4)
                elementdetector.ERROR_l_out_value -= 1
                lcd.clear(0x0000)

        if self.point == 110:
            if self.key[2]:
                key.clear(3)
                speed_controller.ring_speed += 1
                lcd.clear(0x0000)
            if self.key[3]:
                key.clear(4)
                speed_controller.ring_speed -= 1
                lcd.clear(0x0000)

        if self.point == 126 and self.key[2]:
            key.clear(3)
            elementdetector.state = RoadElement.normal
            lcd.clear(0x0000)
            
        if self.point == 142 and self.key[2]:
            key.clear(3)
            self.ring_menu = False
            self.main_menu = True
            self.point = 30
            lcd.clear(0x0000)
menu_controller=MenuText()
