infernotracter/NXP_2025/src_参考/CCD_Smart_Car-main/DeBug_Circle.py

from Find_Circle import *
from CCD_Tool import *

fullCircle = [
    [0, 0, 0, 0, 0, 0, 0, 0, 0, 0, 0, 0, 0, 0, 0, 0, 0, 0, 0, 0, 0, 0, 0, 0, 0, 0, 0, 0, 0, 0, 0, 0, 0, 0, 0, 0, 0, 0,
     0, 0, 0, 1, 1, 1, 1, 1, 1, 1, 1, 1, 1, 1, 1, 1, 1, 1, 1, 1, 1, 1, 1, 1, 1, 1, 1, 1, 1, 1, 1, 1, 1, 1, 1, 1, 1, 1,
     1, 1, 1, 1, 1, 1, 1, 0, 0, 0, 0, 0, 0, 0, 0, 0, 0, 0, 0, 0, 0, 0, 0, 0, 0, 0, 0, 0, 0, 0, 0, 0, 0, 0, 0, 0, 0, 0,
     0, 0, 0, 0, 0, 0, 0, 0, 0, 0, 0, 0, 0, 0],
    [1, 1, 1, 1, 0, 0, 0, 1, 1, 1, 1, 1, 1, 1, 1, 1, 1, 1, 1, 1, 1, 1, 1, 1, 1, 0, 0, 0, 0, 0, 0, 0, 0, 0, 0, 0, 0, 0,
     1, 1, 1, 1, 1, 1, 1, 1, 1, 1, 1, 1, 1, 1, 1, 1, 1, 1, 1, 1, 1, 1, 1, 1, 1, 1, 1, 1, 1, 1, 1, 1, 1, 1, 1, 1, 1, 1,
     1, 1, 1, 1, 0, 0, 0, 0, 0, 0, 0, 0, 0, 0, 0, 0, 0, 0, 0, 0, 0, 0, 0, 0, 0, 0, 0, 0, 0, 0, 0, 0, 0, 0, 0, 0, 0, 0,
     0, 0, 0, 0, 0, 0, 0, 0, 0, 0, 0, 0, 0, 0],
    [1, 1, 1, 1, 0, 0, 1, 1, 1, 1, 1, 1, 1, 1, 1, 1, 1, 1, 1, 1, 1, 1, 1, 1, 1, 1, 1, 1, 1, 1, 1, 1, 1, 1, 1, 1, 0, 0,
     1, 1, 1, 1, 1, 1, 1, 1, 1, 1, 1, 1, 1, 1, 1, 1, 1, 1, 1, 1, 1, 1, 1, 1, 1, 1, 1, 1, 1, 1, 1, 1, 1, 1, 1, 1, 1, 1,
     1, 1, 1, 0, 0, 0, 0, 0, 0, 0, 0, 0, 0, 0, 0, 0, 0, 0, 0, 0, 0, 0, 0, 0, 0, 0, 0, 0, 0, 0, 0, 0, 0, 0, 0, 0, 0, 0,
     0, 0, 0, 0, 0, 0, 0, 0, 0, 0, 0, 0, 0, 0],
    [1, 1, 1, 1, 1, 1, 1, 1, 1, 1, 1, 1, 1, 1, 1, 1, 1, 1, 1, 1, 1, 1, 1, 1, 1, 1, 1, 1, 1, 1, 1, 1, 1, 1, 1, 1, 1, 1,
     1, 1, 1, 1, 1, 1, 1, 1, 1, 1, 1, 1, 1, 1, 1, 1, 1, 1, 1, 1, 1, 1, 1, 1, 1, 1, 1, 1, 1, 1, 1, 1, 1, 1, 1, 1, 1, 1,
     1, 1, 0, 0, 0, 0, 0, 0, 0, 0, 0, 0, 0, 0, 0, 0, 0, 0, 0, 0, 0, 0, 0, 0, 0, 0, 0, 0, 0, 0, 0, 0, 0, 0, 0, 0, 0, 0,
     0, 0, 0, 0, 0, 0, 0, 0, 0, 0, 0, 0, 0, 0],
    [1, 1, 1, 1, 1, 1, 1, 1, 1, 1, 1, 1, 1, 1, 1, 1, 1, 1, 1, 1, 1, 1, 1, 1, 1, 1, 1, 1, 1, 1, 1, 1, 1, 1, 1, 1, 1, 1,
     1, 1, 1, 1, 1, 1, 1, 1, 1, 1, 1, 1, 1, 1, 1, 1, 1, 1, 1, 1, 1, 1, 1, 1, 1, 1, 1, 1, 1, 1, 1, 1, 1, 1, 1, 1, 1, 1,
     1, 1, 1, 1, 1, 1, 1, 0, 0, 0, 0, 0, 0, 0, 0, 0, 0, 0, 0, 0, 0, 0, 0, 0, 0, 0, 0, 0, 0, 0, 0, 0, 0, 0, 0, 0, 0, 0,
     0, 0, 0, 0, 0, 0, 0, 0, 0, 0, 0, 0, 0, 0],
    [1, 1, 1, 1, 1, 1, 1, 1, 1, 1, 0, 0, 0, 0, 0, 0, 0, 0, 0, 0, 0, 1, 1, 1, 1, 1, 1, 1, 1, 1, 1, 1, 1, 1, 1, 1, 1, 1,
     1, 1, 1, 1, 1, 1, 1, 1, 1, 1, 1, 1, 1, 1, 1, 1, 1, 1, 1, 1, 1, 1, 1, 1, 1, 1, 1, 1, 1, 1, 1, 1, 1, 1, 1, 1, 1, 1,
     1, 1, 1, 1, 1, 1, 1, 1, 1, 0, 0, 0, 0, 0, 0, 0, 0, 0, 0, 0, 0, 0, 0, 0, 0, 0, 0, 0, 0, 0, 0, 0, 0, 0, 0, 0, 0, 0,
     0, 0, 0, 0, 0, 0, 0, 0, 0, 0, 0, 0, 0, 0],
    [0, 0, 0, 0, 0, 0, 0, 0, 0, 0, 0, 0, 0, 0, 0, 0, 0, 0, 0, 0, 0, 0, 0, 0, 0, 0, 0, 0, 0, 1, 1, 1, 1, 1, 1, 1, 1, 1,
     1, 1, 1, 1, 1, 1, 1, 1, 1, 1, 1, 1, 1, 1, 1, 1, 1, 1, 1, 1, 1, 1, 1, 1, 1, 1, 1, 1, 1, 1, 1, 1, 1, 1, 1, 1, 1, 1,
     1, 1, 1, 1, 1, 1, 1, 1, 0, 0, 0, 0, 0, 0, 0, 0, 0, 0, 0, 0, 0, 0, 0, 0, 0, 0, 0, 0, 0, 0, 0, 0, 0, 0, 0, 0, 0, 0,
     0, 0, 0, 0, 0, 0, 0, 0, 0, 0, 0, 0, 0, 0],
    [0, 0, 0, 0, 0, 0, 0, 0, 0, 0, 0, 0, 0, 0, 0, 0, 0, 0, 0, 0, 0, 0, 0, 0, 0, 0, 0, 0, 0, 0, 0, 0, 0, 0, 0, 0, 0, 0,
     1, 1, 1, 1, 1, 1, 1, 1, 1, 1, 1, 1, 1, 1, 1, 1, 1, 1, 1, 1, 1, 1, 1, 1, 1, 1, 1, 1, 1, 1, 1, 1, 1, 1, 1, 1, 1, 1,
     1, 1, 1, 1, 1, 1, 0, 0, 0, 0, 0, 0, 0, 0, 0, 0, 0, 0, 0, 0, 0, 0, 0, 0, 0, 0, 0, 0, 0, 0, 0, 0, 0, 0, 0, 0, 0, 0,
     0, 0, 0, 0, 0, 0, 0, 0, 0, 0, 0, 0, 0, 0],
    [0, 0, 0, 0, 0, 0, 0, 0, 0, 0, 0, 0, 0, 0, 0, 0, 0, 0, 0, 0, 0, 0, 0, 0, 0, 0, 0, 0, 0, 0, 0, 0, 0, 0, 0, 0, 0, 0,
     1, 1, 1, 1, 1, 1, 1, 1, 1, 1, 1, 1, 1, 1, 1, 1, 1, 1, 1, 1, 1, 1, 1, 1, 1, 1, 1, 1, 1, 1, 1, 1, 1, 1, 1, 1, 1, 1,
     1, 1, 1, 1, 0, 0, 0, 0, 0, 0, 0, 0, 0, 0, 0, 0, 0, 0, 0, 0, 0, 0, 0, 0, 0, 0, 0, 0, 0, 0, 0, 0, 0, 0, 0, 0, 0, 0,
     0, 0, 0, 0, 0, 0, 0, 0, 0, 0, 0, 0, 0, 0],
    [0, 0, 0, 0, 0, 0, 0, 0, 0, 0, 0, 0, 0, 0, 0, 0, 0, 0, 0, 0, 0, 0, 0, 0, 0, 0, 0, 0, 0, 0, 0, 0, 0, 0, 0, 0, 1, 1,
     1, 1, 1, 1, 1, 1, 1, 1, 1, 1, 1, 1, 1, 1, 1, 1, 1, 1, 1, 1, 1, 1, 1, 1, 1, 1, 1, 1, 1, 1, 1, 1, 1, 1, 1, 1, 1, 1,
     1, 1, 1, 1, 1, 0, 0, 0, 0, 0, 0, 0, 0, 0, 0, 0, 0, 0, 0, 0, 0, 0, 0, 0, 0, 0, 0, 0, 0, 0, 0, 0, 0, 0, 0, 0, 0, 0,
     0, 0, 0, 0, 0, 0, 0, 0, 0, 0, 0, 0, 0, 0],
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

ccdSuper = angle = key_4 = Key_1 = Key_2 = flag = Statu = isCircleNow = mid_line = 0
left_edge = right_edge = alreadyOutCircle = outCircle = isCircleNow = checkCircle = goCircle = findCircleTimes = barrierNow = roadWidth = 0
mid_line2 = mid_line = 64
leftOrRight = "nothing"

for ccd_data1 in fullCircle:
    """ ++++++++++++++++++++++++++++++++++++++++++++++++++++++++++++
    Tips: 环岛部分
    +++++++++++++++++++++++++++++++++++++++++++++++++++++++++++++"""
    left_edge, right_edge, mid_line = find_road_edges(ccd_data1, mid_line)  # 计算左右边界与中线
    left_edge2, right_edge2, mid_line2 = find_road_edges(ccd_data1, mid_line2)  # 计算左右边界与中线
    ccdSuper = 64 - mid_line  # CCD1的误差值
    ccdSuper2 = 64 - mid_line2  # CCD2的误差值
    lastWidth = roadWidth  # 上一次的道路宽度，用于判断避障和环中点
    roadWidth = abs(left_edge - right_edge)  # 这一次的道路宽度

    if leftOrRight == "nothing":  # 防止在找到入环标志后，在后续的跑道中再次误判圆环
        isCircleNow, leftOrRight = is_circle(ccd_data1)  # isCircleNow为是否检测到环，leftOrRight为左环还是右环
        print(isCircleNow, leftOrRight)

    """第一步，寻找入环标志：左侧和中间同时出现白色区域，即白黑白"""
    if (isCircleNow == True) and (goCircle == False) and (checkCircle == 0):  # 防止二次判环将goCircle的标志位刷掉，后续赛道存在多个环可以更改此处逻辑
        # 当goCircle 不为True时，进行入环检测，如果goCircle已经变成True，代表在之前已经检测到环
        findCircleTimes += 1  # 每读到一次入环标志，就将findCircleTimes +1，连续n次读到即进入入环状态
        if findCircleTimes == 2:  # 目前n为2
            checkCircle = 1  # 将checkCircle置1，代表进入入环状态
            print("进入入环状态")
            findCircleTimes = 0

    """第二步，找到环中点，进行强制打角"""
    if checkCircle:
        filled_mid_line = fill_line(ccd_data1, leftOrRight, checkCircle)  # 确定补线后的中线
        ccdSuper = 64 - filled_mid_line  # 补线状态下的误差值,覆盖之前的ccdSuper,防止被前半段圆环误判左转
        print(f"此时补线后的中线:{filled_mid_line}")
        goCircle = Go_circle_now(ccd_data1, lastWidth)  # 如果检测到环中点，将goCircle置为True
        if goCircle:
            # 在完成入环后,进入基础的循迹逻辑,环岛运行过程中一般是丢一边线的单边循迹，通过强制打角即可进入环岛
            if leftOrRight == "left":
                print("入环左打角\n")
                checkCircle = 0  # 此时置0，退出补线逻辑
            if leftOrRight == "right":
                print("入环右打角\n")
                checkCircle = 0  # 此时置0，退出补线逻辑

    """第三步，在完成环岛动作后，应用出环逻辑强制出环"""
    # 一旦找到十字路口的样式,代表找到了出环位置(左右均全白),此时强制打角出环,然后调用ccd_data2进行直线循迹
    outCircle = (detect_intersection(ccd_data1)) or outCircle and alreadyOutCircle != 1
    if outCircle and goCircle:
        print("找到十字路口")
        alreadyOutCircle = 1  # 每次只进行一次出环动作
        if leftOrRight == "left":
            print("出环左打角\n")
        if leftOrRight == "right":
            print("出环右打角\n")

    """第四步，切换ccd2来读取数据(ccd2读的更远，不会被干扰)，确保成功进入直道"""
    if leftOrRight != "nothing" and goCircle and outCircle:  # 已经完成了入环判断，入环打角，出环打角
        ccdSuper = ccdSuper2  # 切换ccd2读取的数据来循迹，因为ccd1会被环岛白色区域误判
        if abs(ccdSuper) < 8 and abs(ccdSuper2) < 8:
            leftOrRight = "alreadyFindCircle"  # 当两个ccd都读到直道，将leftOrRight清除，退出环岛逻辑
