infernotracter/NXP_2025/src_参考/CCD_Smart_Car-main/MakeImage.py

import matplotlib.pyplot as plt
from CCD_Tool import find_road_edges
from Get_CCD import read_ccd_data, search
# 十字路口的数据
cross1 = [
[789,803,817,601,252,241,249,268,299,377,476,572,651,736,812,819,800,753,683,605,516,458,408,381,384,363,364,356,362,349,356,322,331,396,486,541,553,662,694,665,694,683,683,621,534,489,629,978,1137,985,1108,1187,1409,1348,1531,1837,1609,694,579,693,732,759,1021,864,758,748,693,588,534,449,389,418,387,313,326,354,323,421,386,326,309,336,315,313,336,330,403,493,486,387,321,276,275,376,532,630,749,1116,1702,2312,2858,3429,3267,3037,2898,2774,2729,2665,1306,397,364,340,326,304,297,288,279,269,268,114,115,115,115,107,145,168,171,177],
[193,198,206,202,201,204,220,214,209,213,226,226,235,223,236,240,243,235,243,237,242,243,249,245,247,242,248,241,257,250,262,251,259,260,262,255,267,269,273,279,283,265,285,288,294,291,297,277,252,258,639,793,820,818,826,835,833,828,824,830,832,837,832,842,857,872,894,898,891,879,881,852,839,819,821,812,807,799,799,793,788,778,794,785,791,807,818,816,815,800,804,794,767,421,301,286,307,291,283,275,275,276,273,276,274,266,266,255,255,245,245,237,238,240,242,226,227,223,223,217,213,205,220,220,214,123,133,126],
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
ImageCreate(left, "left")
"""

def ImageCreate(ccd_data, name, lastMiddlePosition=64,midline = None):
    left_edge, right_edge, mid_line = find_road_edges(ccd_data,lastMiddlePosition)
    plt.figure(figsize=(8, 6))
    plt.plot(ccd_data, label=name, color='red')
    plt.axvline(x=mid_line, color='blue', linestyle='-', label='Middle Line')
    plt.axvline(x=64, color='black', linestyle='--', label='x=64')
    if midline:
        plt.axvline(x=midline, color='#006400', linestyle='--', label='CircleFilledMidline')

    plt.title(name)
    plt.xlabel(f'left, mid_line, right: {left_edge, mid_line, right_edge}')
    plt.ylabel('Value')
    plt.legend()
    plt.show()




def ImageCreate2(ccd_data1, name1, ccd_data2, name2,
lastMiddlePosition1=64, lastMiddlePosition2=64, midline1=None, midline2=None):

    left_edge1, right_edge1, mid_line1 = find_road_edges(ccd_data1, lastMiddlePosition1)
    left_edge2, right_edge2, mid_line2 = search(ccd_data2)
    fig, (ax1, ax2) = plt.subplots(1, 2, figsize=(8, 4))

    # Plot for ccd_data1
    ax1.plot(ccd_data1, label=name1, color='red')
    ax1.axvline(x=mid_line1, color='blue', linestyle='-', label='Middle Line')
    ax1.axvline(x=64, color='black', linestyle='--', label='x=64')
    if midline1:
        ax1.axvline(x=midline1, color='#006400', linestyle='--', label='CircleFilledMidline')
    ax1.set_title(name1)
    ax1.set_xlabel(f'left, mid_line, right: {left_edge1, mid_line1, right_edge1}')
    ax1.set_ylabel('Value')
    ax1.legend()

    # Plot for ccd_data2
    ax2.plot(ccd_data2, label=name2, color='green')
    ax2.axvline(x=mid_line2, color='purple', linestyle='-', label='Middle Line')
    ax2.axvline(x=64, color='black', linestyle='--', label='x=64')
    if midline2:
        ax2.axvline(x=midline2, color='#FFD700', linestyle='--', label='CircleFilledMidline')
    ax2.set_title(name2)
    ax2.set_xlabel(f'left, mid_line, right: {left_edge2, mid_line2, right_edge2}')
    ax2.set_ylabel('Value')
    ax2.legend()

    plt.tight_layout()
    plt.show()



for i in range(0, len(cross1)):
    ccd_data = read_ccd_data(cross1[i], cross2[i], 500, 500,0)
    originCcdData = cross2[i]
    ImageCreate2(ccd_data[1], "ccd1", originCcdData, "ccd1")
"""
for i in range(0,len(fullCircle_ccd1)):
    ImageCreate2(fullCircle_ccd1[i],"ccd1", fullCircle_ccd2[i], "ccd2")

"""
