infernotracter/NXP_2025/src_参考/CCD_Smart_Car-main/Find_Circle.py

from CCD_Tool import find_road_edges

def is_circle(ccd_data1, ccd_data2):
    """
    作用: 通过分析CCD数据，判断是否进入环岛并检测环岛的方向（左环或右环）。
    参数:
    ccd_data1 (list): 第一个CCD传感器的二值化数据，其中1表示道路，0表示非道路。
    ccd_data2 (list): 第二个CCD传感器的二值化数据，用于进一步确认环岛的存在和方向。
    返回值: tuple:
    如果未检测到环岛，则返回 (False, "nothing")
    如果检测到可能的环岛，则返回一个包含两个元素的元组 (True, direction)；
    其中 direction 表示环岛方向 ("left" 或 "right")。
    """

    debug = 0  # debug == 1时，Print出每个值来判断哪里有问题
    left_edge1, right_edge1, mid_line1 = find_road_edges(ccd_data1)
    left_edge2, right_edge2, mid_line2 = find_road_edges(ccd_data2)
    width1 = abs(left_edge1 - right_edge1)
    width2 = abs(left_edge2 - right_edge2)

    if debug:
        print(f"step1: mid_line1={mid_line1},mid_line2={mid_line2}")
        print(f"step2: left_edge2={left_edge2},right_edge2={right_edge2},width2 = {width2}")

    # Step1：判断近端CCD中线是否在 64 ± 10 以内且宽度为直道的宽度
    if abs(mid_line1 - 64) < 10 and abs(width1 - 42) < 10:

        # Step2：如果左边缘坐标不变但是总宽度变大，代表右环
        if abs(left_edge2 - 40) <= 10 and width2 > 50:
            # Step3 检查右环的条件
            for i in range(105, 126):
                if ccd_data2[i:i - 6:-1] == [1] * 6:
                    return True, "right"

        # Step2：如果右边缘坐标不变但是总宽度变大，代表左环
        if abs(right_edge2 - 80) <= 10 and width2 > 50:
            # Step3: 检查左环的条件
            for i in range(5, 26):
                if ccd_data2[i:i + 6:1] == [1] * 6:
                    return True, "left"

    return False, "nothing"



"""
函数名: Go_circle_now
作用: 通过比较两组CCD数据的宽度变化来判断是否达到环岛的中点位置，以便决定是否开始环岛导航。

参数:
ccd_data1 (list): 第一个CCD传感器的二值化数据，用于检测环岛的中点位置。
ccd_data2 (list): 第二个CCD传感器的二值化数据，用于与第一个传感器的数据进行比较，以确认是否进入环岛中点。
last_width (int, optional): 上一次测量的宽度，默认值为45。此参数用于与当前宽度进行比较，判断是否进入环岛中点。

返回值: bool:
如果检测到已经到达环岛的中点位置，则返回 True。
如果未到达环岛的中点位置，则返回 False。

说明:
此函数首先使用 find_road_edges 函数从两个CCD数据中获取道路的左边界、右边界和中线位置。
根据第一个CCD数据计算当前道路宽度，如果宽度大于45（表示车辆可能接近环岛中心），函数将进一步检查：
1. 比较上一次测量的宽度（last_width）和当前宽度，判断宽度是否显著减小，减小超过5个单位视为可能到达环岛中点。
2. 比较第二组CCD数据的宽度与第一组的宽度，第二组的宽度应大于第一组，因为第二组CCD扫描到的是第一组前面的更广区域。
如果这些条件满足，函数将返回 True，表示车辆可能已经到达环岛中点，可以开始执行环岛导航程序。
"""
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
