infernotracter/NXP_2025/(commit log)

2025-02-14 还需要定义全局变量，完成PID
2025-02-14 add zyc.py. 添加了转向环的走直线抑制转向，修改了直立环的错误。
2025-02-16 別人的代碼，可以好好參考一下
2025-02-18 PID大修改
2025-02-19 加入项目
    [ANO_DT.obj, LQ_ADC.obj, LQ_Encoder.obj, LQ_GPIO_EXIT.obj, LQ_GPIO_KEY.obj, LQ_GPIO_LED.obj, LQ_I2C.obj, LQ_ICM20689.obj]
2025-02-19 再来资料
2025-02-21 重写PID
2025-02-21 add zyc_2_21.py. 修改了菜单变量
2025-02-21 转向PID 1
2025-02-21 使得PID的调节更加平滑，减少了PID的抖动（）
2025-02-21 滤波改，转向小改
2025-02-22 祖传代码库 - 代码库 - Seekfree_TC377_Opensource_Library
2025-02-23 姿态解算全局
2025-02-23 姿态解算封装，还差滤波没写
2025-02-24 滤波改参数，看那个更好
2025-02-24 简单积分法
2025-02-24 姿态角方案 + 可视化
2025-02-24 一阶滤波更新
2025-02-24 一阶滤波改
2025-02-25 磁场测试完全体
2025-02-25 pid改
2025-02-25 pid纯
2025-02-27 加了菜单
2025-03-06 对寒假的菜单进行了一个改
2025-03-06 解决了显示问题
2025-03-06 pid调试中
2025-03-07 为什么代码里会有gyro输出扩大函数？我改了，看看行不
2025-03-10 左轮速度为10
2025-03-10 加入了ticker的改动
2025-03-13 PID小改
2025-03-15 更新了官方文档的内容
2025-03-15 解算调节
2025-03-20 add src/模板.
2025-03-24 3_24_CCD小改
2025-03-24 进行大的规整代码
2025-03-25 模块化大改
2025-03-25 改bug ing
2025-03-25 改了ticker
2025-03-26 WIFI 真TM好用
2025-03-30 重构PID计时器逻辑，合并计数器并优化回调函数
2025-03-30 添加TickerProfiler类以优化时间间隔监控和调试信息输出
2025-03-30 重构PIT计时器逻辑，优化方向计数器并添加IMU处理类
2025-03-30 重构IMU处理类，优化数据处理逻辑并添加PID和TickerProfiler类
2025-03-30 修复IMUHandler类中的变量命名，统一使用大写字母开头的属性名
2025-03-30 菜单文件
2025-03-30 重构主程序，移除冗余代码并整合IMU处理逻辑，优化数据更新和输出
2025-03-30 移除冗余空行，优化代码结构并引入菜单文本模块
2025-03-30 基本数据
2025-03-31 能用了，ticker还没改完
2025-04-02 重命名IMU定时器标志，优化定时器回调逻辑，调整定时器启动间隔
2025-04-02 添加 boot.py、basic_data.py、imu_handler.py 和 ccd_handler.py 文件，包含软启动控制、基本数据处理和IMU处理逻辑
2025-04-02 CCDHander,添加多个 .keep 文件以保持目录结构
    [MIMXRT1021xAFxx核心板V1.1原理库.SchLib, MIMXRT1021xAFxx核心板V1.1封装库.PcbLib, rs380 motor.SLDPRT, 一体模具.SLDASM, 三寸桨保护罩.STL, 三英寸桨保护罩.SLDPRT, 侧壁.SLDPRT, 侧壁.STL]
2025-04-03 好样的串级pid
2025-04-05 Add wireless tuner GUI and PID parameter adjustments
    - Implemented a wireless tuner application using Tkinter for serial communication and parameter adjustments.
    - Added functionality to connect to serial ports and send/receive data.
    - Created a user interface with sliders for tuning parameters and a section for waveform display.
    - Introduced a new PID parameter configuration file with specified values for speed, angle, and gyro control.
    - Enhanced the CCD processing script with improved filtering and thresholding methods for image data.
2025-04-07 添加 CCDHandler 类及其方法，实现 CCD 数据处理和中点计算逻辑
2025-04-07 添加元素检测器类及相关逻辑，更新用户主程序以支持元素标志
2025-04-09 优化 CCDHandler 类，重命名属性以提高可读性，更新中点计算逻辑，调整用户主程序中的陀螺仪积分处理
2025-04-09 重构 CCDHandler 类，统一更新方法名称，优化中点计算逻辑，增强元素检测器类的检测功能
2025-04-09 更新 get_mid_point 方法，添加 follow 参数以支持边线补偿逻辑；优化 ElementDetector 类，调整右圆环检测逻辑注释
2025-04-12 更新 C/C++ 配置文件以支持 Windows 环境；添加 Gyro_Z_Test 类及相关逻辑，优化用户主程序中的陀螺仪数据处理
2025-04-13 用imu积分过圆环的可行
2025-04-13 class Gyro_Z_Test不能放在其他文件，不到为啥
2025-04-13 CCD中点能跑的代码
2025-04-13 优化CCDHandler类中的中点计算逻辑，修复了边界条件处理；
2025-04-13 修改文件路径
2025-04-14 pid基本好了
2025-04-14 重构CCDHandler类，添加check_tuple函数以处理边界条件，移除Gyro_Z_Test类到ccd_hander.py中
2025-04-14 sb代码
2025-04-14 更新ElementDetector类，移除陀螺仪趋势验证逻辑，调整相关常量命名
2025-04-14 ccd——mid能用了
    ccd——mid能用了
2025-04-15 移除冗余代码，简化CCD处理逻辑，调整相关打印信息
2025-04-16 修正CCDHandler类中左右边点的强制赋值逻辑，优化中点计算条件；移除user_main.py中的冗余导入和调试打印信息
2025-04-17 修正CCDHandler类中左右边点的强制赋值逻辑，新增check_peak和check_peak_mid方法以优化峰值检测
2025-04-17 十字仿函数
2025-04-17 修正CCDHandler类中last_mid和mid的初始值，确保数据处理的正确性
2025-04-18 重构CCDHandler类中的阈值计算和中点计算逻辑，优化代码可读性并添加行驶距离类的注释
2025-04-20 更新README.md，添加圆环识别步骤及相关问题描述，增强文档的清晰度和可读性
2025-04-30 圆环识别部分和十字完成
2025-04-30 添加了单边循迹github代码
    [RT1064核心板丝印与芯片引脚对应表格.xlsx]
2025-05-06 可达鸭循迹bug修改
2025-05-06 修改自己的圆环
2025-05-06 优化CCDHandler类中的get_mid_point和midpoint_invalid方法，增强边线检测逻辑
2025-05-07 重构MovementType类，添加默认值并清理无用代码
2025-05-09 ！圆环大改
2025-05-09 为MovementType类添加初始化方法和更新方法；清理ccd_hander.py中的无用代码
2025-05-09 修正CCDHandler和ElementDetector类中的注释，优化状态检测逻辑，清理无用代码
2025-05-09 调整电机控制参数，增加最大占空比至10000，延长循环间隔至250ms，修正占空比更新逻辑
2025-05-12 发车模式bug修改
2025-05-12 元素判断多重if来优化代码
2025-05-14 删除 CCDHandler 和 ElementDetector 类及相关函数，简化代码结构
2025-05-14 Mode与ccd联动
2025-05-14 加入蜂鸣器
2025-05-15 ccd变成类调用类，test
2025-05-15 调pid中
2025-05-16 修复已知问题
2025-05-16 学习板直立
2025-05-16 新车模数据
2025-05-16 去掉例程的多余输出
2025-05-16 aim_speed修改
2025-05-16 全局aim_speed
2025-05-17 aim_speed修改，speed_k修改
2025-05-17 修复aim_speed变量引用，确保运动控制逻辑正确
2025-05-17 新车pid
2025-05-17 小车无抗性
2025-05-18 自己的圆环识别的修改
2025-05-18 ccd范围bug
2025-05-18 bug之无穷匮也/_ \
2025-05-18 tof测试
2025-05-19 ccd障碍检测
2025-05-19 自动边线bug
2025-05-19 imu_kp值修改
2025-05-19 调车直立OK了
2025-05-21 5.21自己板调参
2025-05-23 尝试编码器滤波解决速度环问题
2025-05-24 5.24调参
2025-05-25 debug菜单
2025-05-25 取消斑马线注释
2025-05-25 debug菜单返回
2025-05-25 优化元素检测器，修正 CCD 数据更新逻辑以提高准确性
2025-05-25 圆环误判修改
2025-05-25 5.25调参
2025-05-25 5.26凌晨
2025-05-26 稳定圆环入环识别
2025-05-26 直立60
2025-05-26 圆环元素操作
2025-05-26 更新CCDHandler类中的read_mid_point方法，修改文档字符串并添加follow参数的处理；新增ccd_controller类以管理CCD实例；重命名_left_out方法为_left_outcoming以提高可读性；在ElementDetector类中实现新的_left_outcoming逻辑；添加desktop.ini文件以配置文件夹视图。
2025-05-26 menu修改
2025-05-26 调整CCDHandler和ElementDetector类中的逻辑，修正follow参数的使用；更新mid_point获取方法以确保一致性；重命名相关状态以提高可读性。
2025-05-26 motor_controller小改进
2025-05-26 menu, distance, gyro
2025-05-27 输出显示
2025-05-27 motorcontroller turnturnturn
2025-05-27 元素操作完善
2025-05-27 开局直立，按键发车
2025-05-28 5.28调参
2025-05-28 修复PIT ticker模块回调函数，调整imu捕获列表参数
2025-05-29 单边循迹修改
2025-05-29 找到边线跟随的问题
2025-05-30 稳定进出圆环
2025-05-30 除十字外完赛
2025-05-30 十字修改
2025-05-31 注释掉的改回来
2025-05-31 -40速度
2025-06-01 防误判加强
2025-06-01 牢大速度
2025-06-06 弯道减速+dis
2025-06-08 圆环不需要减速
2025-06-12 没加十字
2025-06-29 文件整理
2025-07-03 只改了速度
2025-07-03 增加对cross_lost状态的处理逻辑，添加cross_lost_out方法以判断状态恢复
2025-07-04 feat: Implement core functionality for user_main.py
    - Added essential libraries and modules for the project.
    - Created a roll checker function to monitor roll data.
    - Implemented PID control algorithms for speed and angle adjustments.
    - Established ticker callbacks for periodic tasks.
    - Integrated IMU data handling and filtering.
    - Developed control logic for motor outputs based on PID calculations.
    - Set up wireless data handling for real-time parameter adjustments.
    - Included debugging and profiling features for performance monitoring.
    - Initialized movement types and road element detection.
2025-07-04 tof没测试
2025-07-05 坡道完美检测
2025-07-05 图片角度参考
2025-07-05 更新根目录
2025-07-05 刚好上坡
2025-07-05 坡道当电赛秒了
2025-07-08 7.8弯道圆环需要调
2025-07-10 openart完赛
2025-07-10 去掉了弯道减速
2025-07-10 机械零点
2025-07-10 100速度
2025-07-10 无元素两米7.10
2025-07-11 板子吱吱响
2025-07-11 替换test
2025-07-11 慢速尝试元素
2025-07-13 菜单测试
2025-07-14 修bug
2025-07-15 右圆环出环
2025-07-15 发车菜单
2025-07-15 改圆环速度
2025-07-16 tof模式
2025-07-20 近远端ccd
2025-07-20 校赛代码
