infernotracter/NXP_2025/(notices)

Notices in the files:
src_主要/Seekfree_TC377_Opensource_Library/user/cpu0_main.c:
Copyright (c) 2022 SEEKFREE Öð·É¿Æ¼¼
src_参考/RT1021_Library-master#3/Seekfree_RT1021_Opensource_Library/Project/USER/src/main.c:
Copyright (c) 2019,Öð·É¿Æ¼¼
All rights reserved.
